Egoruch/HC12/wiring diagram/images/pcb_radiosens_v1.png

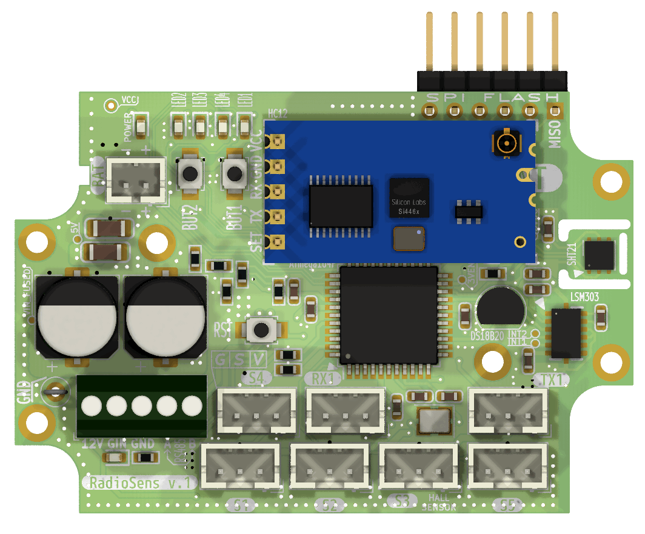
wiring diagram/images/pcb_radiosens_v1.png
