Egoruch/HC12/reports/20221003/1.jpg

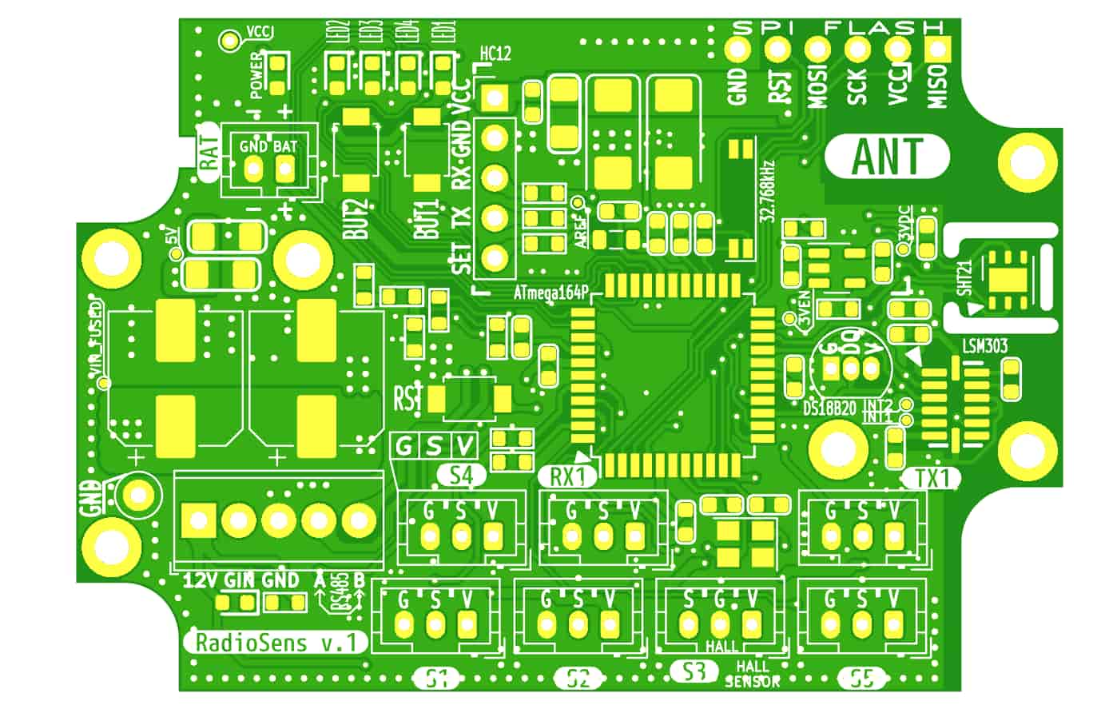
reports/20221003/1.jpg
