Egoruch/HC12/bom/BOM_NOTES.txt

На базе BQ3 заменен на выводоной кварцевый резонатор 3.6864 МГц в корпусе HC49/S
На датчике предохранитель заменен резистором 0 Ом
Датчик температуры DA4 SHT21 не установлен на плате (вместо него установлен DD3 DS18B20)
Компоненты с DNP в поле Assembly не устанавливаются по умолчанию
Подтяжки для любых датчиком, подключаемых к разъему могут быть установлены (имеются посадочные места)
Для базы и датчика установку компонентов смотреть на плате
