Egoruch/HC12/files/raspinovka.txt

Распмновка меги

1 int1 - Вход датчика 2
2 T0   - Вход датчика 3 
3 gnd
4 vpp
5 gnd
6 vpp
7 кварц
8 кварц
9 t1   - Вход датчика 4
10 ain0 - rx hc-12
11 ain1 - tx hc-12
12 icp1 - set hc-12
13 oc1a - 1ware DS18B20
14 oc1b - rs485 set
15 mosi - разьем програматора, подтяжка 4к7 в vpp, кнопка
16 miso - разьем програматора, подтяжка 4к7 в vpp, кнопка
17 sck  - разьем програматора, подтяжка 4к7 в vpp, кнопка
18 avcc - емкость на землю, индуктивность на VPP
19 NC
20 ---
21 gnd
22 NC
23 ADC0 - вход измерения напряжения батареи
24 ADC1
25 ADC2 - led1
26 ADC3 - led2
27 SDA  - i2c
28 SLC  - i2c
29 reset - разьем програматора
30 rxd - rs485 tx
31 txd - rs485 rx
32 int0 - Вход датчика 1

 ATMEGA  164p 324p

1  MOSI - Разьем програматора
2  MISO - Разьем програматора
3  SCK  - Разьем програматора
4  Reset - Разьем програматора
5  VCC - Разьем програматора
6  GND - Разьем програматора
7  Xtal2 - кварц
8  Xtal1 - кварц
9  TXD0 - на rs485
10 RXD0 - на rs485
11 RXD1 -  HC-12
12 TXD1 -  HC-12
13      - на rs485 set 
14      - 1ware DS18B20
15
16
17 VCC
18 GND
19 SLC  - i2c
20 SDA  - i2c
21
22
23
24
25 TOSK1 - кварц 32718 Кгц
26 TOSK2 - кварц 32718 Кгц 
27 AVCC - питание аналоговой части
28 GND 
29 AREF -
30 ADC7 - кнопка
31 ADC6 - кнопка
32 ADC5 - Led
33 ADC4 - Led
34 ADC3 - Led
35 ADC2 - Led
36
37 ADC0 - вход измерения напряжения батареи
38 VCC
39 GND
40 T0   - датчик
41 T1   - датчик
42 Int2 - датчик
43      - датчик
44      - датчик

 Разьем програматора рекомендуюиспользовать 6 в ряд с шагом 2,54
как изовражено на платах образцах с диаметром отверстий 1.0мм X 1.8
в последующем (серийном ) исполнении вместо разьема будут использоваться только площадки
