Egoruch/HC12/reports/20221006/radiosens_report_20221006.txt

Электрическая схема радиодатчика:
https://drive.google.com/file/d/1U-78wbJ-Mu7dbrbfMm--YsTQ_heRFNcY/view?usp=sharing
Спецификации на комплектующие:
https://docs.google.com/spreadsheets/d/1wJYobUlirJagnpwVgyCYauzqecT7cTif/edit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
Монтажная схема радиодатчика:
https://drive.google.com/file/d/1Tp2sTwzi-Ly-wEZ6M84Gb-yMDyOYbHYp/view?usp=sharing
ПП радиодатчика:
https://drive.google.com/drive/folders/1lfkVosFPX9y5FLTUVtVRRMeN4wk9LlCC?usp=sharing
Модель платы (с корпусом):
https://drive.google.com/drive/folders/1NUICps0BwOciWtpKbLGdB7HsDqwth-54?usp=sharing
Gerber файлы для производства (добавлена версия с пастой):
https://drive.google.com/drive/folders/1iUnzhOaEHeU_WpuIBQ32vcUq3tqi_gd5?usp=sharing
