Egoruch/HC12/3dm/1.png

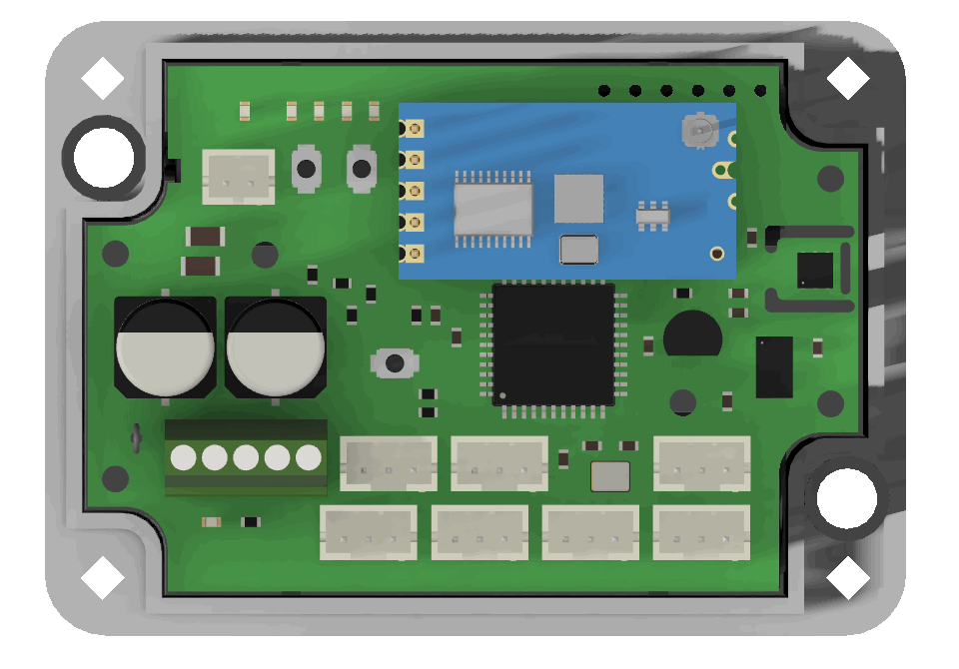
3dm/1.png
