Egoruch/HC12/3dm/2.png

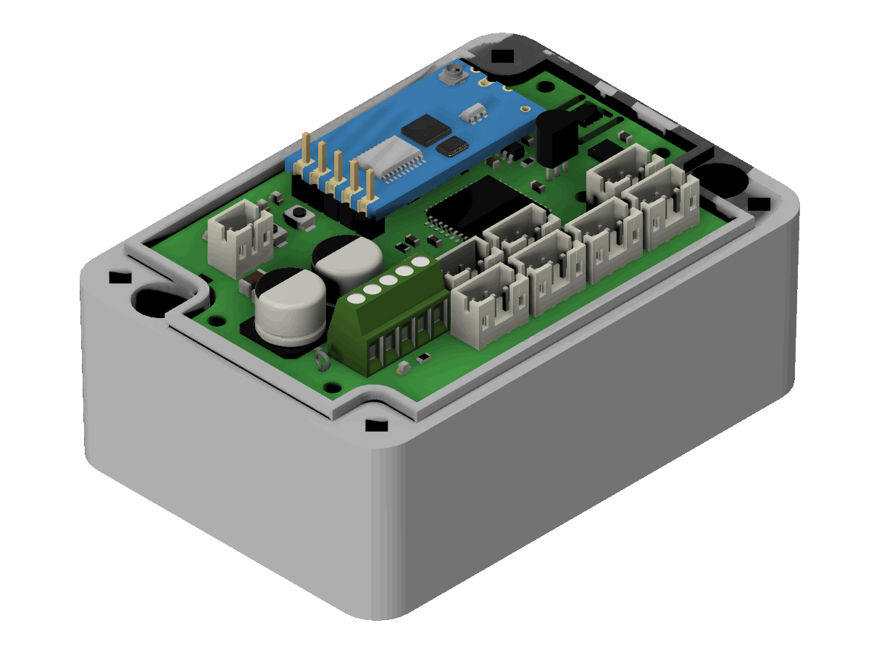
3dm/2.png
