Egoruch/HC12/3dm/3.png

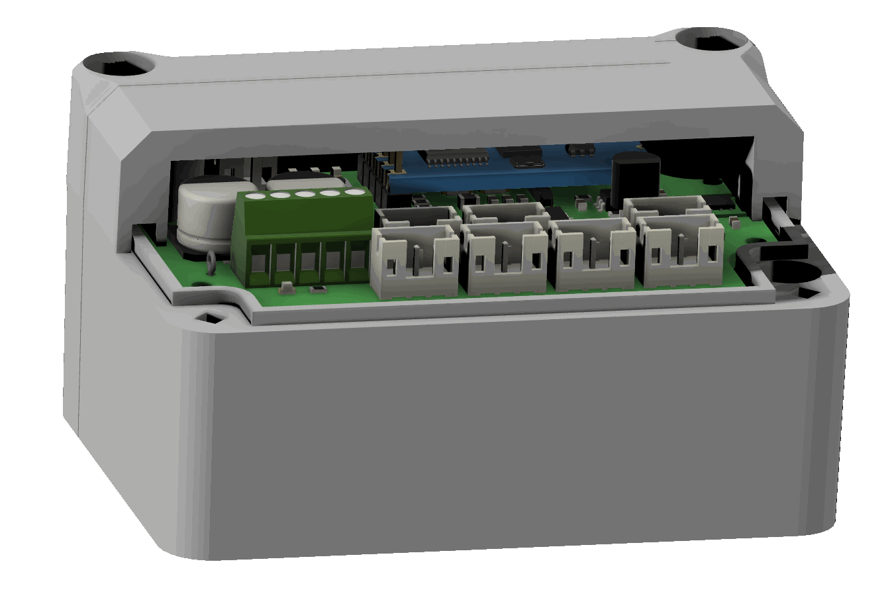
3dm/3.png
