Egoruch/HC12/3dm/5.png

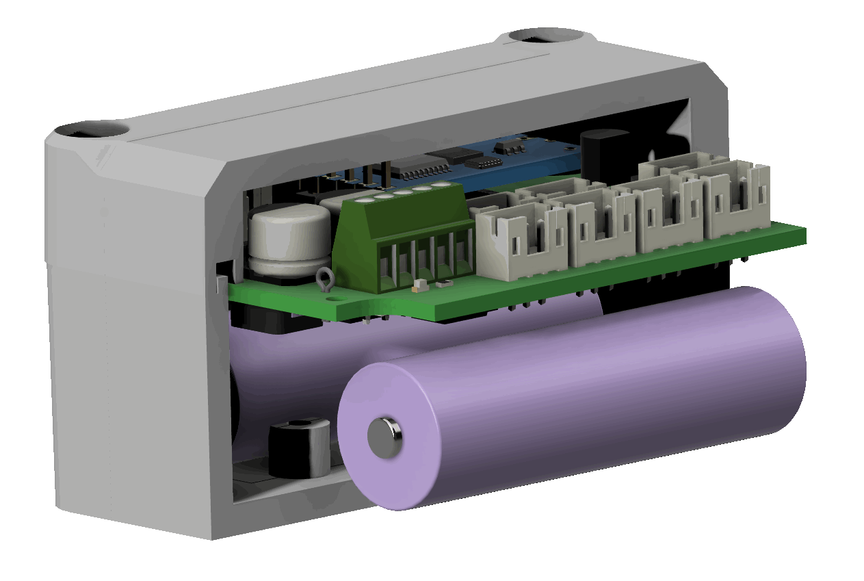
3dm/5.png
