Egoruch/HC12/3dm/6.png

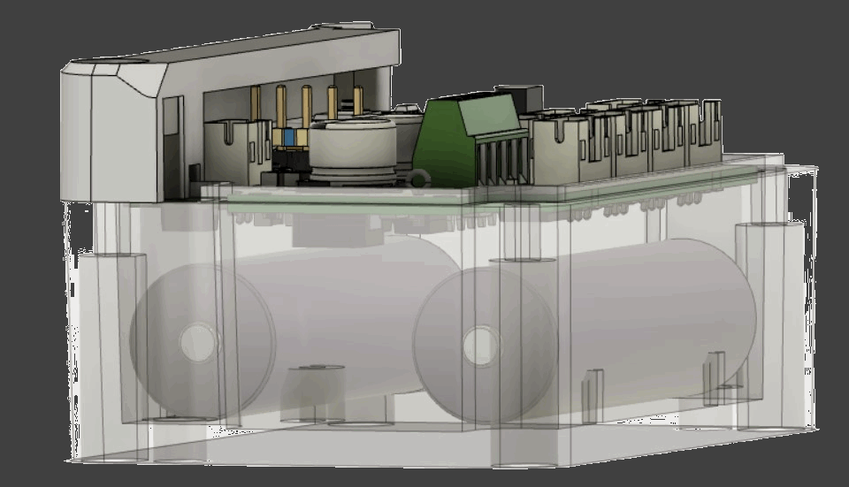
3dm/6.png
