Egoruch/HC12/acceptance/photos/IMG_20221020_171816.jpg

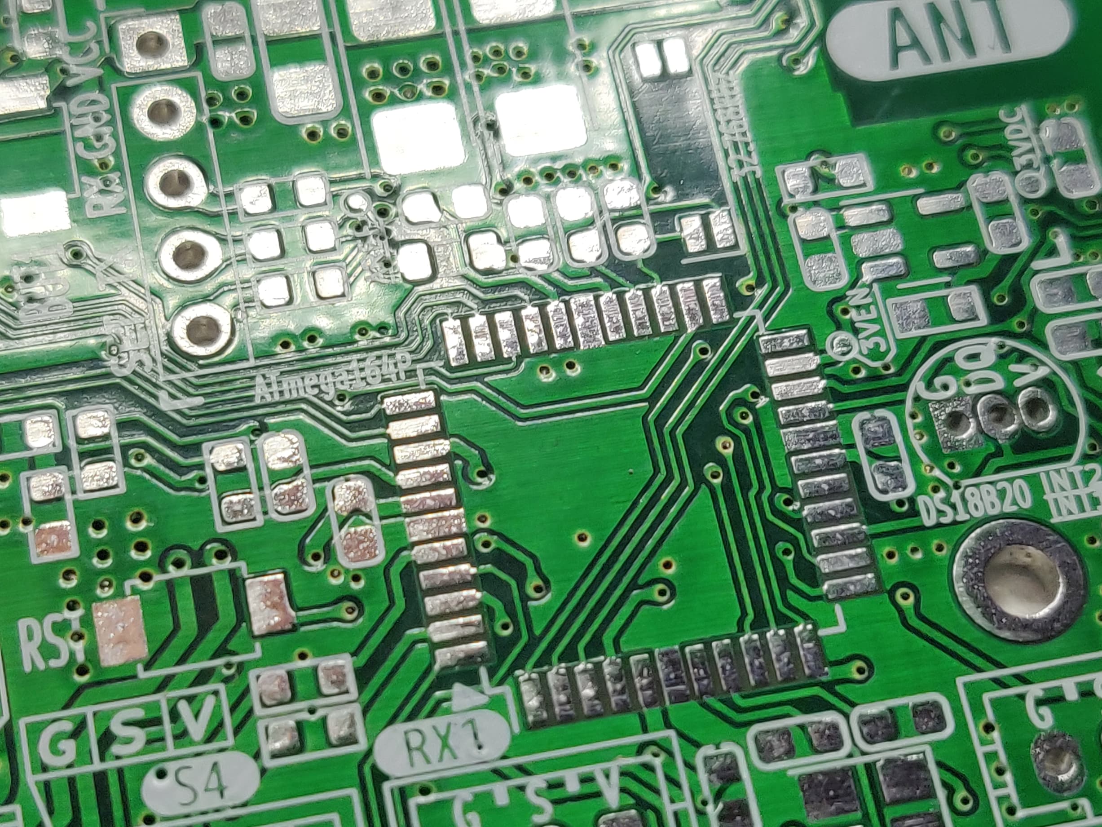
acceptance/photos/IMG_20221020_171816.jpg
