Egoruch/HC12/acceptance/photos/IMG_20221020_171834.jpg

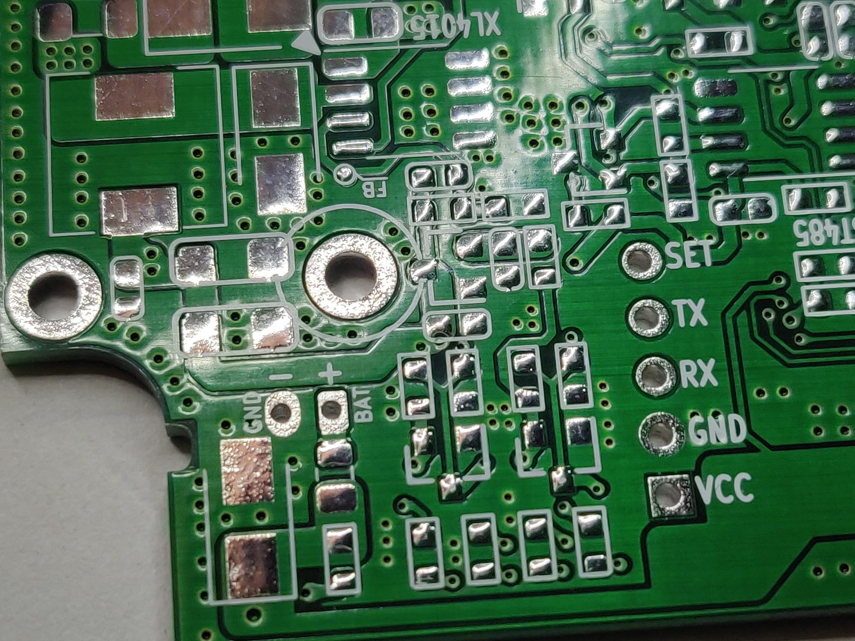
acceptance/photos/IMG_20221020_171834.jpg
