Egoruch/HC12/acceptance/photos/IMG_20221020_171857.jpg

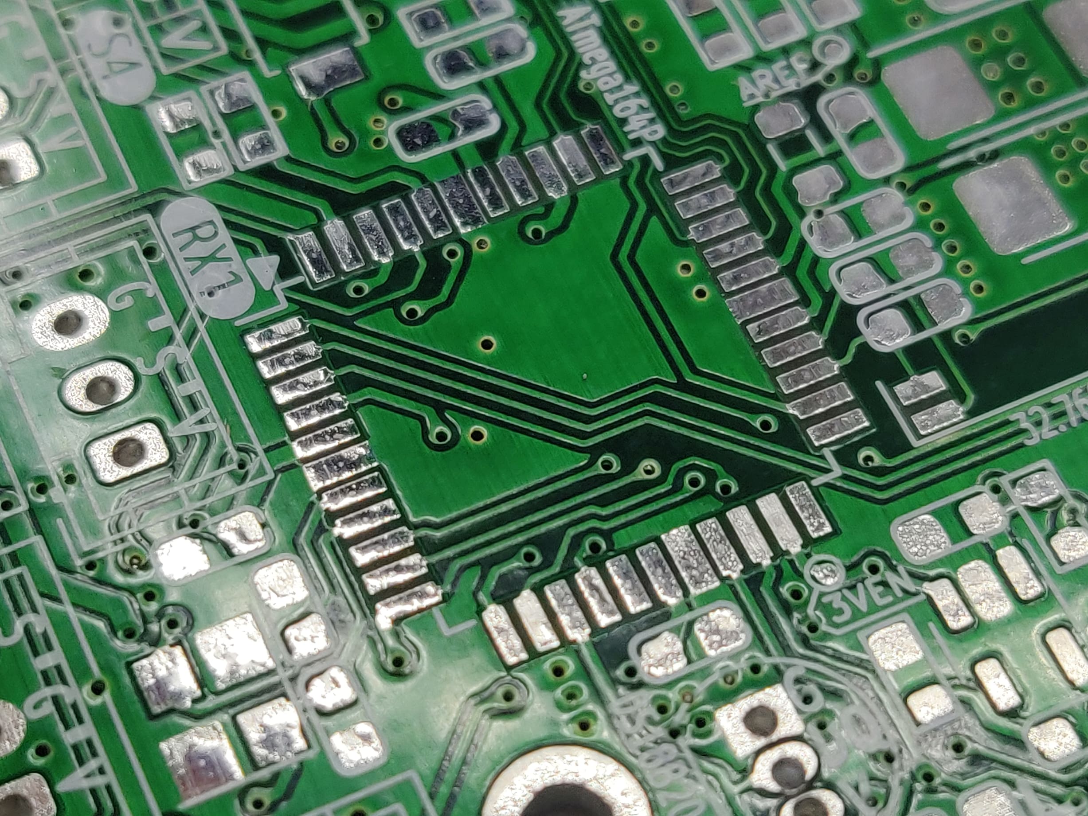
acceptance/photos/IMG_20221020_171857.jpg
