Egoruch/HC12/acceptance/photos/IMG_20221020_171904.jpg

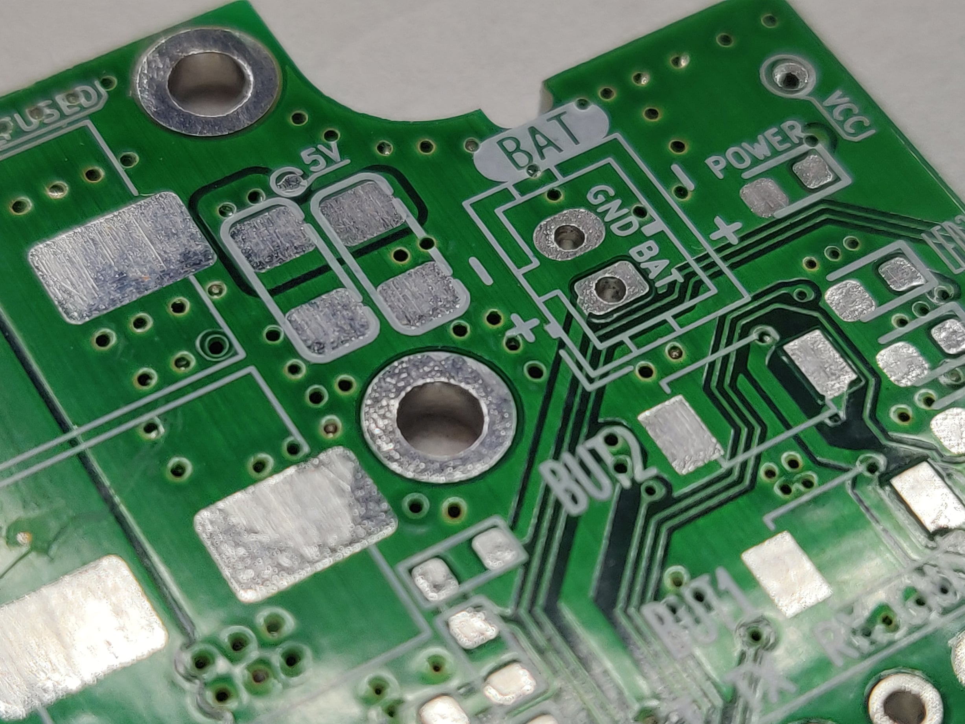
acceptance/photos/IMG_20221020_171904.jpg
