Egoruch/HC12/diagrams/HC12_Functional_Diagram.jpg

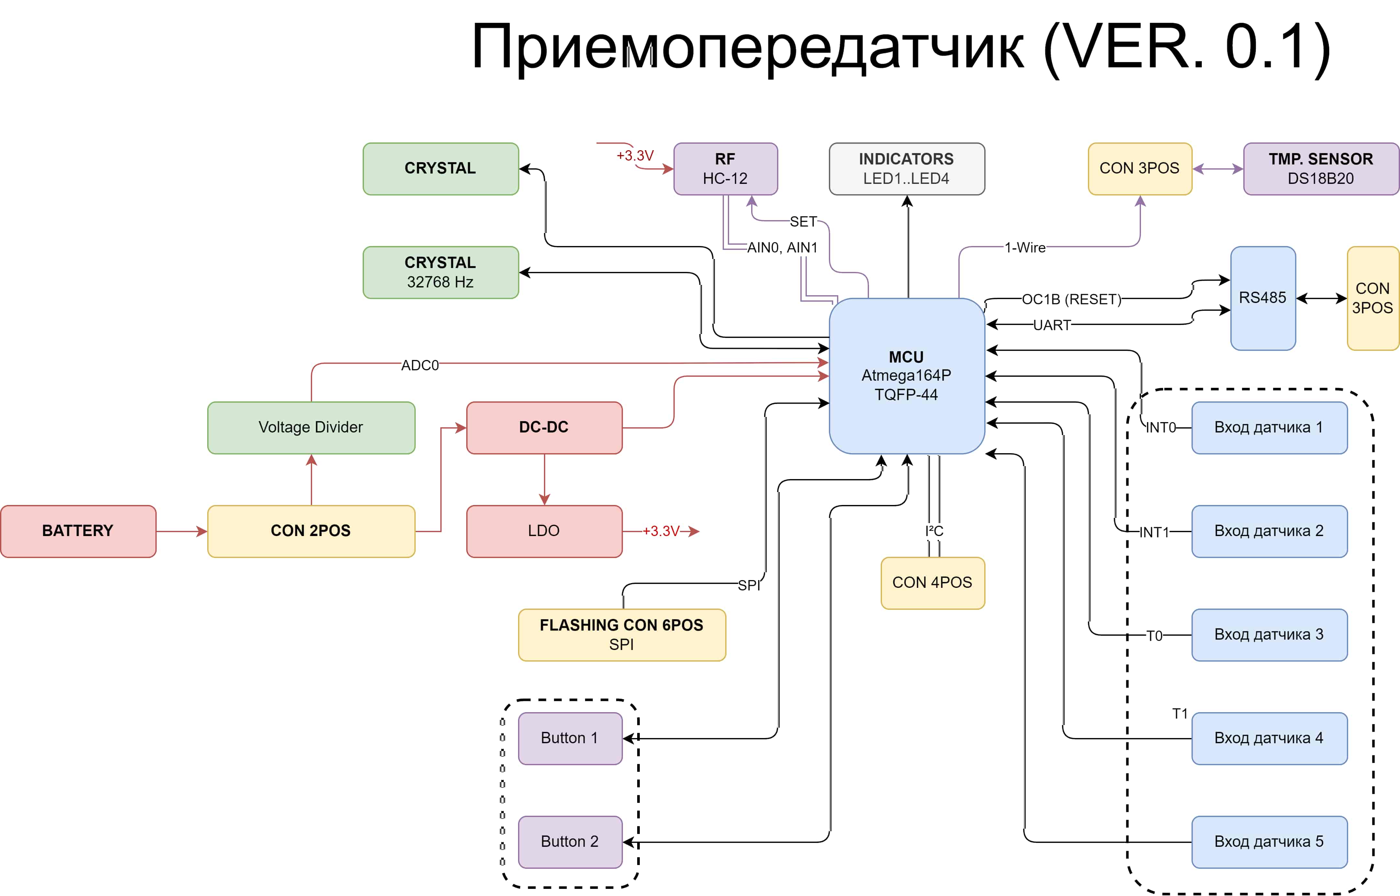
diagrams/HC12_Functional_Diagram.jpg
