Egoruch/HC12/kicad/Gerber/RadioSens_Gerber_Paste_20221006_2.jpg

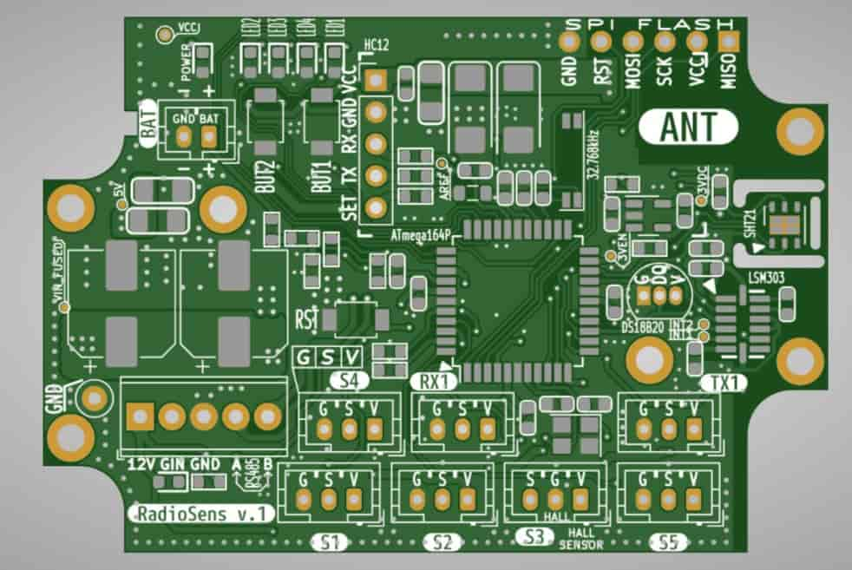
kicad/Gerber/RadioSens_Gerber_Paste_20221006_2.jpg
