Egoruch/HC12/reports/20220110/1.jpg

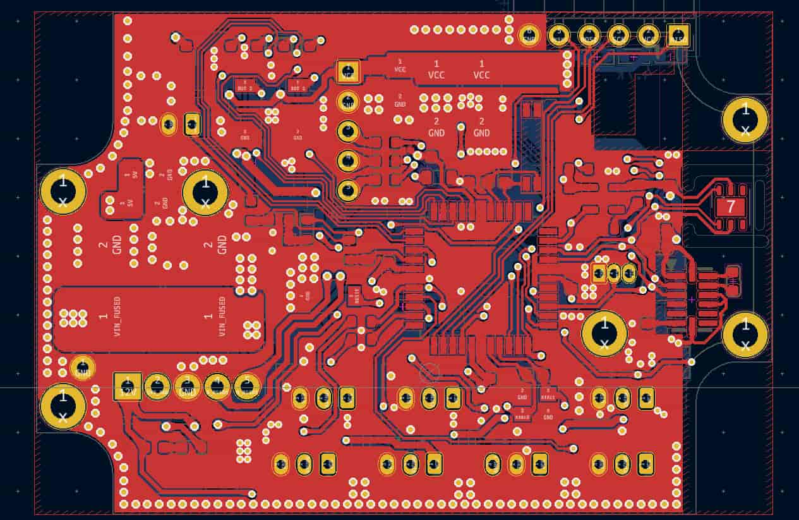
reports/20220110/1.jpg
