Egoruch/HC12/reports/20220110/2.jpg

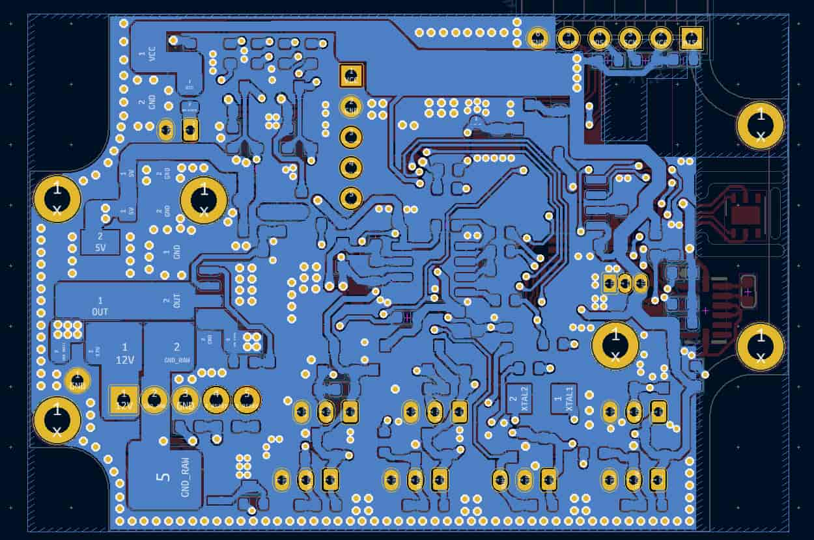
reports/20220110/2.jpg
