Egoruch/HC12/reports/20220110/3.jpg

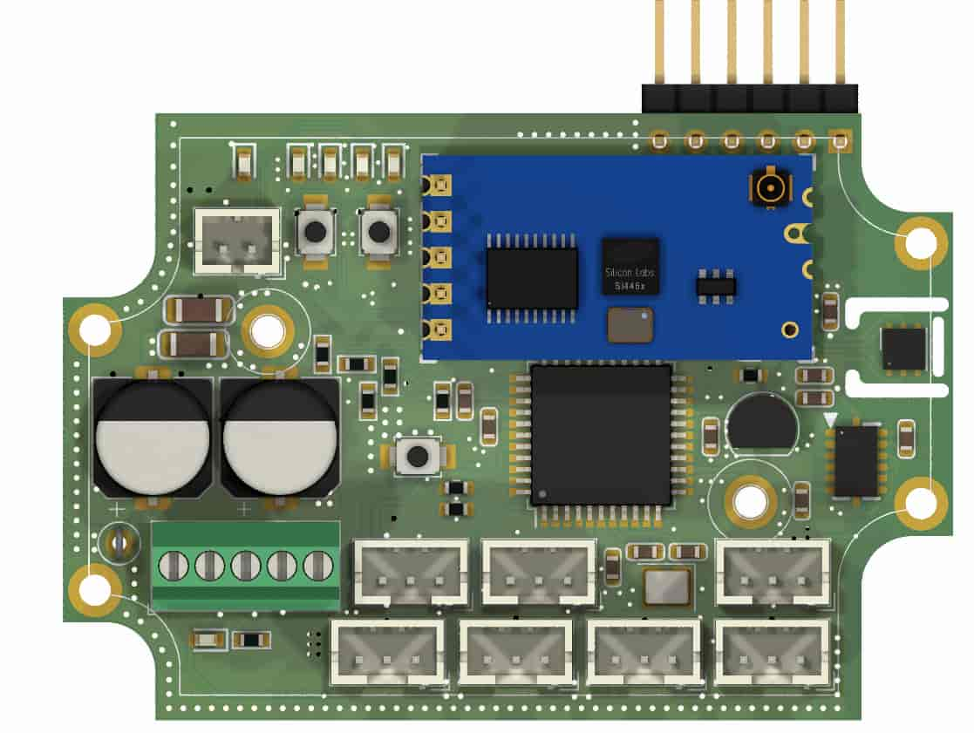
reports/20220110/3.jpg
