Egoruch/HC12/reports/20220110/4.jpg

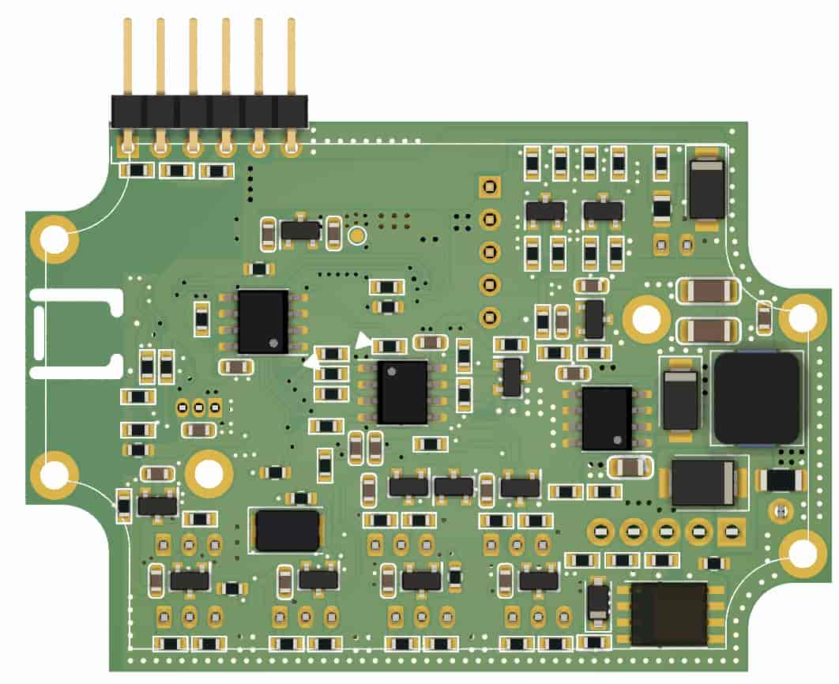
reports/20220110/4.jpg
