Egoruch/HC12/reports/20220907/pcb_3d_raw_1.png

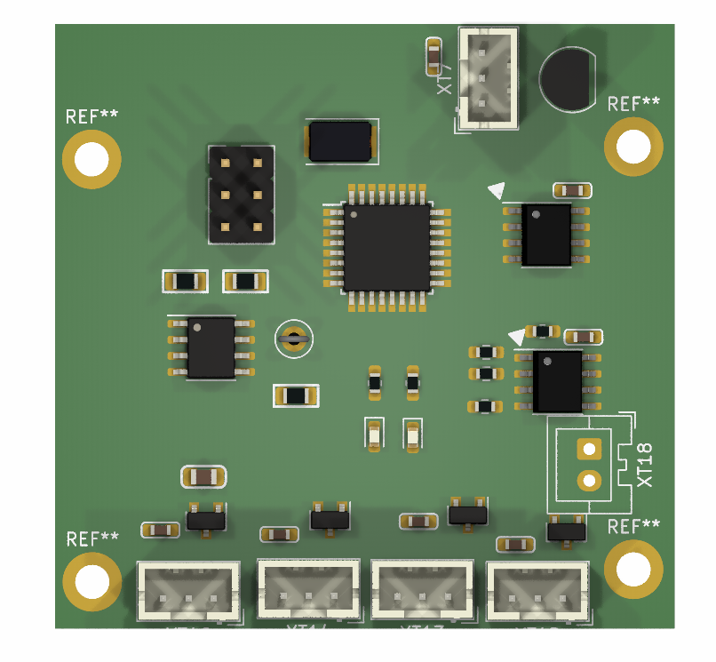
reports/20220907/pcb_3d_raw_1.png
