Egoruch/HC12/reports/20220907/pcb_3d_raw_2.png

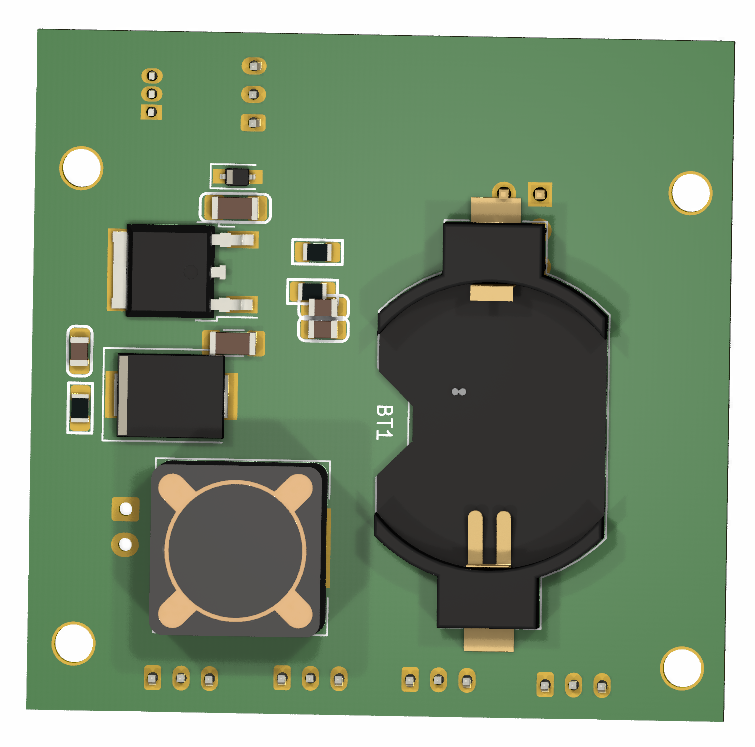
reports/20220907/pcb_3d_raw_2.png
