Egoruch/HC12/reports/20220911/1.jpg

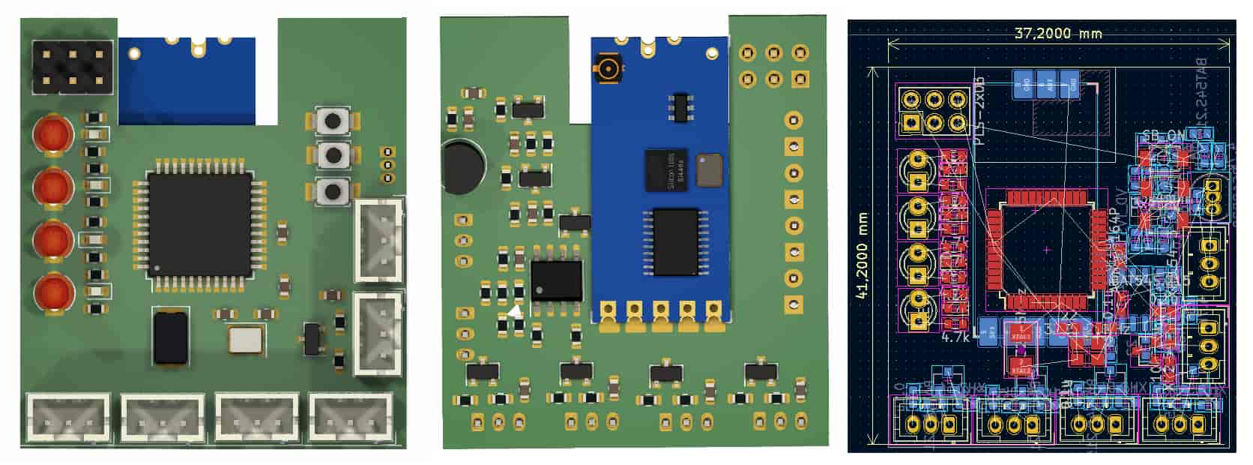
reports/20220911/1.jpg
