Egoruch/HC12/reports/20220911/2.jpg

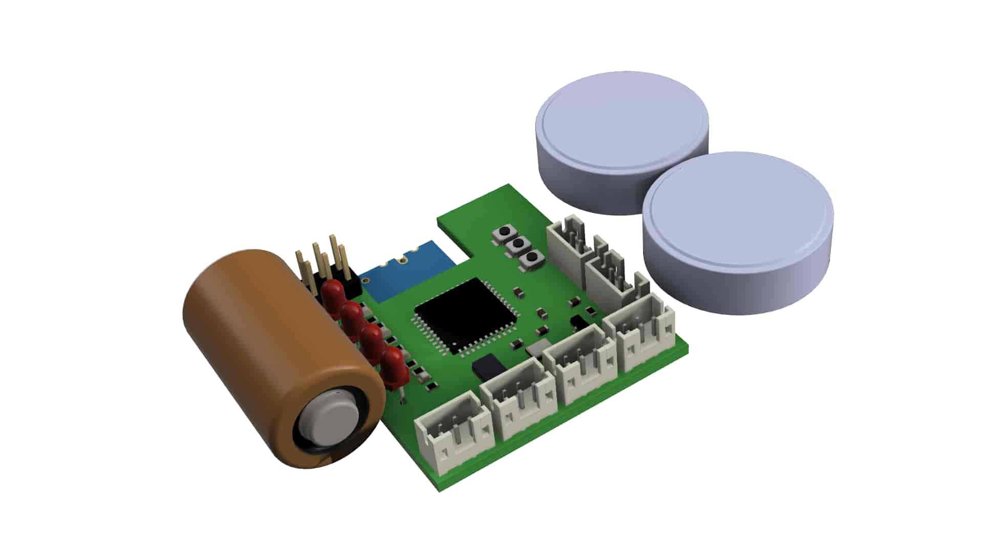
reports/20220911/2.jpg
