Egoruch/HC12/reports/20220911/3.jpg

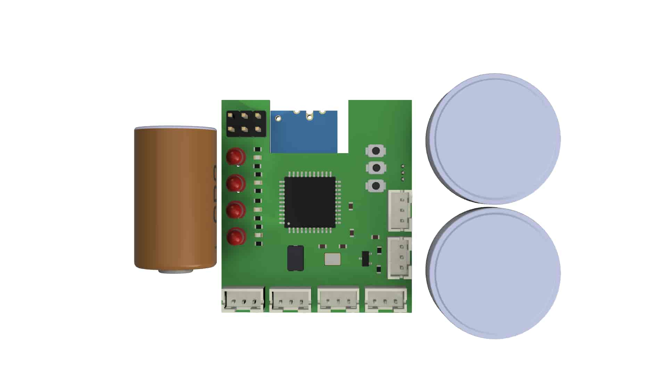
reports/20220911/3.jpg
