Egoruch/HC12/reports/20220911/4.jpg

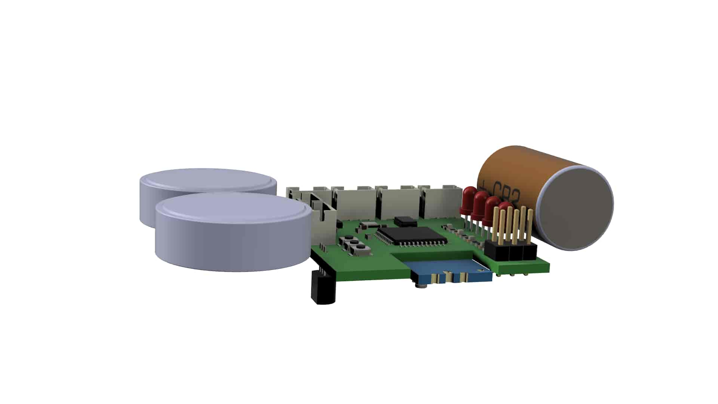
reports/20220911/4.jpg
