Egoruch/HC12/reports/20220913/1.jpg

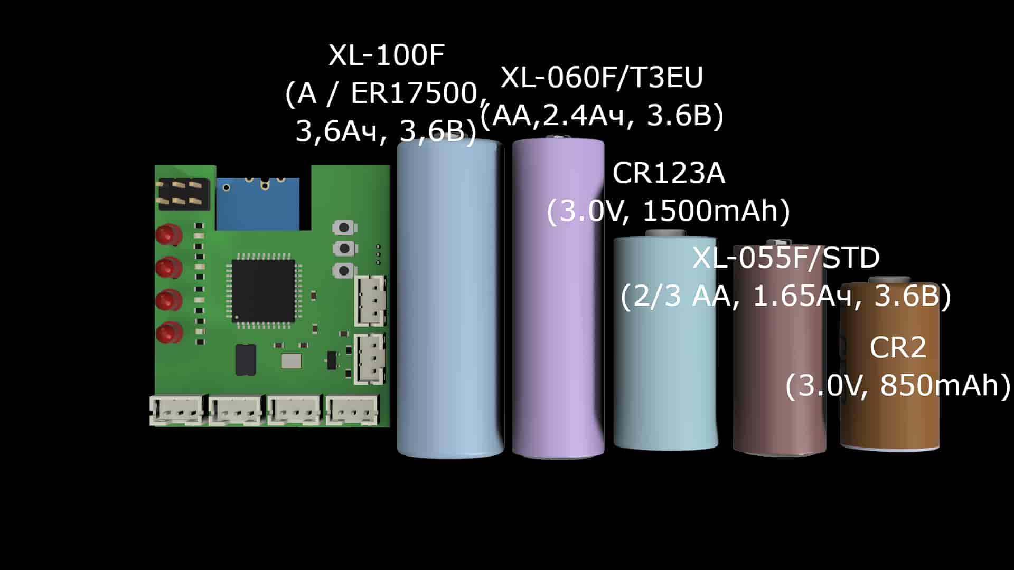
reports/20220913/1.jpg
