Egoruch/HC12/reports/20220913/2.jpg

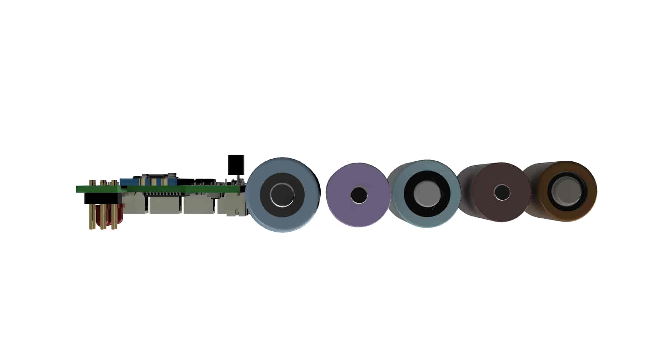
reports/20220913/2.jpg
