Egoruch/HC12/reports/20220913/3.jpg

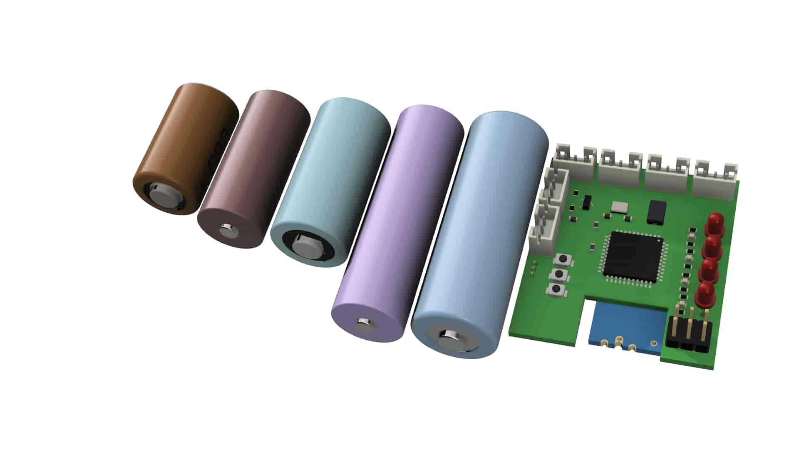
reports/20220913/3.jpg
