Egoruch/HC12/reports/20220913/4.jpg

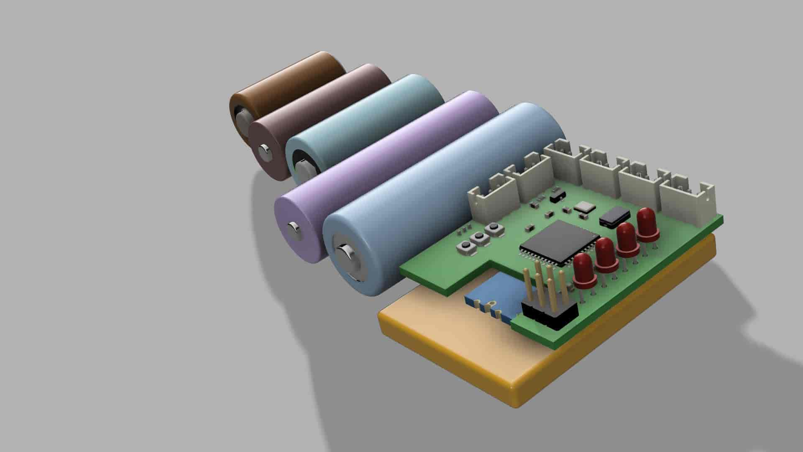
reports/20220913/4.jpg
