Egoruch/HC12/reports/20220913/5.jpg

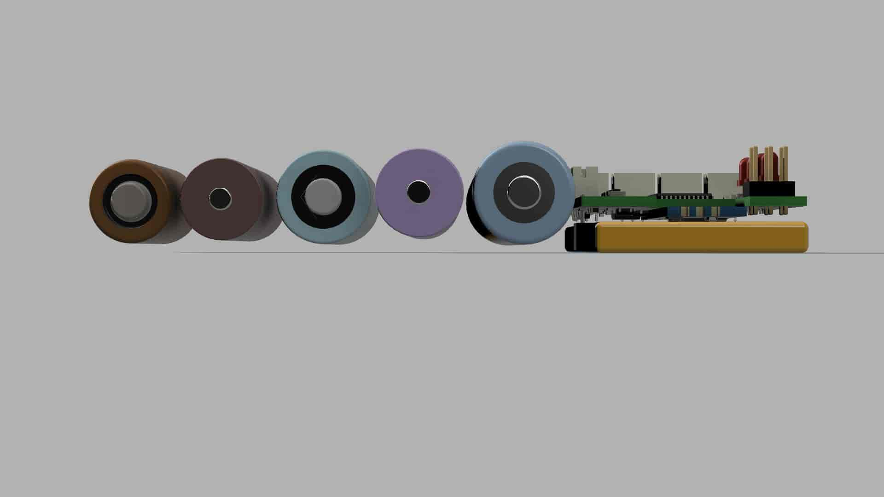
reports/20220913/5.jpg
