Egoruch/HC12/reports/20220913/6.jpg

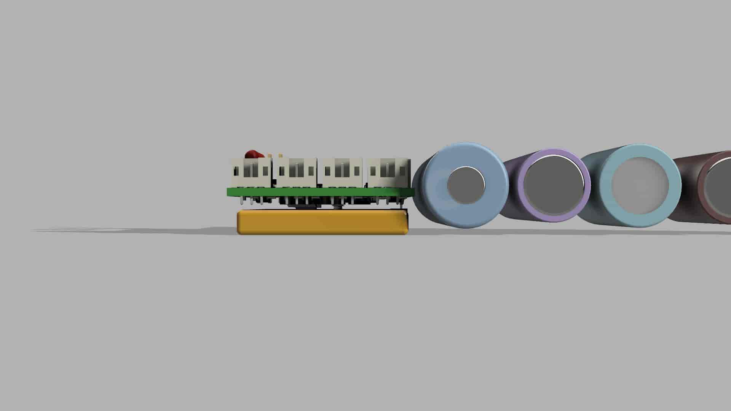
reports/20220913/6.jpg
