Egoruch/HC12/reports/20220914/1.jpg

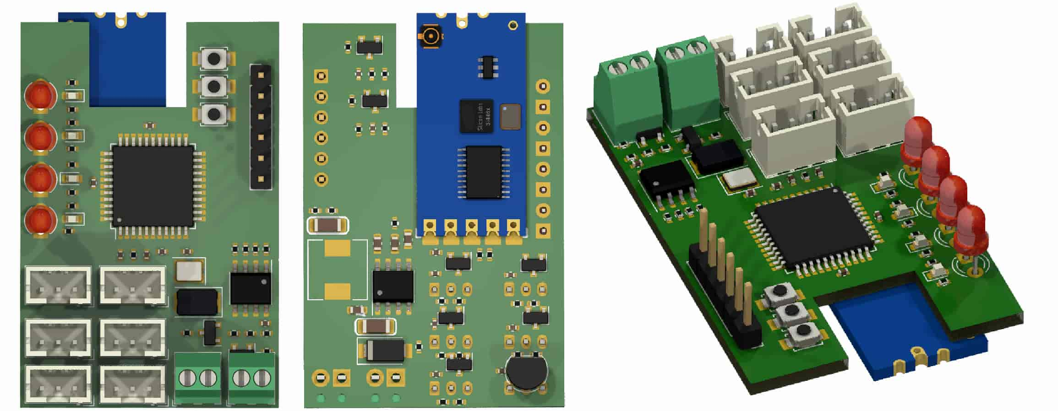
reports/20220914/1.jpg
