Egoruch/HC12/reports/20220915/1.jpg

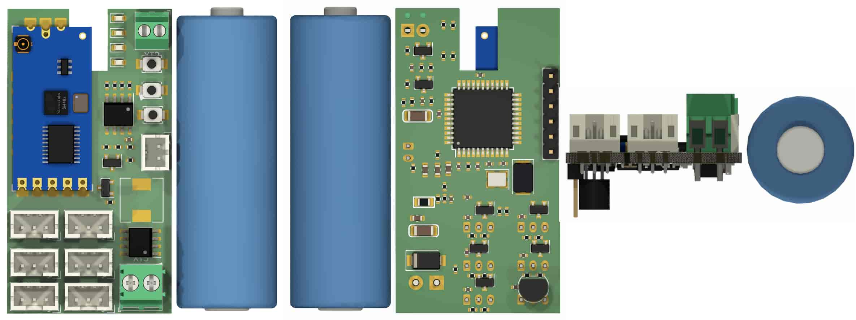
reports/20220915/1.jpg
