Egoruch/HC12/reports/20220917/l.jpg

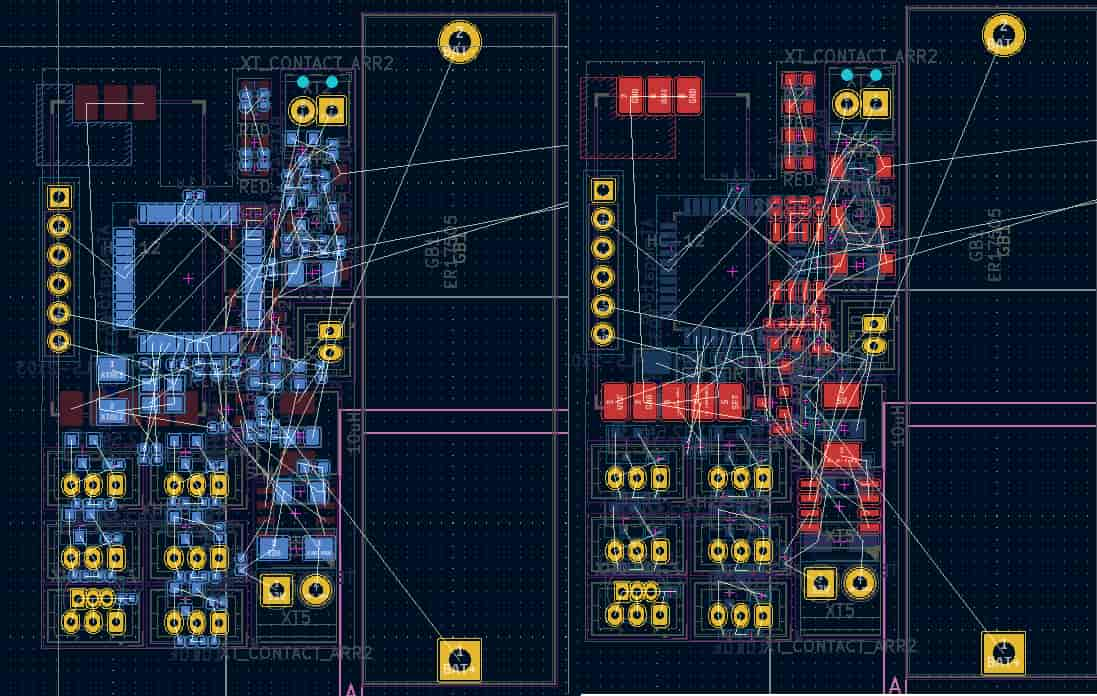
reports/20220917/l.jpg
