Egoruch/HC12/reports/20220918/1.jpg

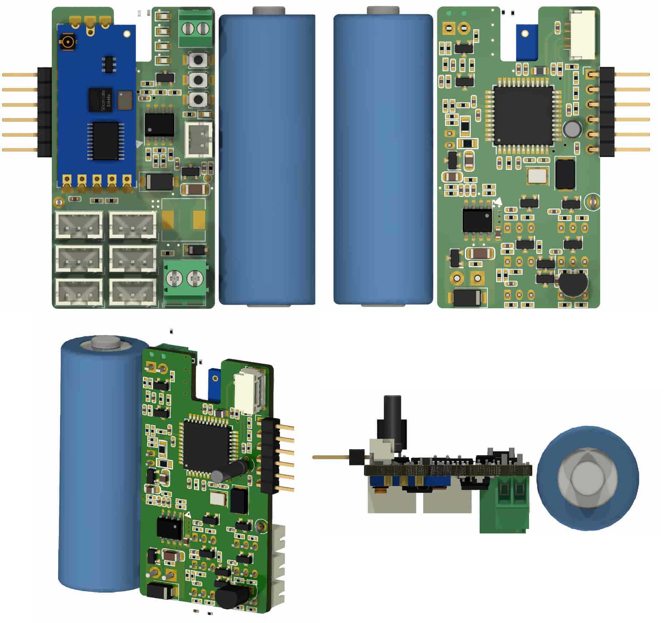
reports/20220918/1.jpg
