Egoruch/HC12/reports/20220918/2.jpg

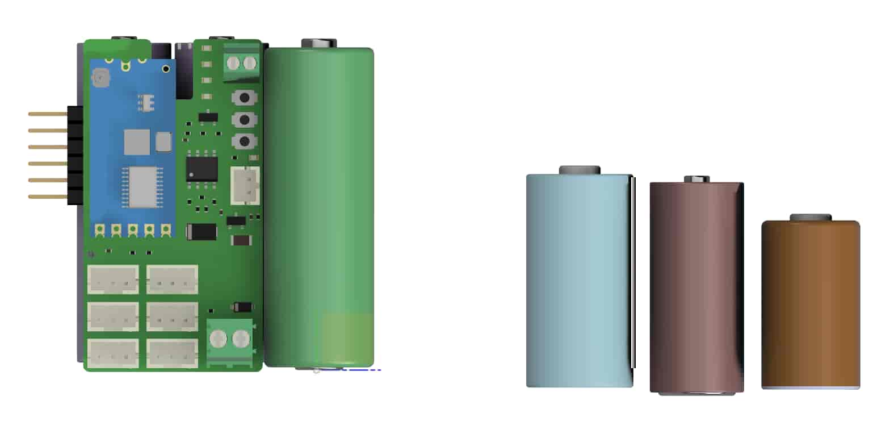
reports/20220918/2.jpg
