Egoruch/HC12/reports/20220918/3.jpg

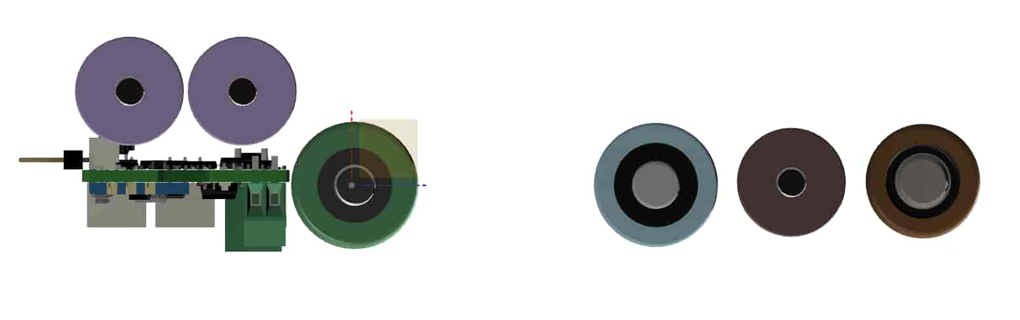
reports/20220918/3.jpg
