Egoruch/HC12/reports/20220918/4.jpg

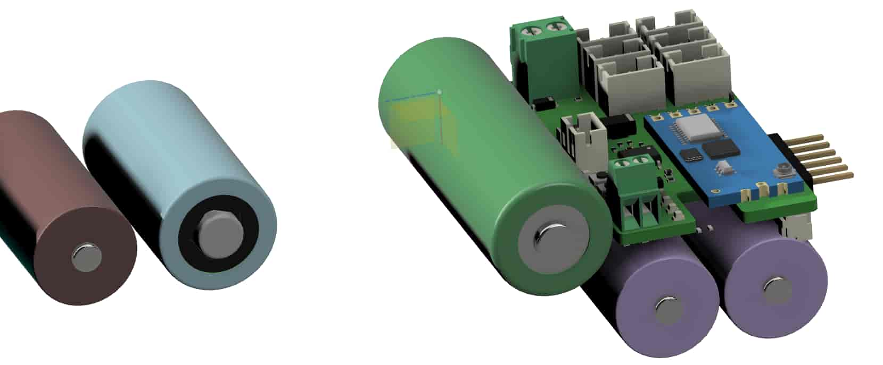
reports/20220918/4.jpg
