Egoruch/HC12/reports/20220918/5.jpg

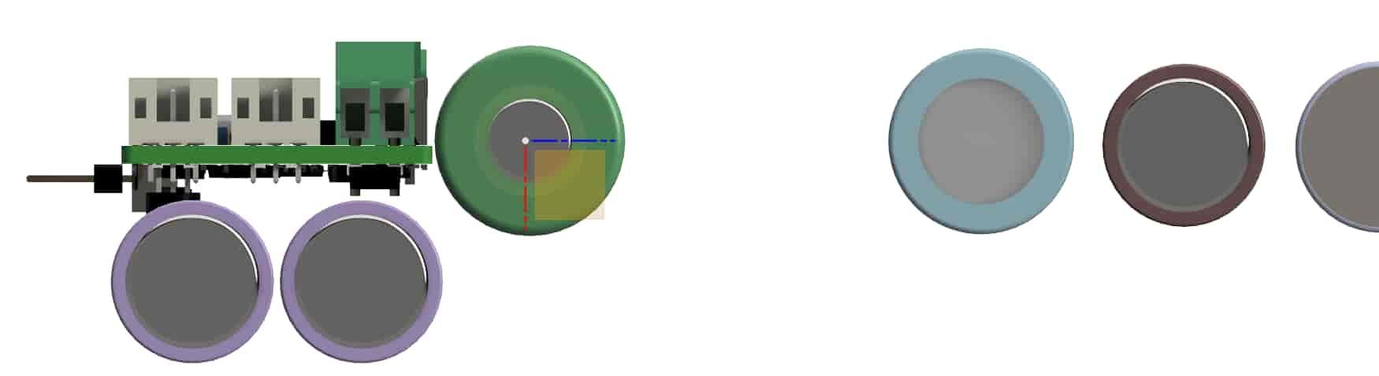
reports/20220918/5.jpg
