Egoruch/HC12/reports/20220921/cases_selection.jpg

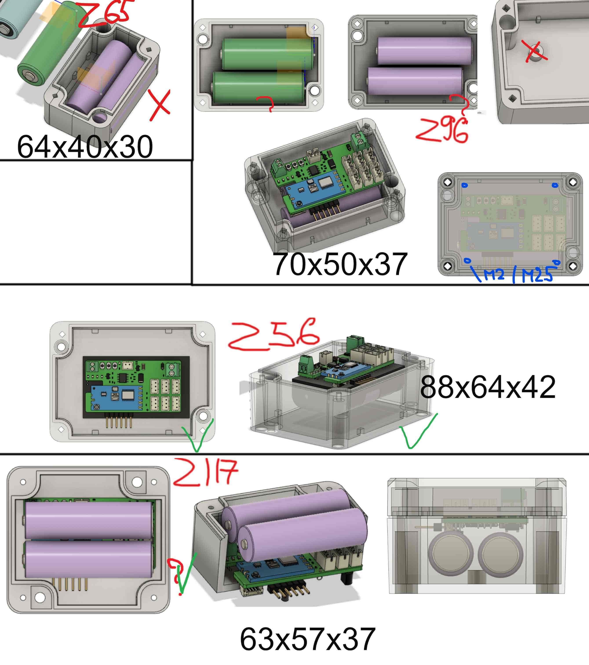
reports/20220921/cases_selection.jpg
