Egoruch/HC12/reports/20220929/1.jpg

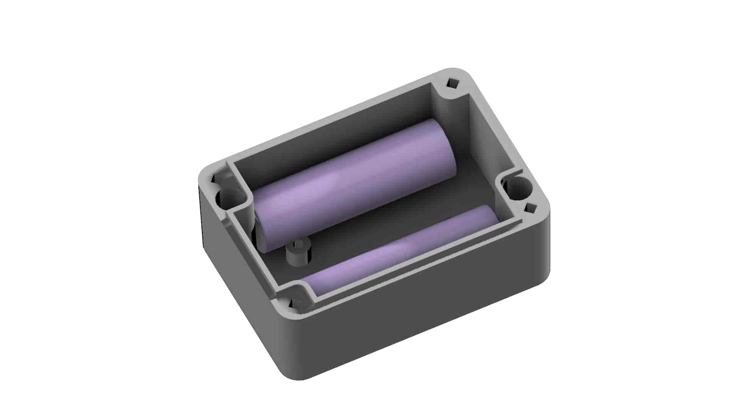
reports/20220929/1.jpg
