Egoruch/HC12/reports/20220929/2.jpg

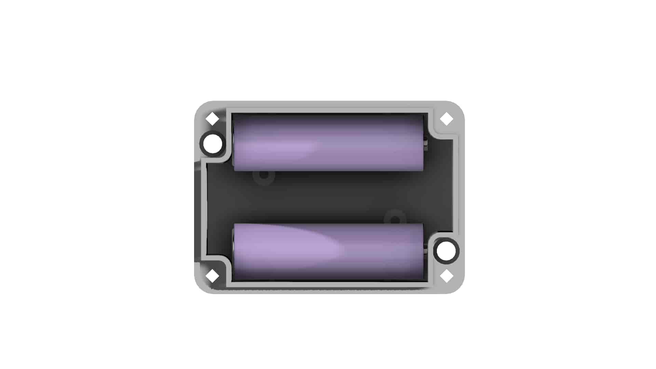
reports/20220929/2.jpg
