Egoruch/HC12/reports/20220929/3.jpg

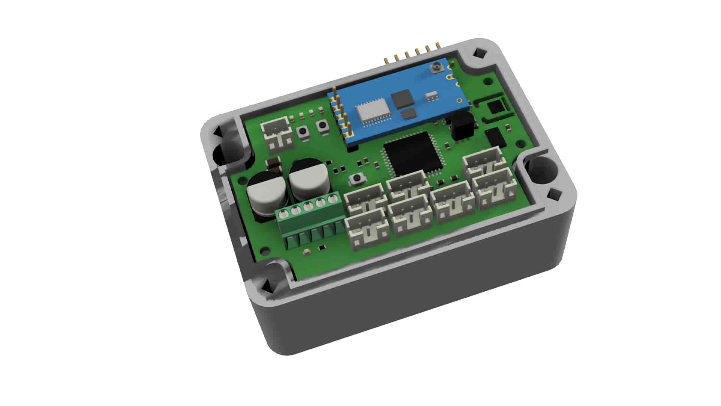
reports/20220929/3.jpg
