Egoruch/HC12/reports/20220929/4.jpg

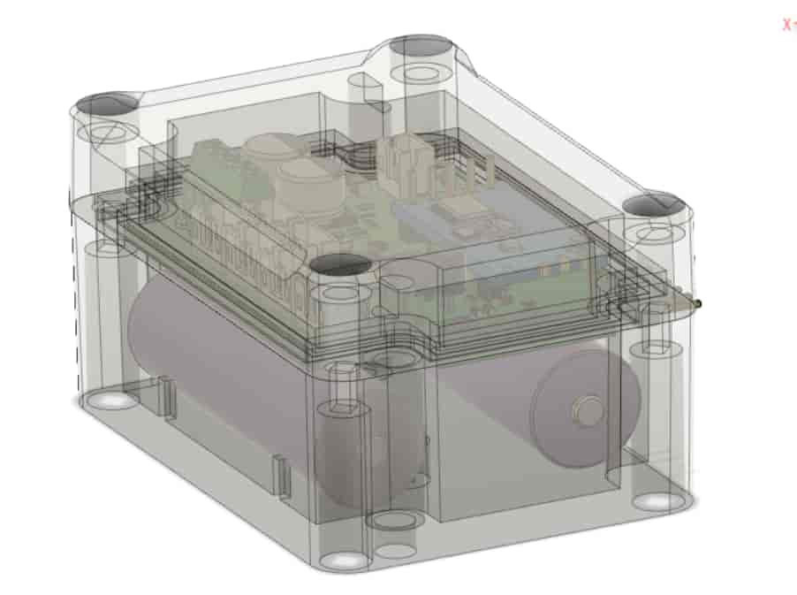
reports/20220929/4.jpg
