Egoruch/HC12/reports/20220929/5.jpg

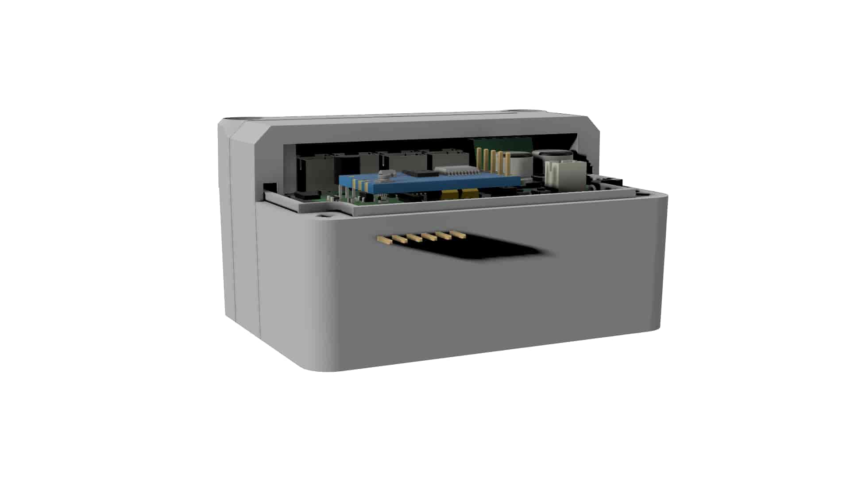
reports/20220929/5.jpg
