Egoruch/HC12/reports/20220929/6.jpg

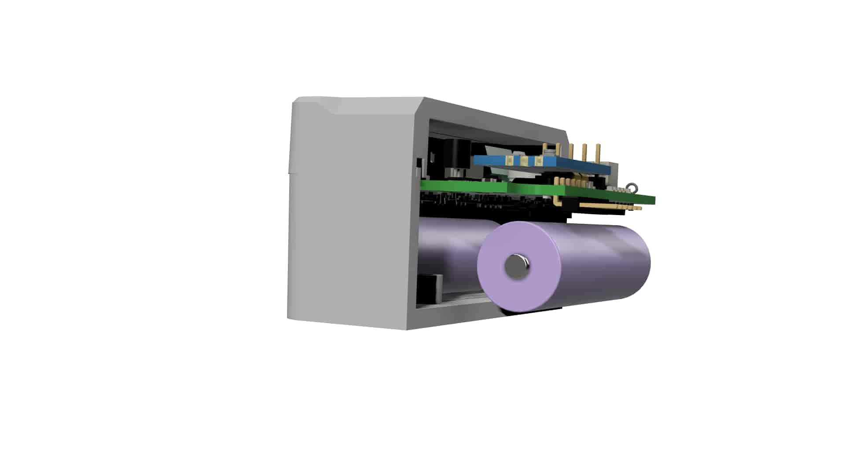
reports/20220929/6.jpg
