Egoruch/HC12/reports/20221003/2.jpg

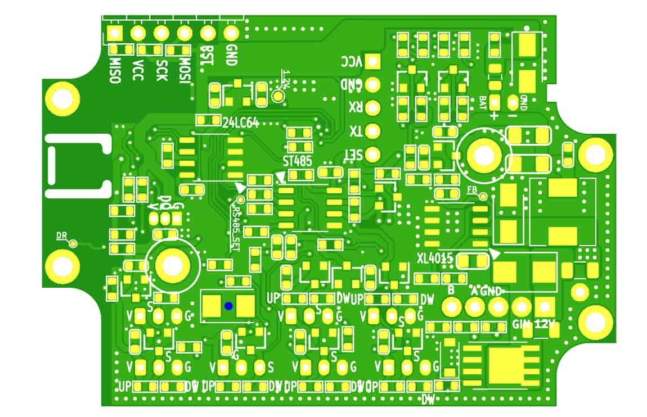
reports/20221003/2.jpg
