Egoruch/HC12/reports/20221003/3.jpg

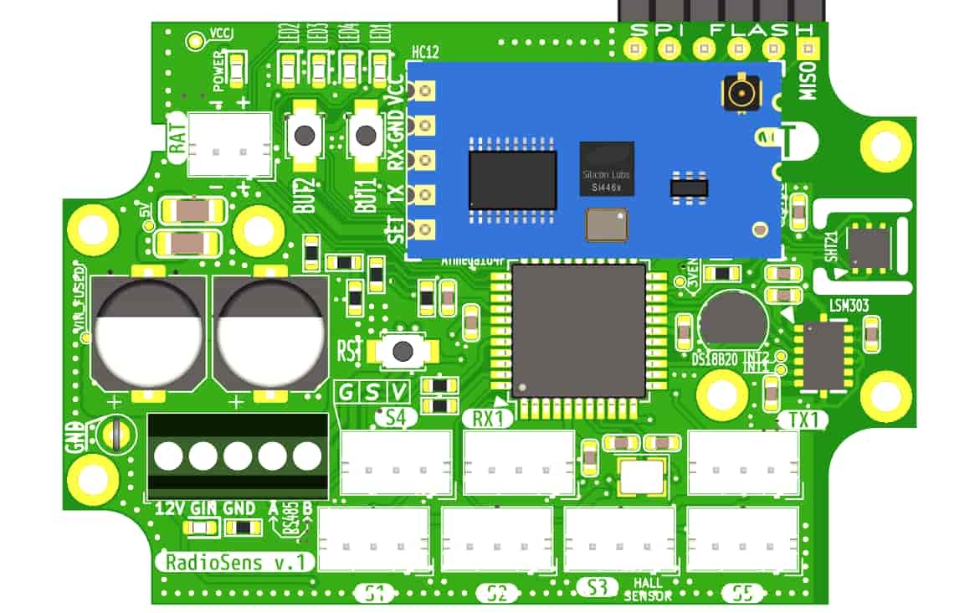
reports/20221003/3.jpg
