Egoruch/HC12/reports/20221003/4.jpg

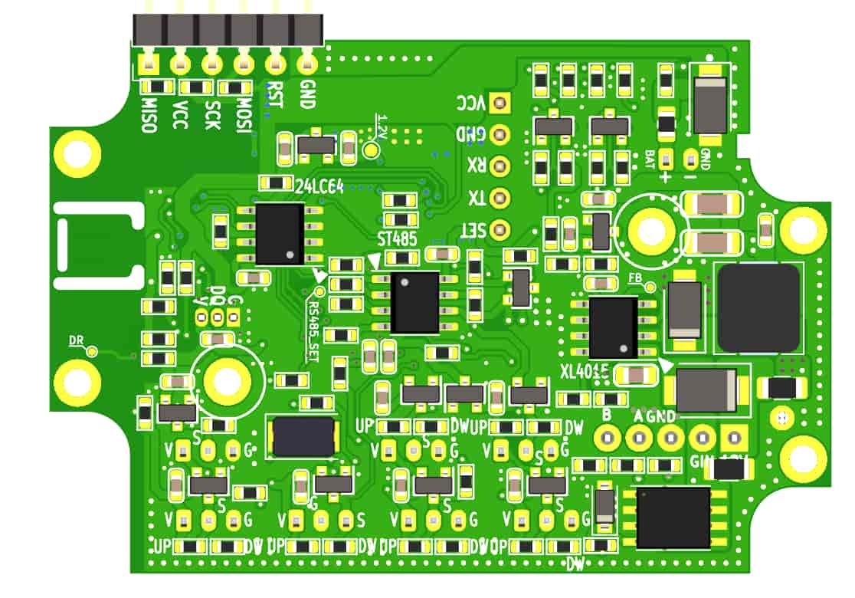
reports/20221003/4.jpg
