Egoruch/HC12/reports/20221003/5.jpg

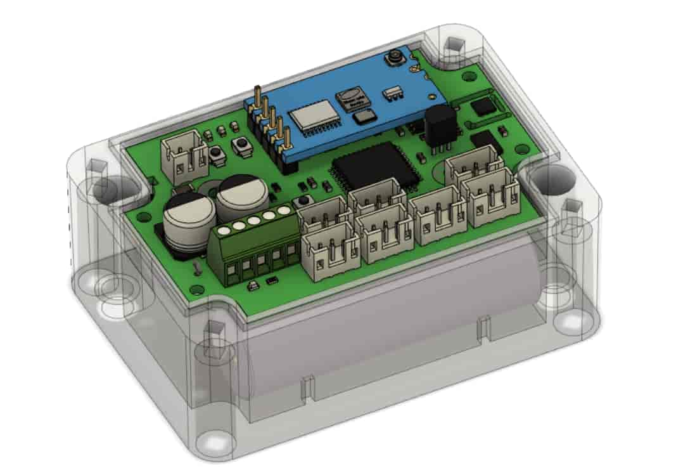
reports/20221003/5.jpg
