Egoruch/HC12/reports/20221003/6.jpg

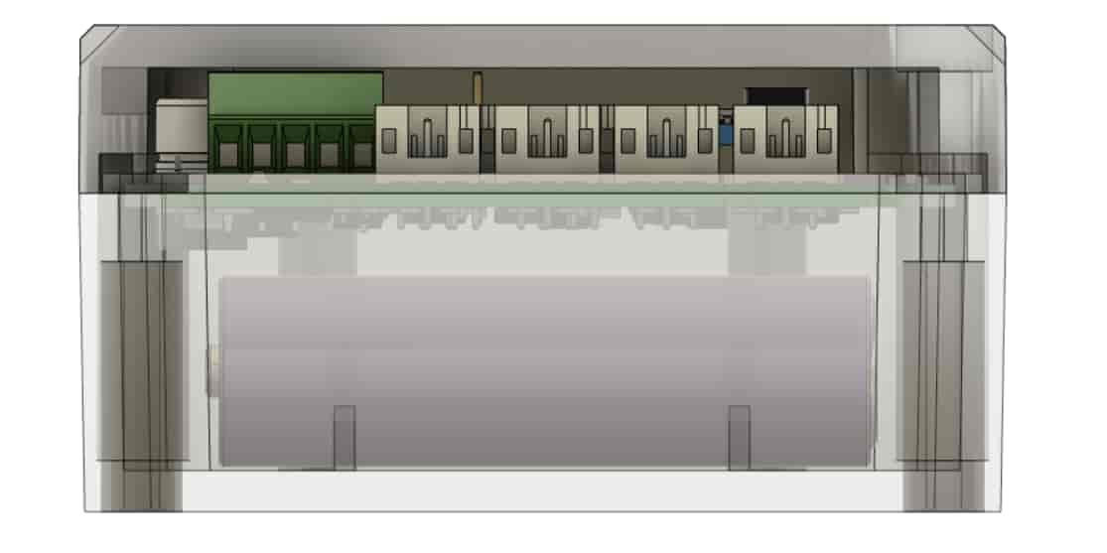
reports/20221003/6.jpg
