Egoruch/HC12/reports/20221003/7.jpg

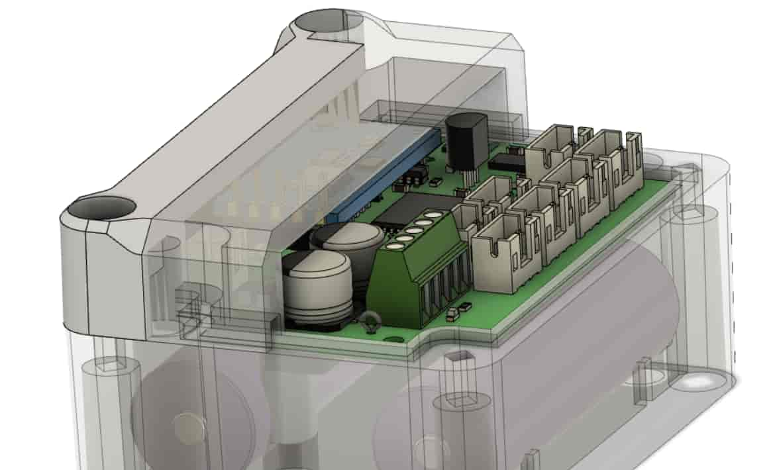
reports/20221003/7.jpg
