Egoruch/HC12/reports/20221006/1.jpg

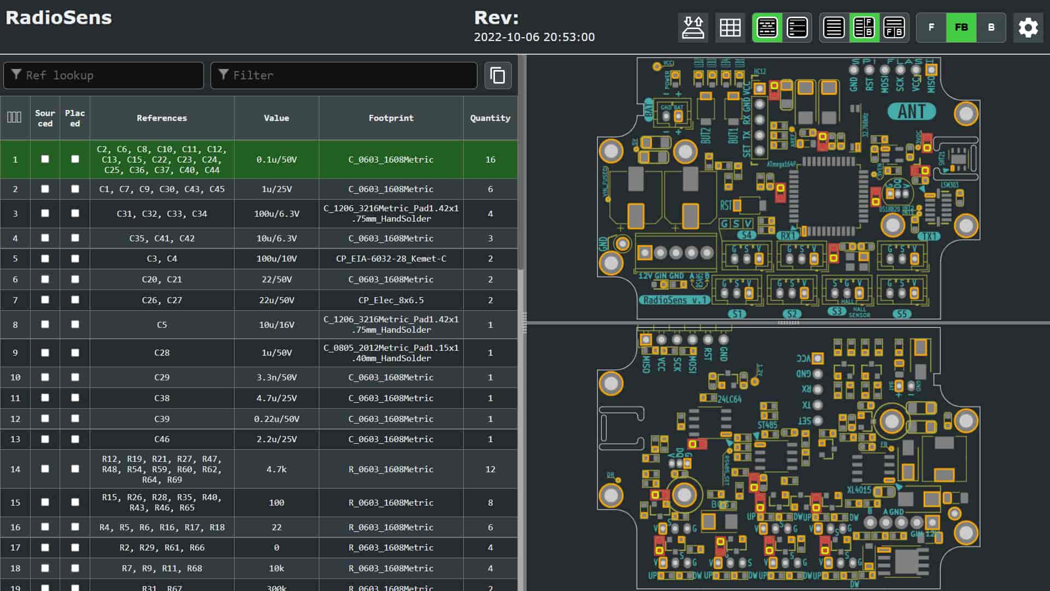
reports/20221006/1.jpg
