Egoruch/HC12/reports/20221006/2.jpg

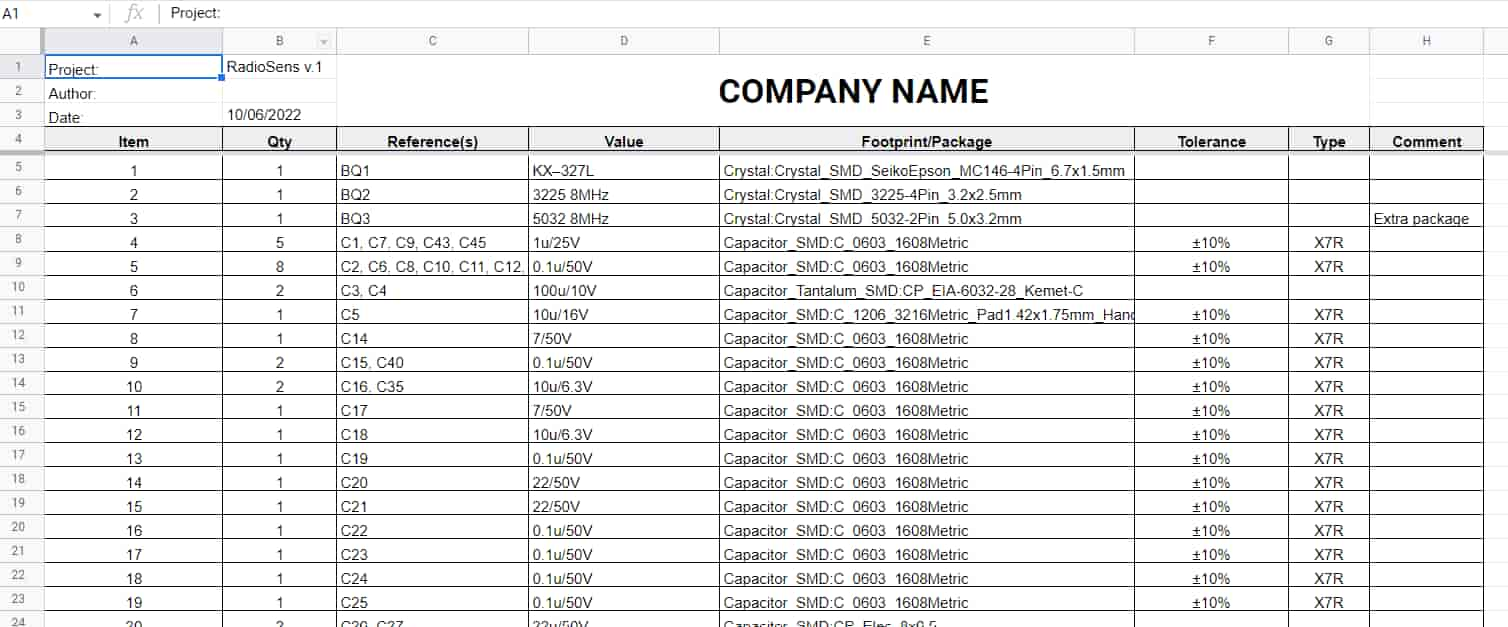
reports/20221006/2.jpg
