Egoruch/HC12/reports/20221006/3.jpg

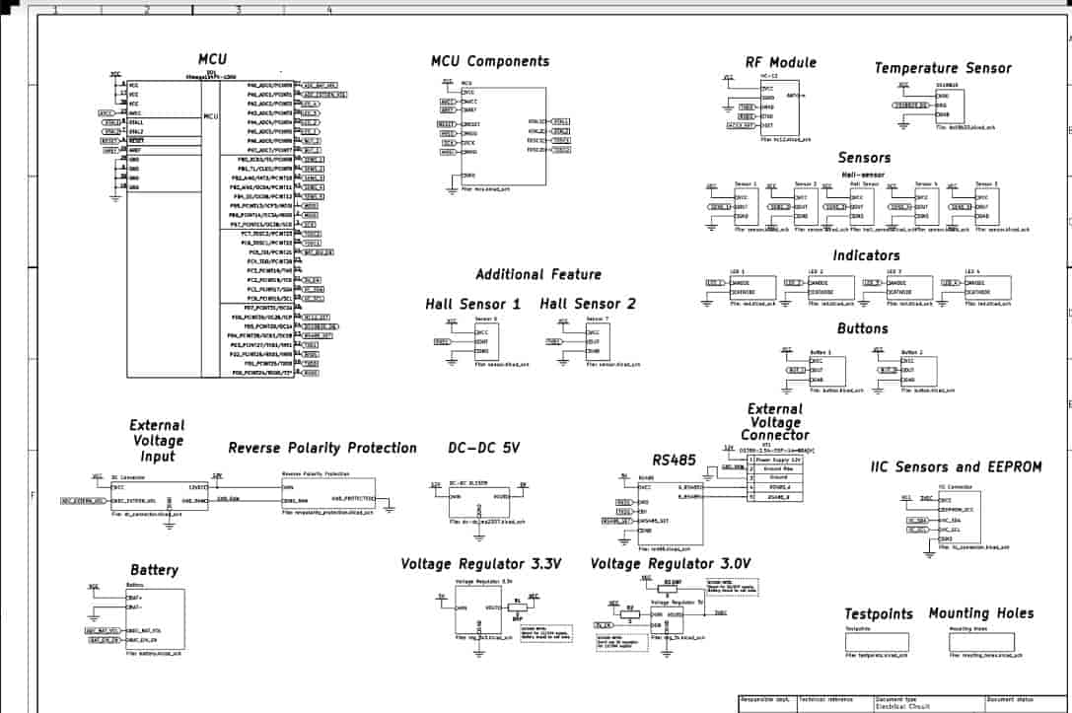
reports/20221006/3.jpg
