Egoruch/HC12/reports/20221006/4.jpg

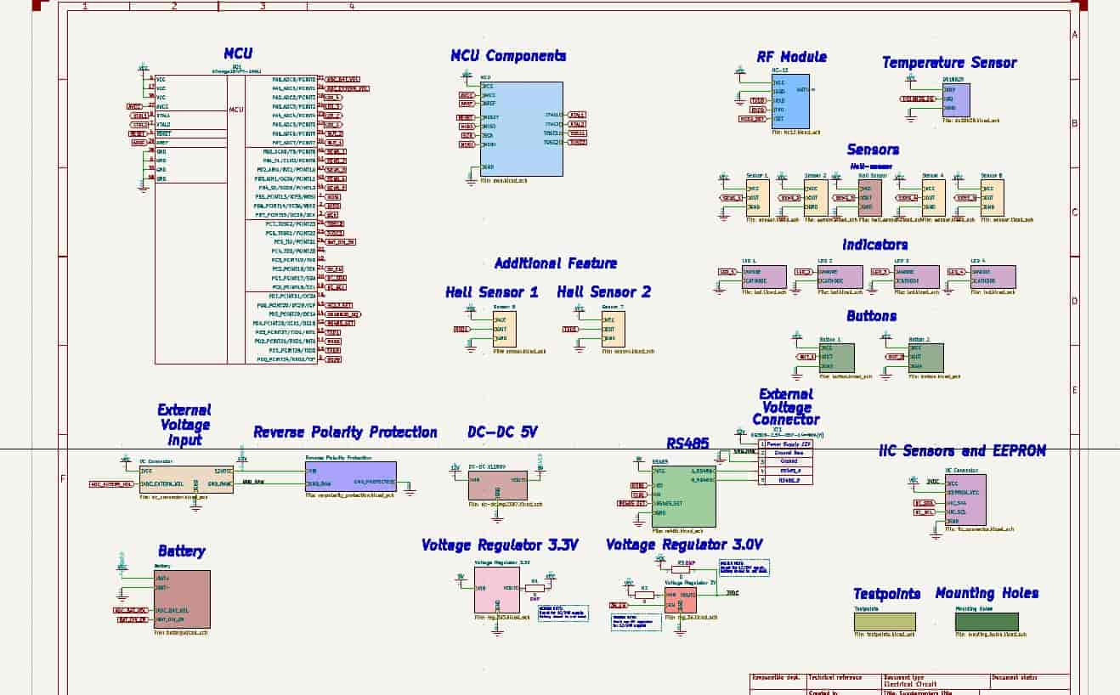
reports/20221006/4.jpg
