Egoruch/HC12/reports/20221909/1.jpg

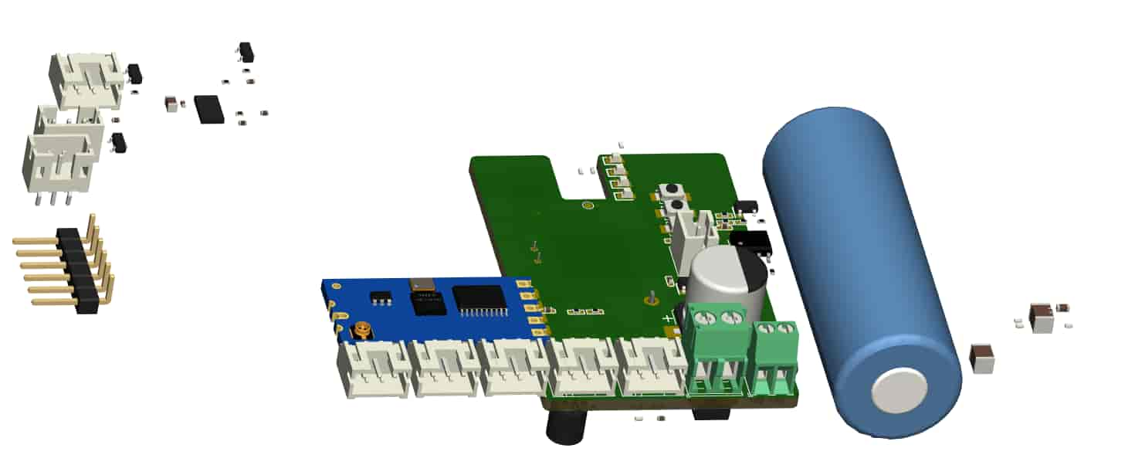
reports/20221909/1.jpg
