Egoruch/HC12/bom/RadioSens-MEC-ORDER-R01.xlsx

Project: | RadioSens v.1 | COMPANY NAME
Author:
Date: | 2022-06-10
Item | Qty | Reference(s) | Value | Footprint/Package | Tolerance | Type | Comment | Cost, UAH | Total cost, UAH | Buy | Link
 | 6 |  | Гвинт нержавіючий М2х6мм напівкруглий. PH нерж. 304 |  |  |  |  | 0.353 | 2.118 | TRUE | https://voron.ua/uk/catalog/014394
 | 1 |  | XL1509-5.0E1 |  |  |  |  | 18 | 18 | TRUE | http://www.kosmodrom.com.ua/el.php?name=XL1509-5.0E1
 | 1 |  | Корпус Z-96JH-ABS |  |  |  |  | 98 | 98 | TRUE | https://www.rcscomponents.kiev.ua/product/z-96jh-abs-korpus-plastikovij-germetichnij-36-5h70h50_111536.html
 | 1 |  | DRV5032FBDBZT |  |  |  |  | 36.5 |  | TRUE | http://www.kosmodrom.com.ua/el.php?name=DRV5032FBDBZT
 | 1 |  | LC60-1.00/F 16 грамм Проволочный припой Sn-60% Pb-40% 1,00мм Cynel |  |  |  | Soldering | 55 | 55 | TRUE | https://www.rcscomponents.kiev.ua/product/lc60-1-00-f-16-gram-drotyanij-pripij-sn-60-pb-40-1-00mm-cynel_99859.html
 | 1 |  | Паяльная паста AIM (12гр) |  |  |  | Soldering | 77 | 77 | TRUE | https://www.rcscomponents.kiev.ua/product/payalna-pasta-aim-12gr_111191.html
 | 1 |  | Змив флюсу для друкованих плат [250 мл] |  |  |  | Soldering | 76.07 | 76.07 | TRUE | https://voron.ua/uk/catalog/030910--smyvka_flyusa_dlya_pechatnyh_plat_250_ml
 | 1 |  | Дріт монтажний супергнучкий 22awg (60/0,08) силіконовий червоний |  |  |  | Battery Connection | 10.75 | 10.75 | TRUE | https://voron.ua/uk/catalog/031467--provod_montazhnyy_super_gibkiy_22awg_60008_silikonovyy_krasnyy
 | 1 |  | Дріт монтажний супергнучкий 22awg (60/0,08) силіконовий чорний |  |  |  | Battery Connection | 10.75 | 10.75 | TRUE | https://voron.ua/uk/catalog/031465--provod_montazhnyy_super_gibkiy_22awg_60008_silikonovyy_chernyy
 |  |  |  |  |  |  |  |  | 0 | FALSE
 |  |  |  |  |  |  |  |  | 0 | FALSE
 |  |  |  |  |  |  |  |  | 0 | FALSE
 |  |  |  |  |  |  |  | SUM: | 347.688
