Egoruch/HC12/orders/Order Documents/Etal/IMG_20221128_214735.jpg

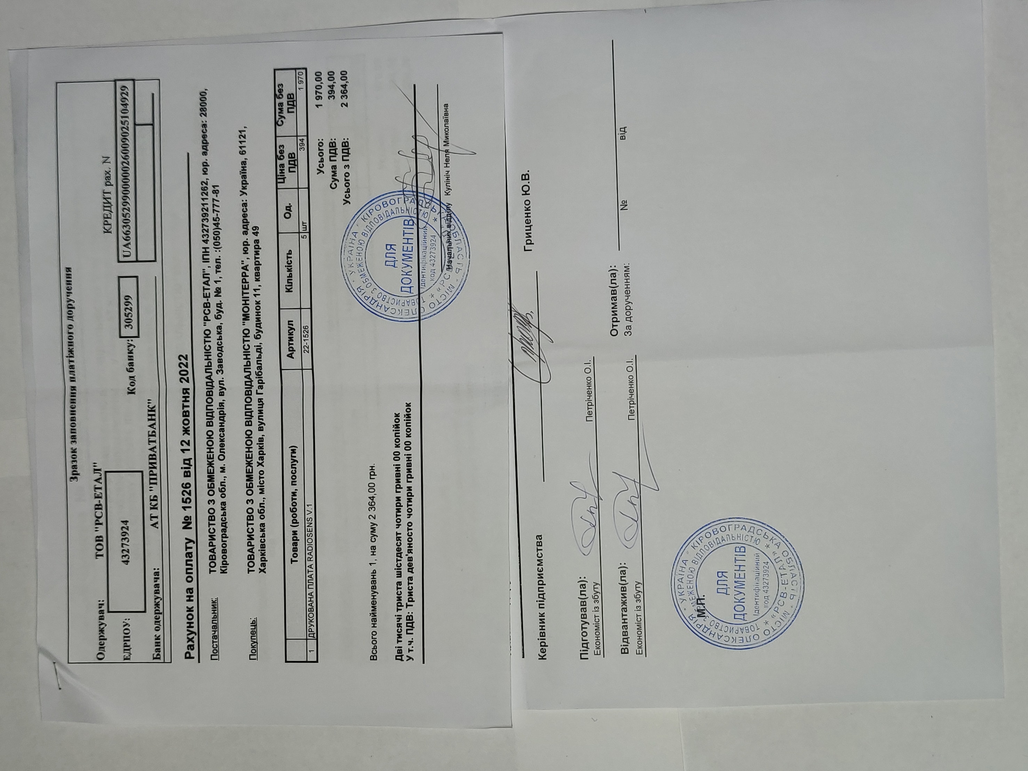
orders/Order Documents/Etal/IMG_20221128_214735.jpg
