Egoruch/HC12/orders/Order Documents/Etal/IMG_20221128_214744.jpg

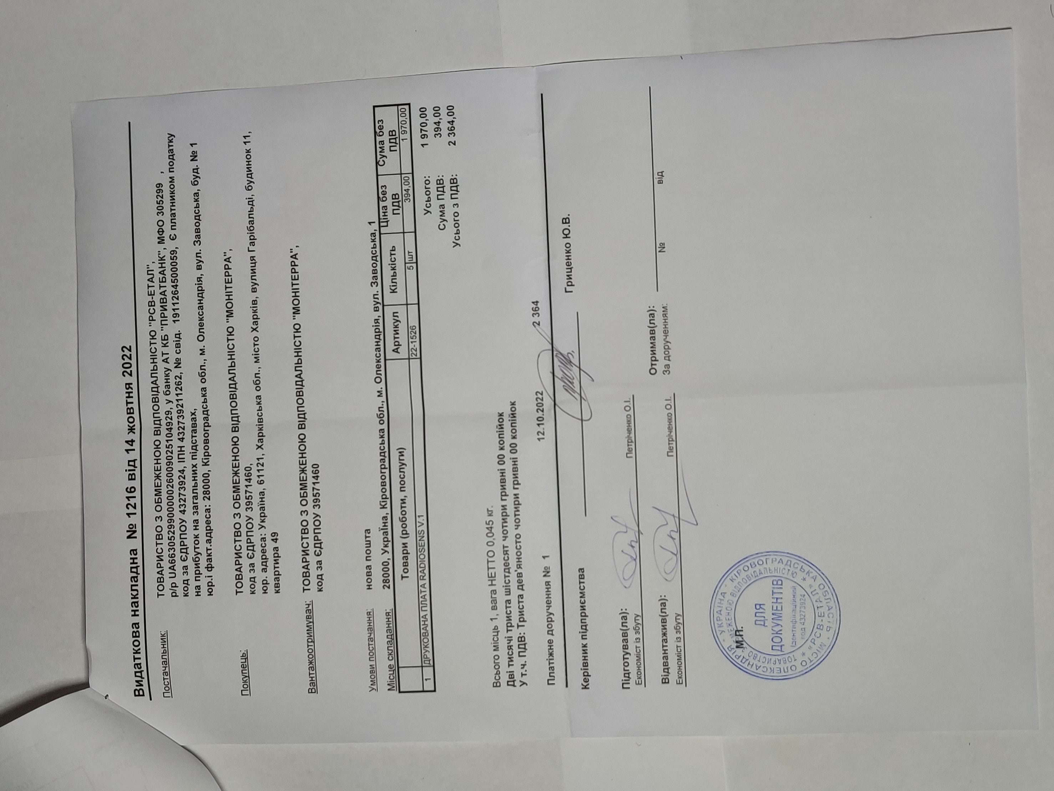
orders/Order Documents/Etal/IMG_20221128_214744.jpg
