Egoruch/HC12/orders/Order Documents/Imrad/IMG_20221128_214718.jpg

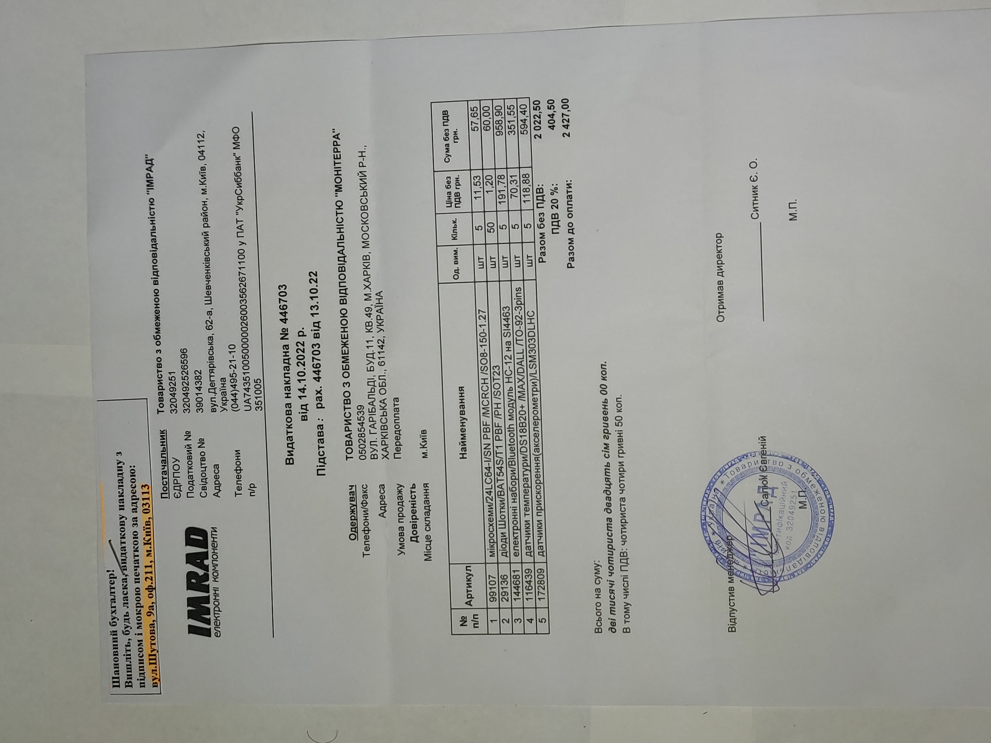
orders/Order Documents/Imrad/IMG_20221128_214718.jpg
