Egoruch/HC12/orders/Order Documents/Kosmodrom/IMG_20221128_214635.jpg

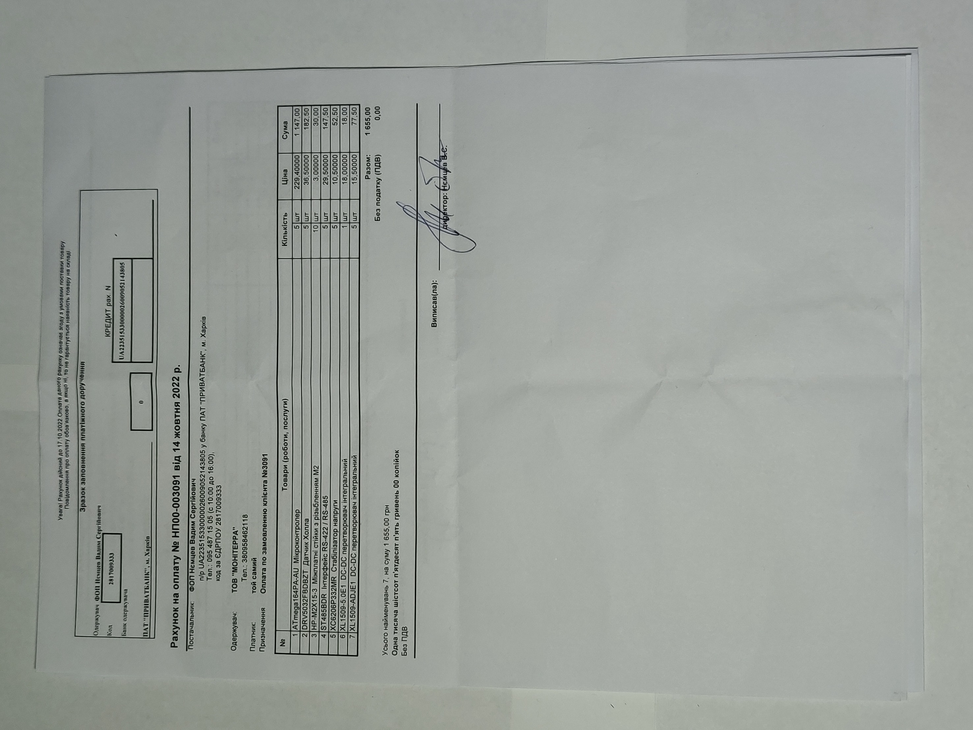
orders/Order Documents/Kosmodrom/IMG_20221128_214635.jpg
