Egoruch/HC12/orders/Order Documents/Kosmodrom/IMG_20221128_214655.jpg

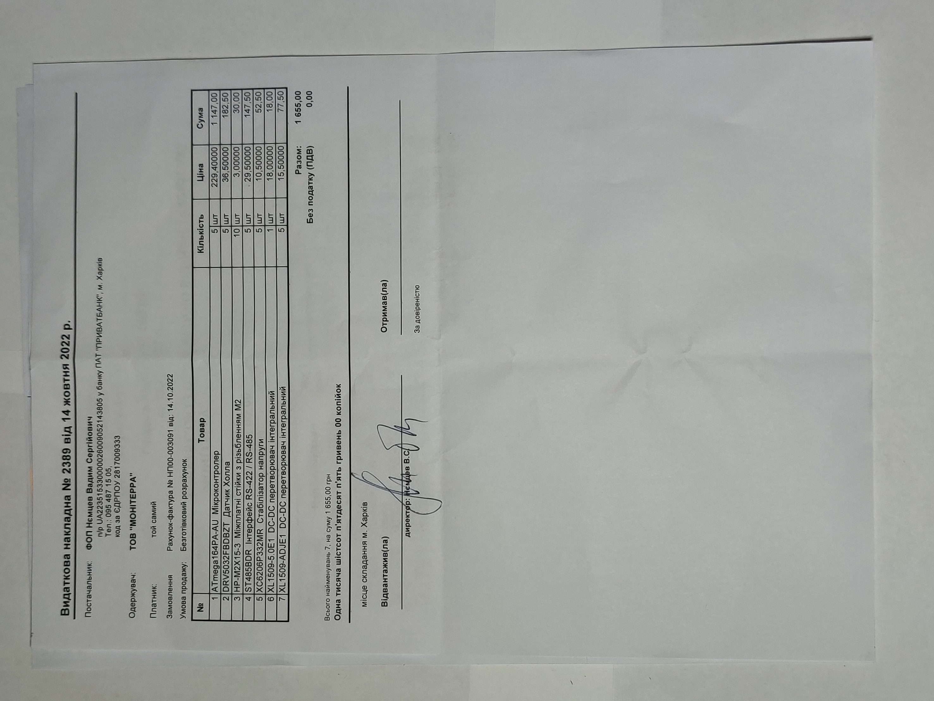
orders/Order Documents/Kosmodrom/IMG_20221128_214655.jpg
