Egoruch/HC12/orders/Order Documents/RCSComponents/IMG_20221128_214514.jpg

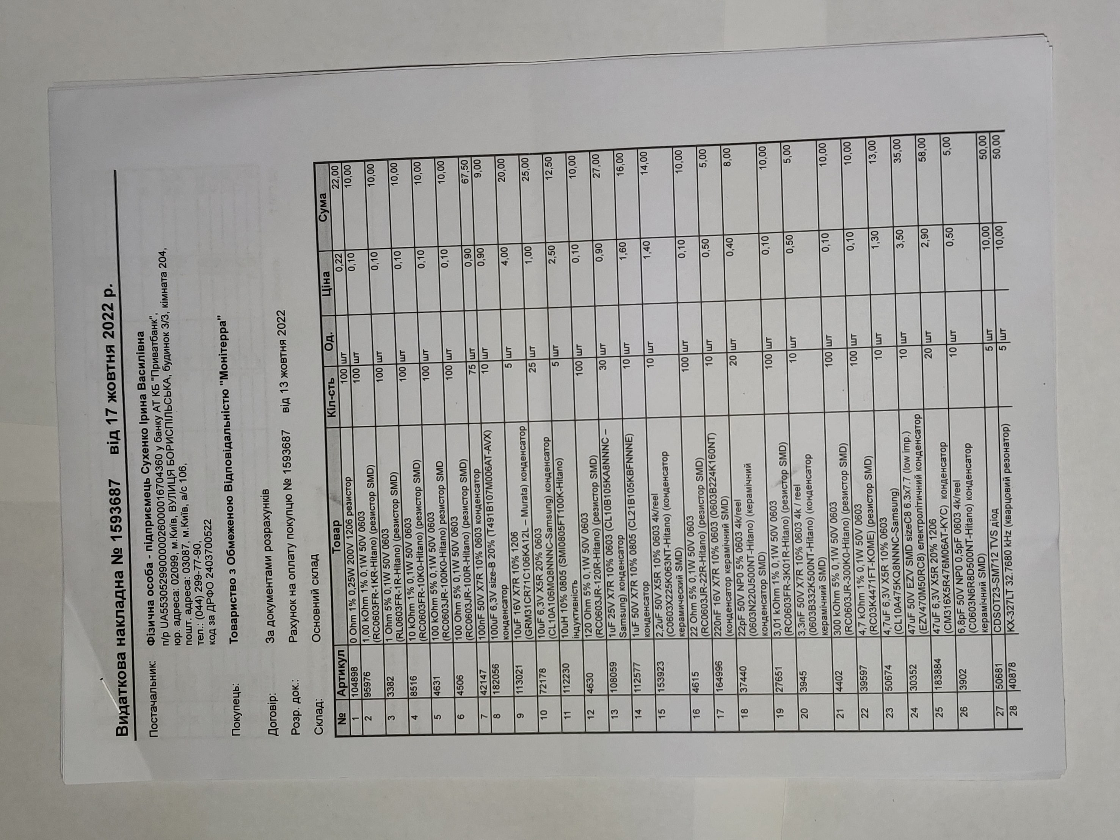
orders/Order Documents/RCSComponents/IMG_20221128_214514.jpg
