Egoruch/HC12/orders/Order Documents/RCSComponents/IMG_20221128_214537.jpg

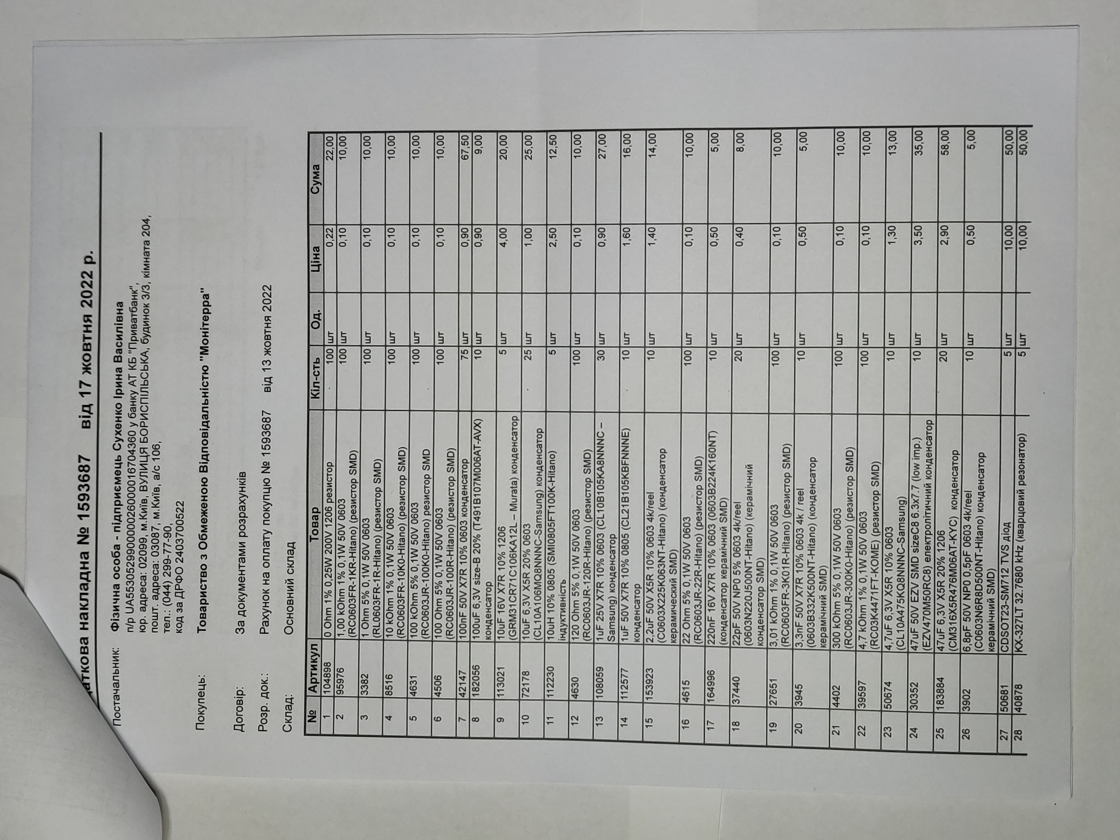
orders/Order Documents/RCSComponents/IMG_20221128_214537.jpg
