Egoruch/HC12/orders/Order Documents/RCSComponents/IMG_20221128_214558.jpg

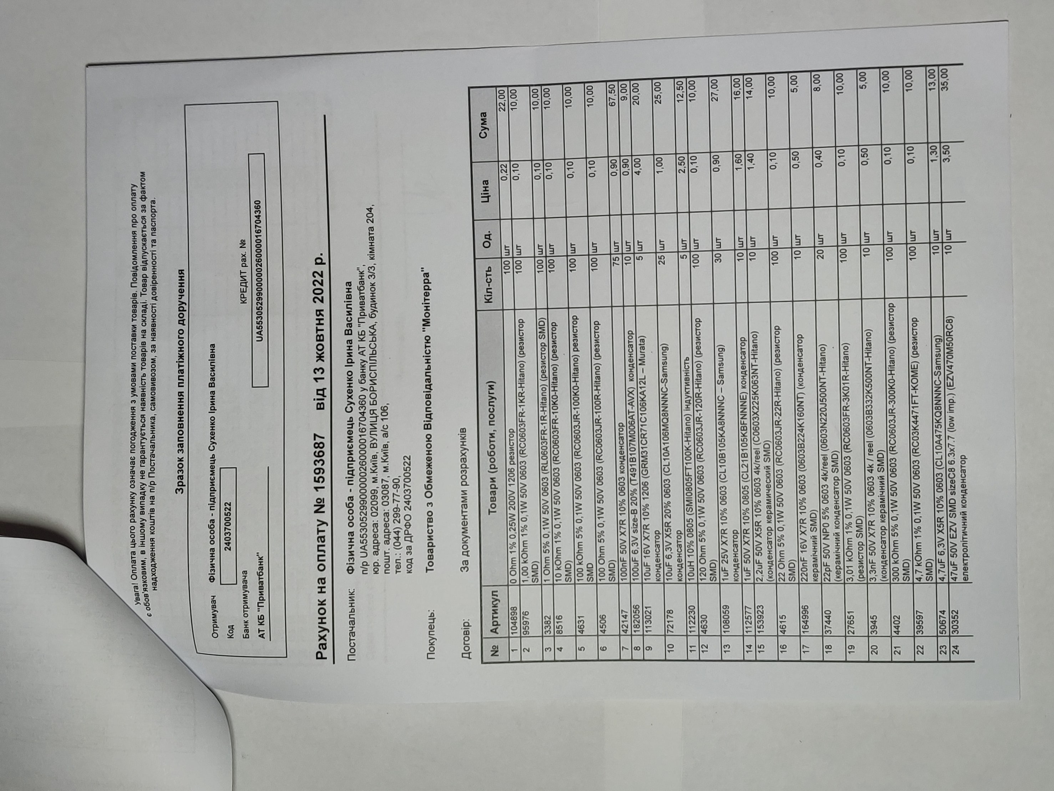
orders/Order Documents/RCSComponents/IMG_20221128_214558.jpg
