Egoruch/HC12/orders/Order Documents/Voron 2/IMG_20221128_214900.jpg

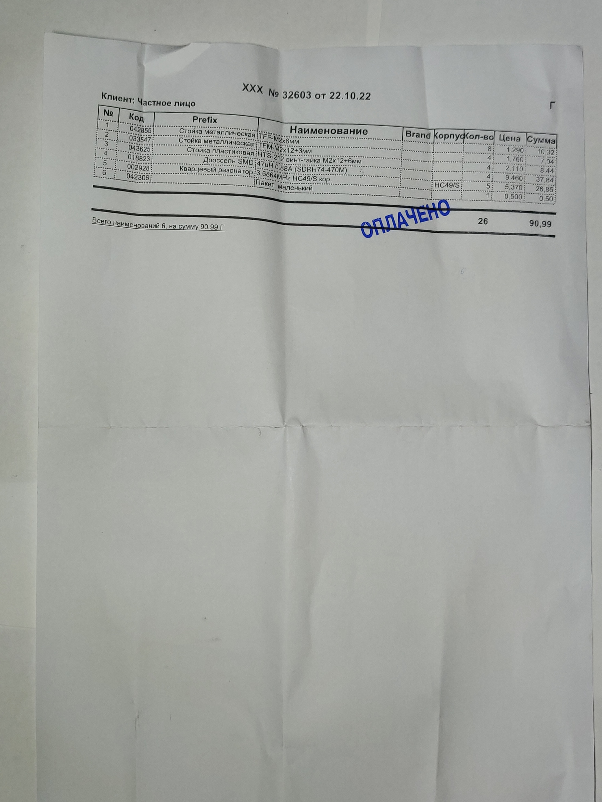
orders/Order Documents/Voron 2/IMG_20221128_214900.jpg
