Egoruch/HC12/orders/Order Documents/Voron/IMG_20221128_214434.jpg

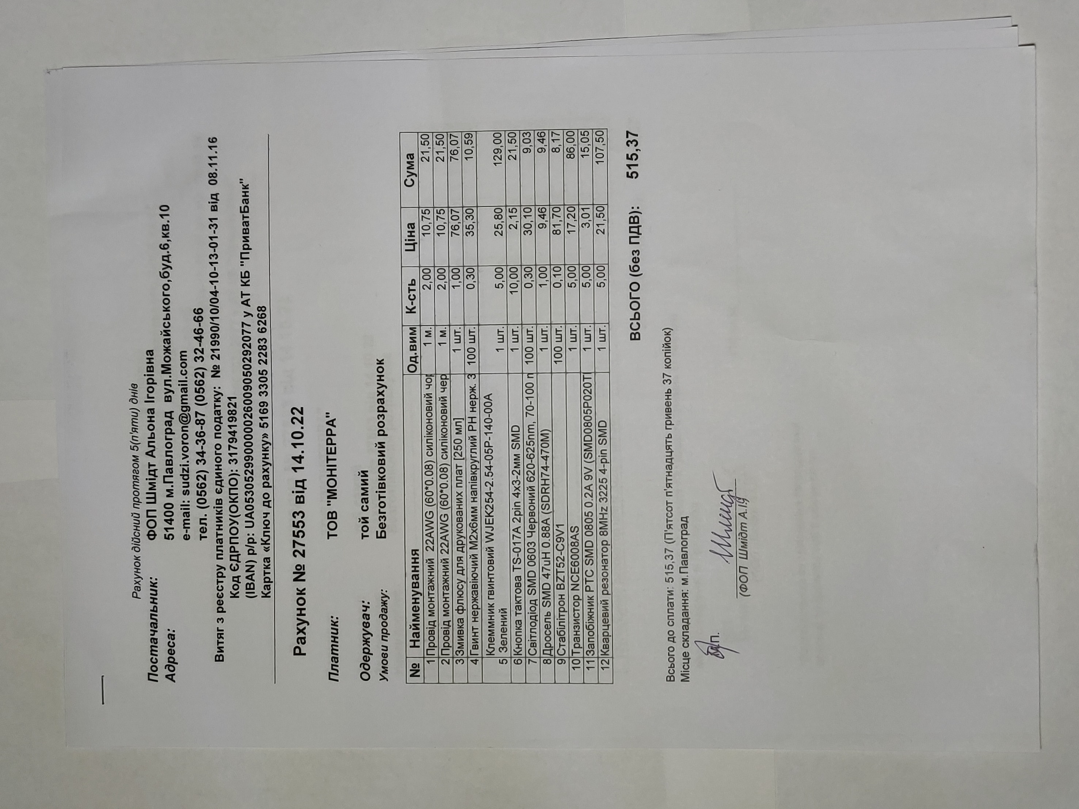
orders/Order Documents/Voron/IMG_20221128_214434.jpg
