Egoruch/HC12/mechanical/Enclosure Draft/Z96_2000_CUTOUT.dxf

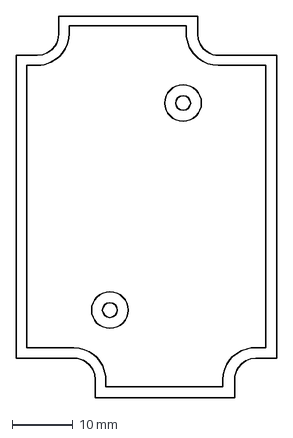
[picture p85: CAD file, 2022-10-04]
mechanical/Enclosure Draft/Z96_2000_CUTOUT.dxf
42.7 x 62.6 mm
