Egoruch/HC12/wiring diagram/ARC/RadioSens-Radiosens v1 Wiring Diagram 24V.pdf

Схема подключения для датчика RadioSens v1

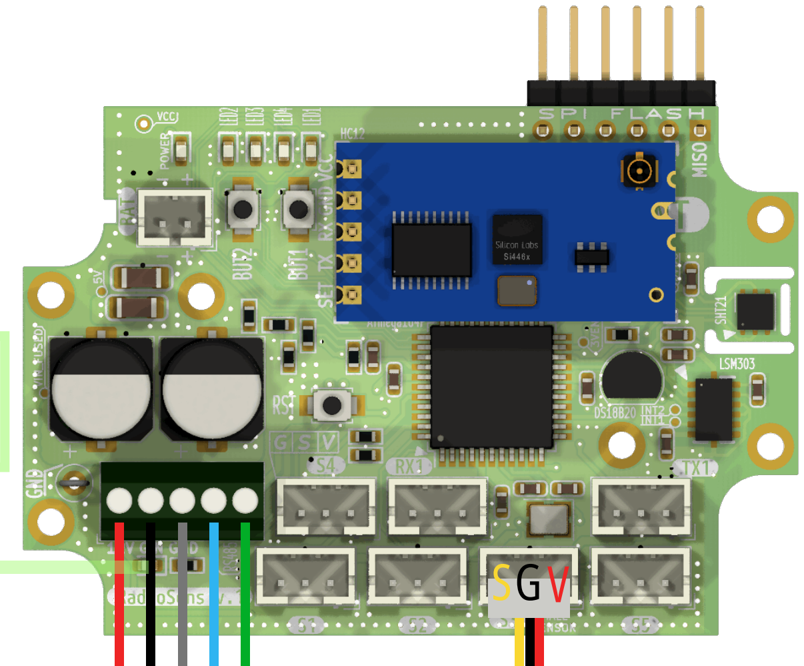
[picture p86: figure]
SGV

ДатчикХолла

B

A
G
GND

12V

Датчик
Уровня
Топлива

После подачи питания
светодиод будет светиться.
1. При закрытии корпуса антена должна быть защищена
изоляционной трубкой.
2. Используйте плоскую отвертку для вращения винтов клеммника.
3. Используйте гибкие провода 22AWG (D=0.78 мм, S = 0.48 мм² )
в силиконовой изоляции.
4. Замкнуть на плате G и GND при использовании одного
источника питания

Источник 12В/24В

+
