Egoruch/HC12/assembly/RadioSens-3D-BOT.jpg

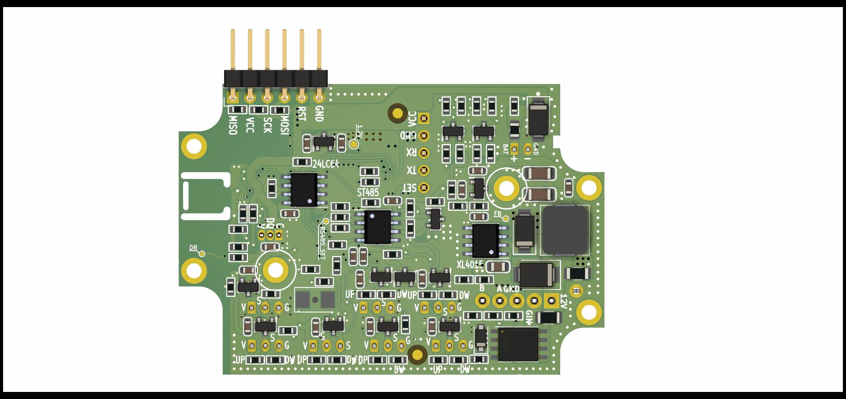
assembly/RadioSens-3D-BOT.jpg
