Egoruch/HC12/assembly/RadioSens-3D-TOP.jpg

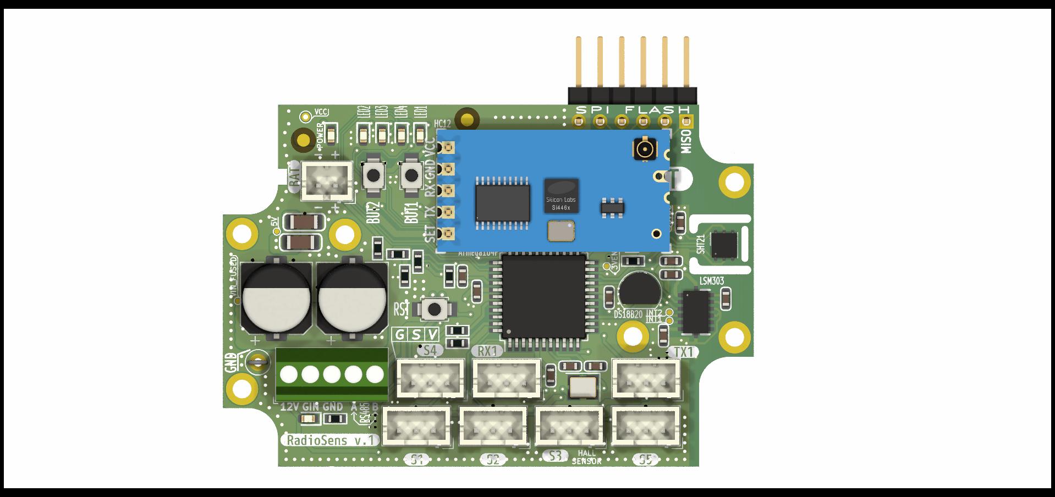
assembly/RadioSens-3D-TOP.jpg
