Egoruch/HC12/wiring diagram/ARC/RadioSens_Wiring_Diagram.png

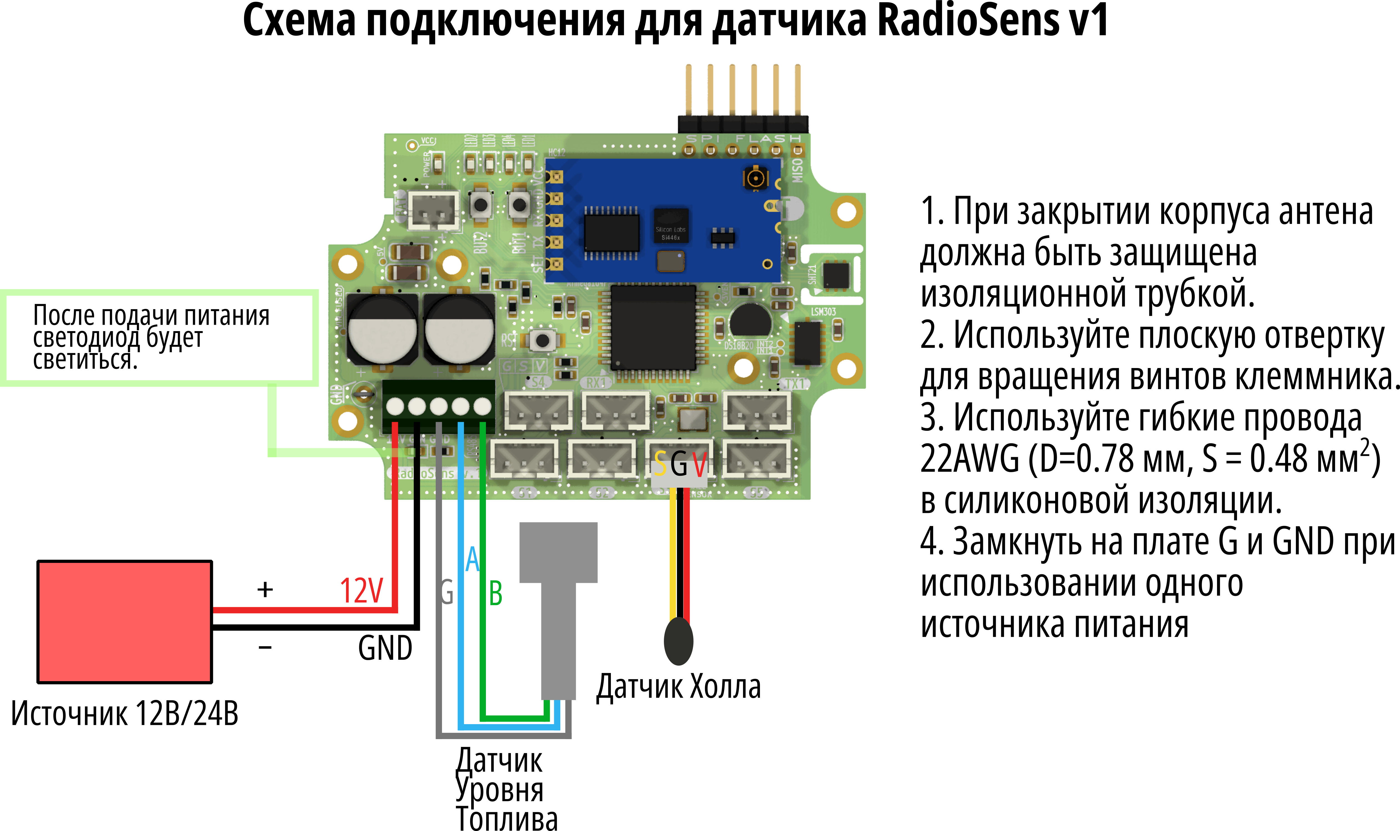
wiring diagram/ARC/RadioSens_Wiring_Diagram.png
