Egoruch/HC12/issues/RadioSens_v1_Issues.txt

Убрать надпись BQ3
Больше вырез для провода элемента питания
Изменить шелк транзистора POWERPAK-8 (обозначние первого вывода)
Уменьшить диаметр проверочного места минуса питания (для удобства вставки щупа)
Светодиод на SCK для индикации программирования?
Убрать подтяжку вниз для DS18B20
Больше точек проверки (для делителей)
