Egoruch/HC12/(threads)

Thread 1 (2022-10-04):

BOM is missing

Egoruch, 2022-10-04:
List of components (**BOM**) is missing. @Egoruch, please generate it.

Closed 2022-10-04.
