Egoruch/HC12/assembly/RadioSens-B_Fab.pdf

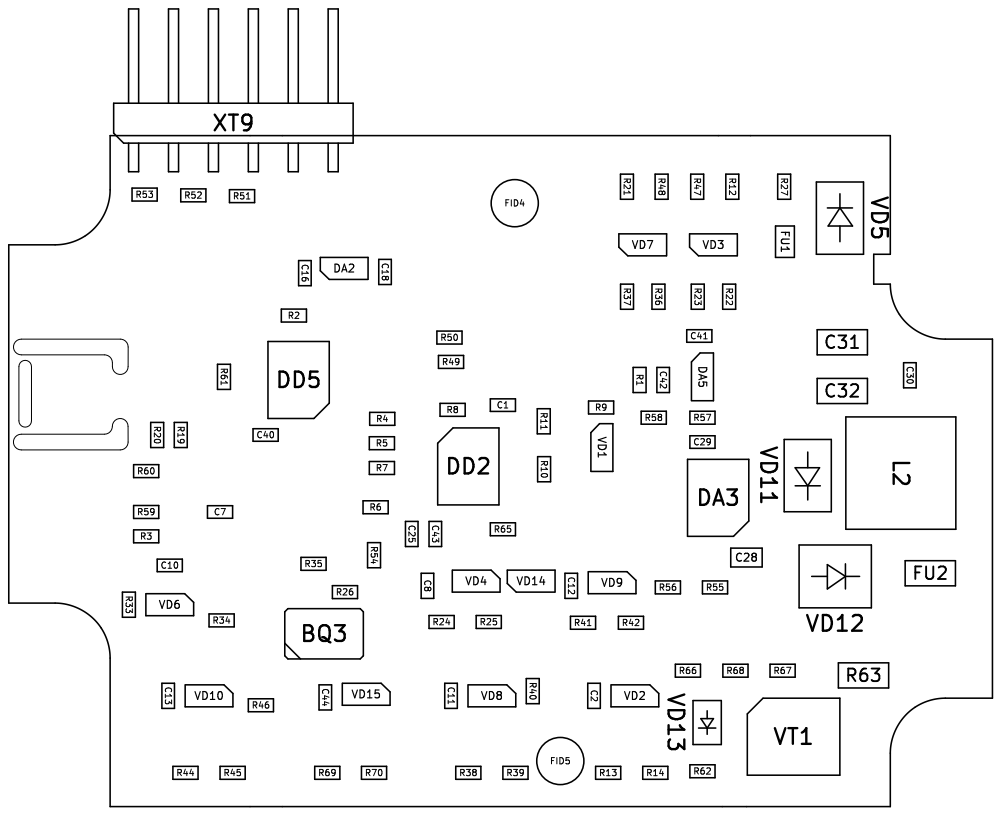
[picture p90: page 1]

Id: 1/1 Title: File: RadioSens.kicad_pcb Sheet:
