Egoruch/HC12/kicad/RadioSens.pdf

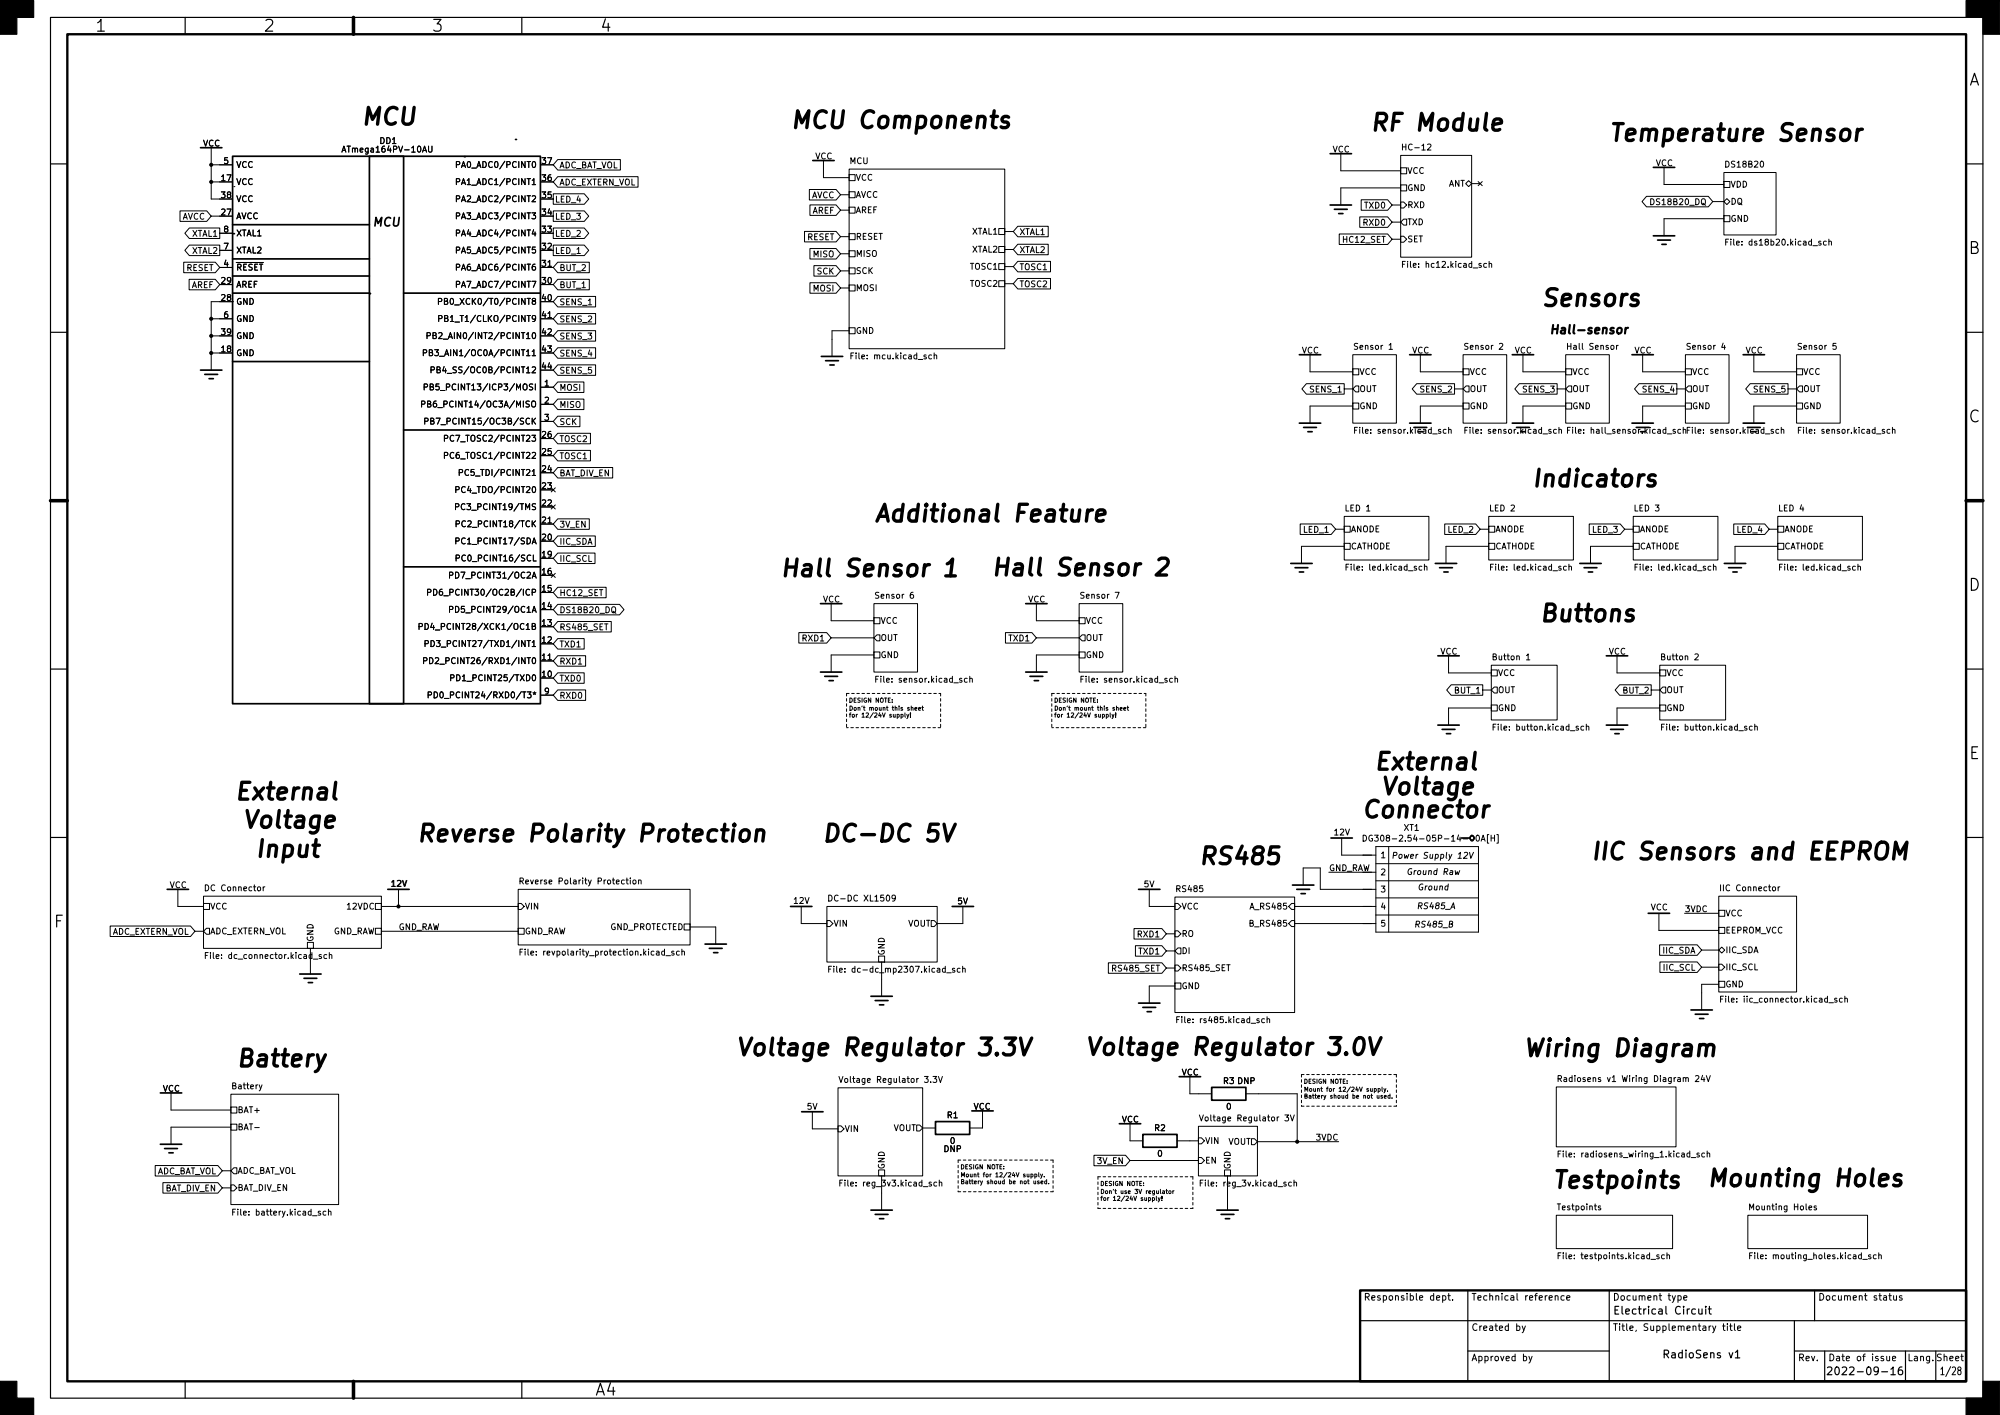
[picture p91: page 1]

for 12/24V supply! DESIGN NOTE: MCU Components

~{RESET} 4
AREF 29

Don't mount this sheet
for 12/24V supply!

IIC Sensors and EEPROM

1 | Power Supply 12V
2 | Ground Raw
3 | Ground

Mount for 12/24V supply.
Battery shoud be not used.

Title, Supplementary title RadioSens v1

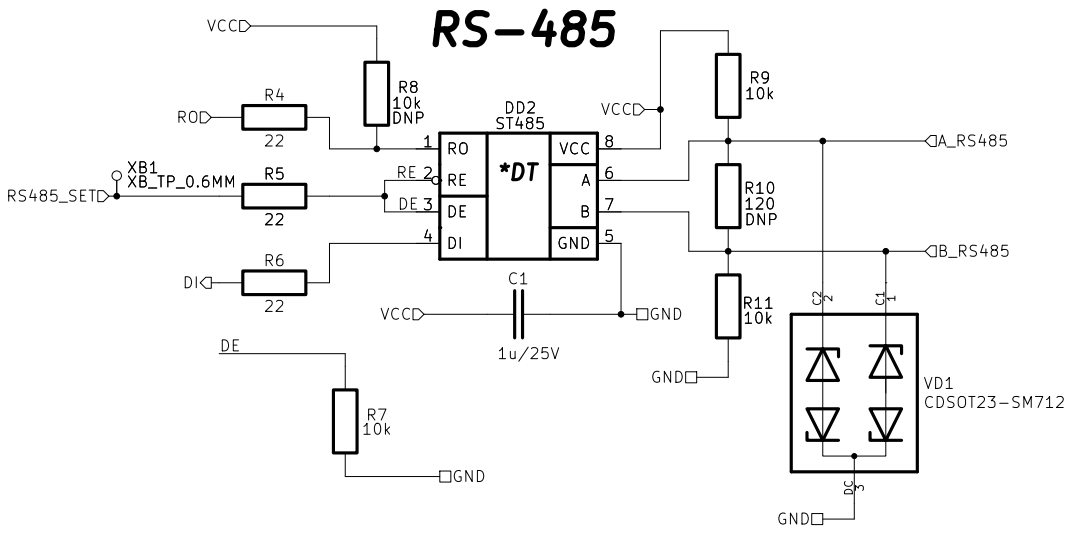
[picture p92: page 2]

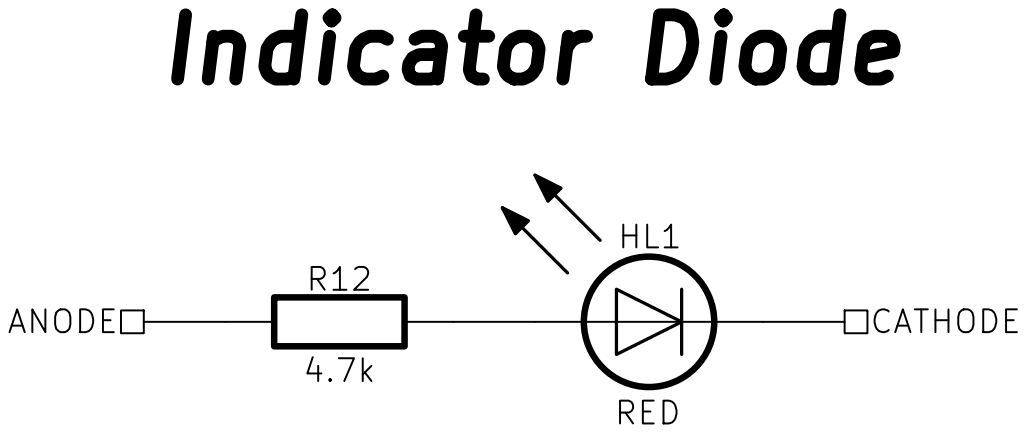
[picture p93: page 3]

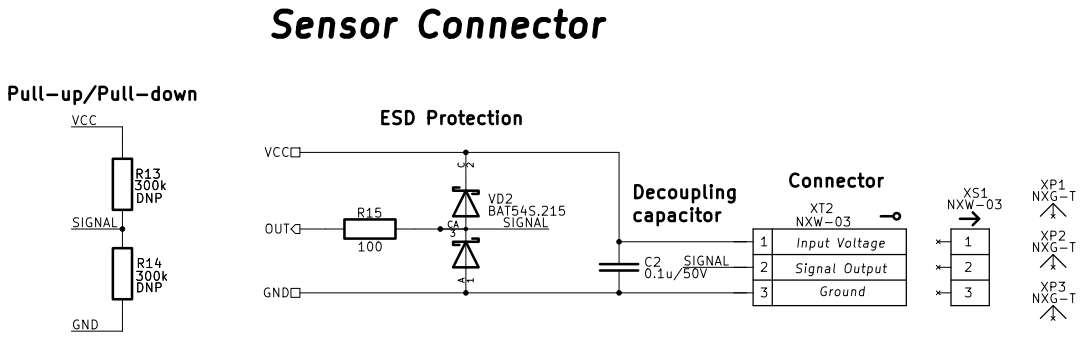
[picture p94: page 4]

Pull-up/Pull-down

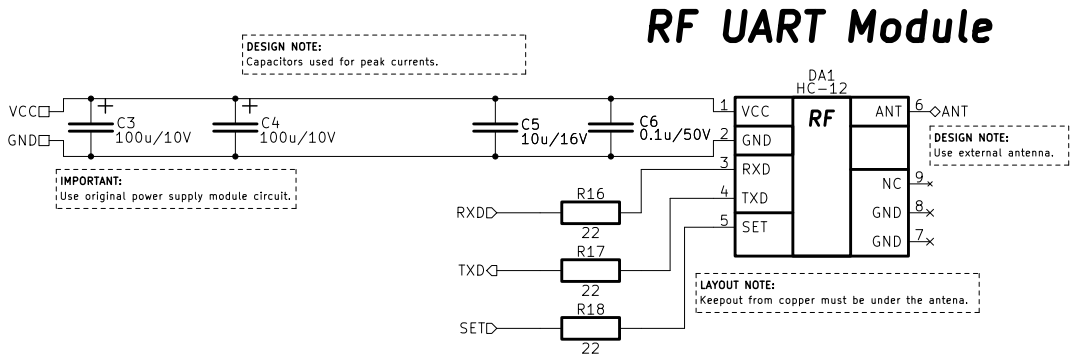
[picture p95: page 5]

Use original power supply module circuit.

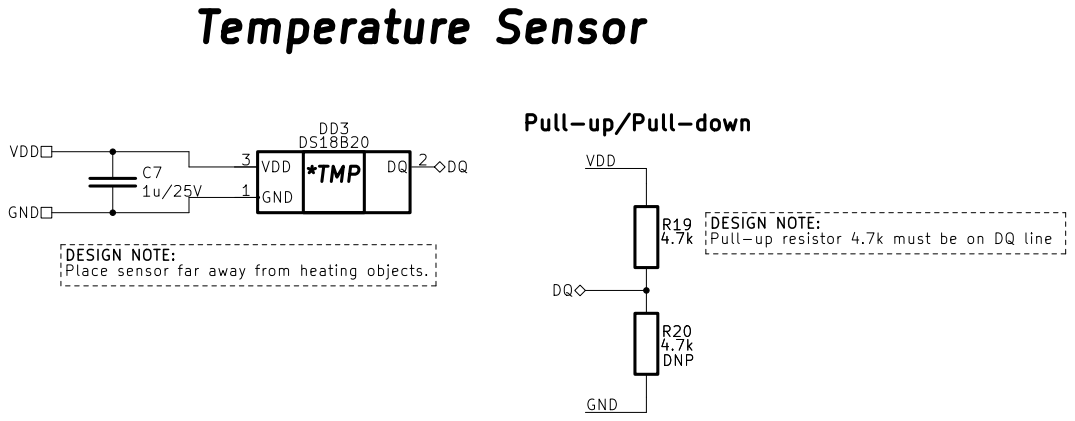
[picture p96: page 6]

Pull-up/Pull-down

*TMP | DQ | 2 VDD 3

Pull-up resistor 4.7k must be on DQ line

DESIGN NOTE:
Place sensor far away from heating objects.

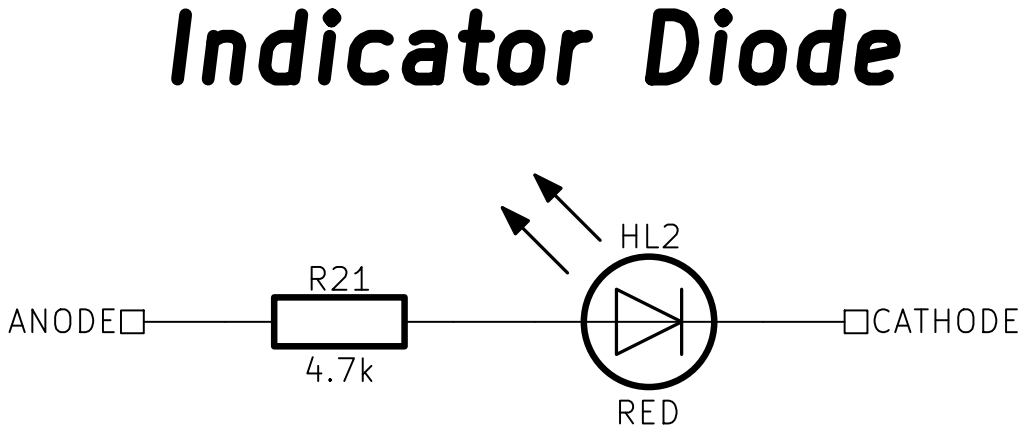
[picture p97: page 7]

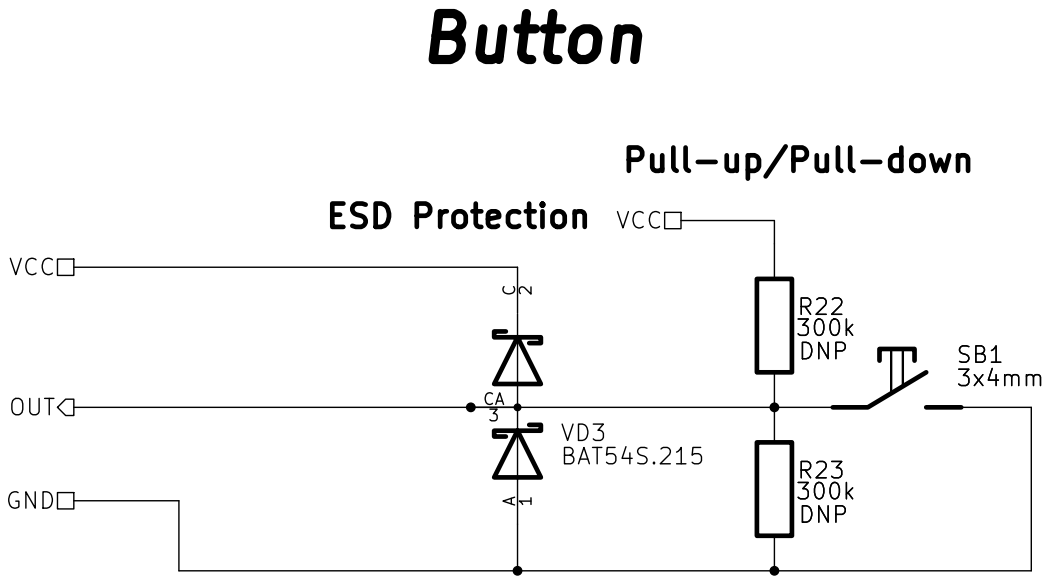
[picture p98: page 8]

Pull-up/Pull-down

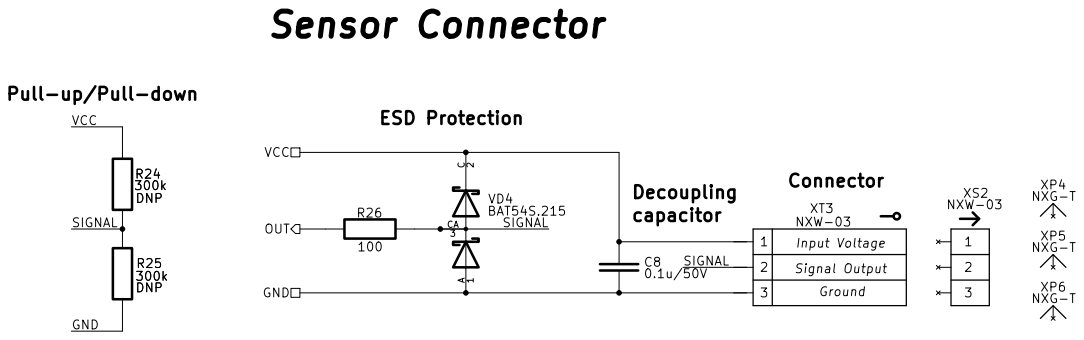
[picture p99: page 9]

Pull-up/Pull-down

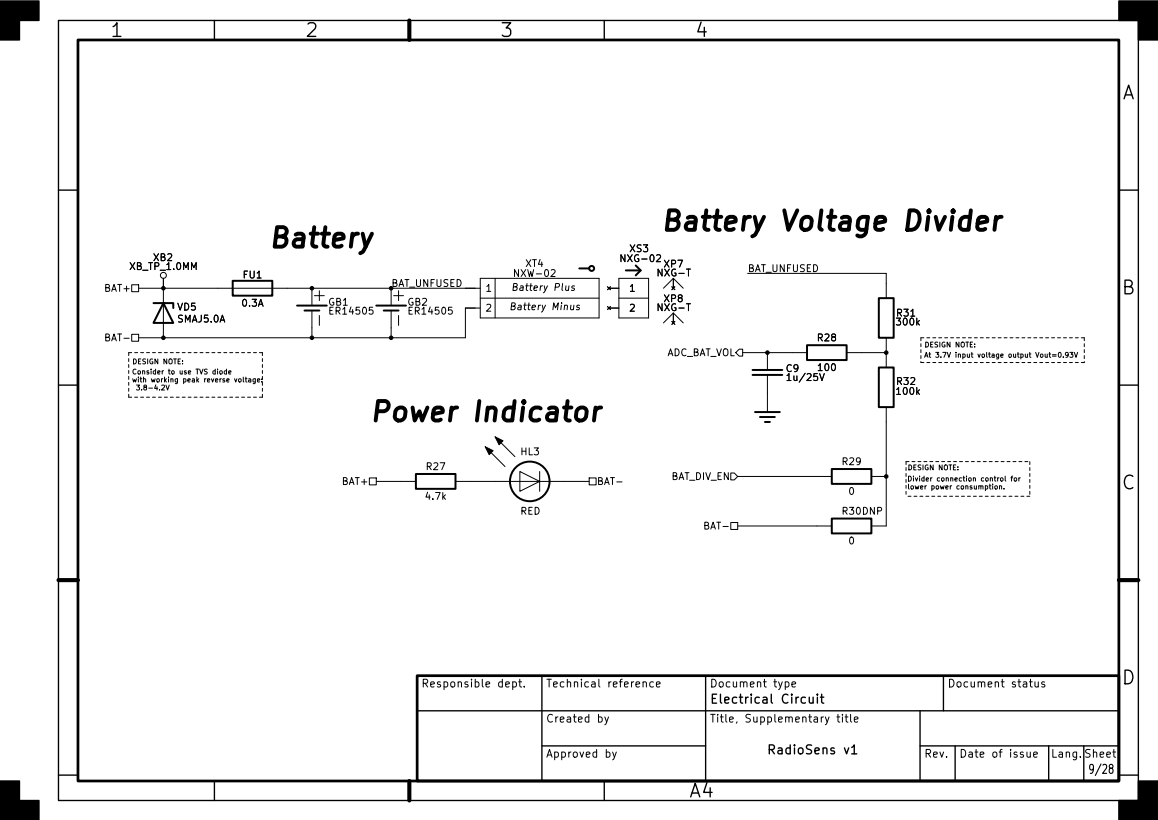
[picture p100: page 10]

lower power consumption. DESIGN NOTE: DESIGN NOTE: Battery Voltage Divider

Battery Minus Consider to use TVS diode with working peak reverse voltage:

Divider connection control for

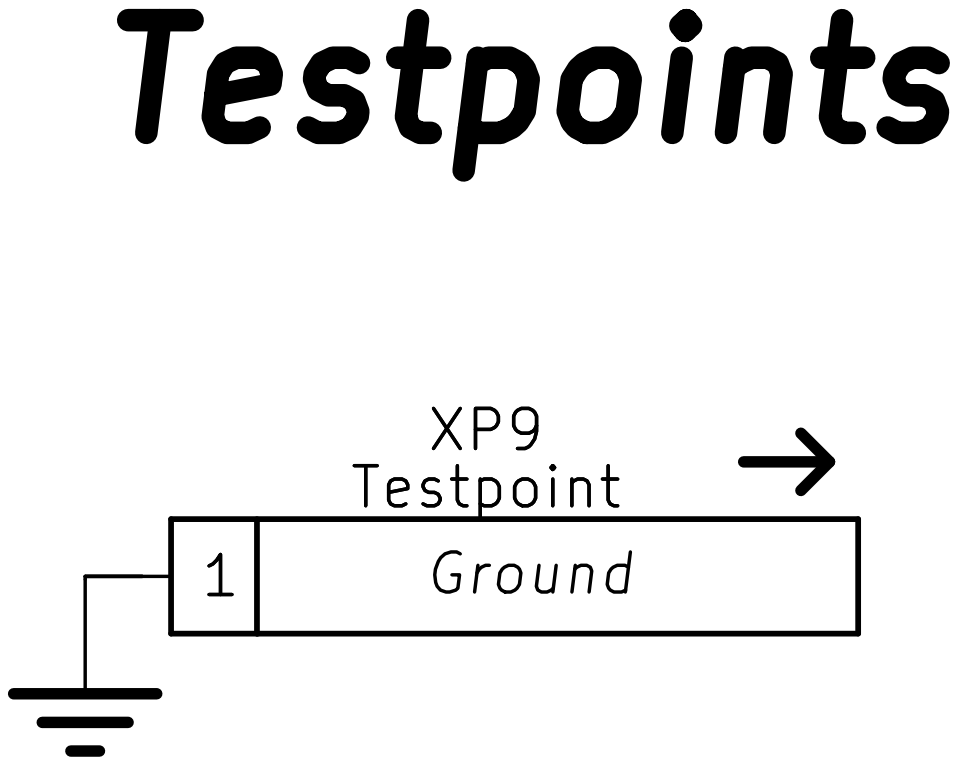
[picture p101: page 11]

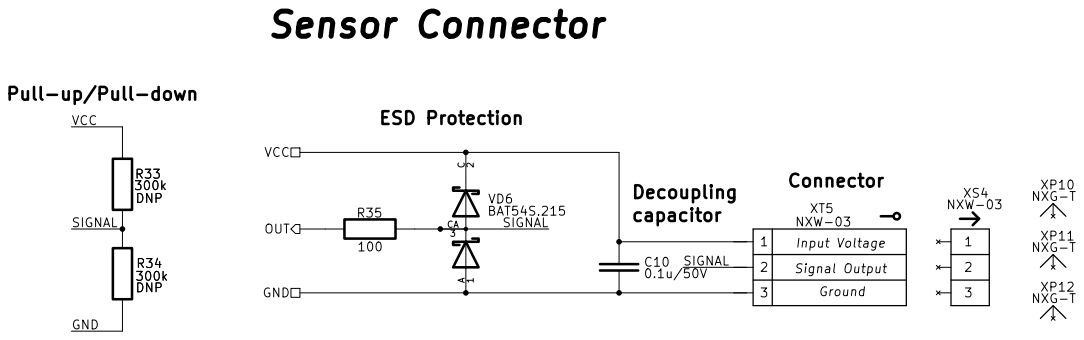
[picture p102: page 12]

Pull-up/Pull-down

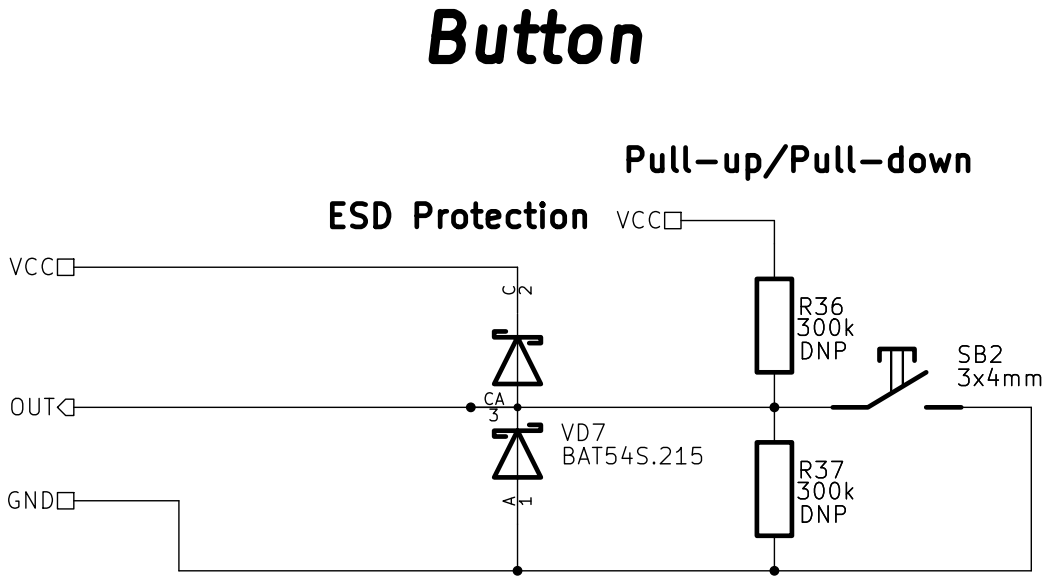
[picture p103: page 13]

Pull-up/Pull-down

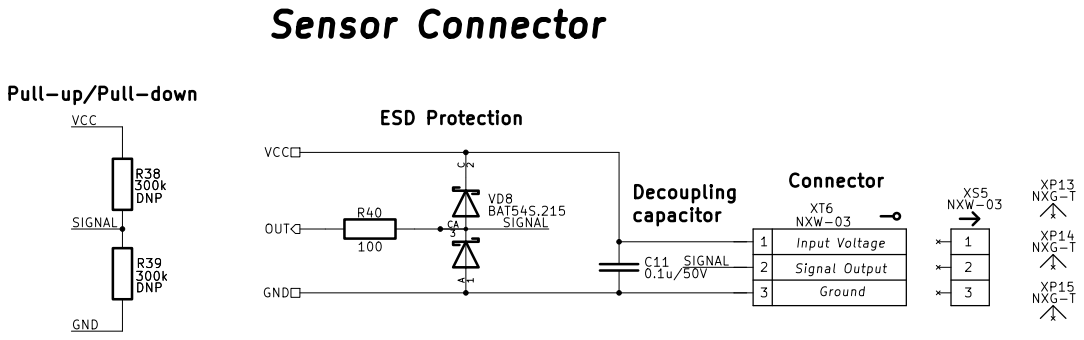
[picture p104: page 14]

Pull-up/Pull-down

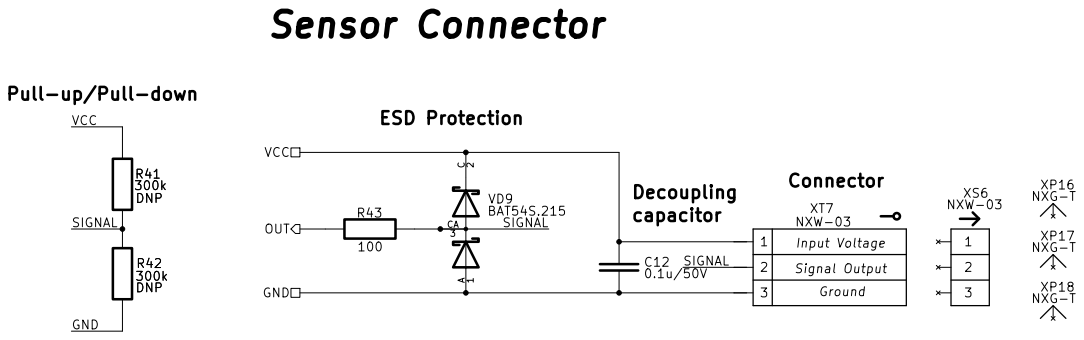
[picture p105: page 15]

Pull-up/Pull-down

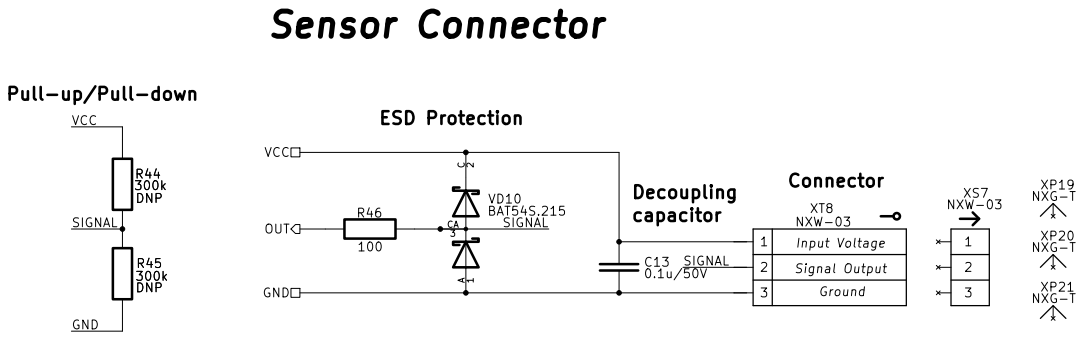
[picture p106: page 16]

Pull-up/Pull-down

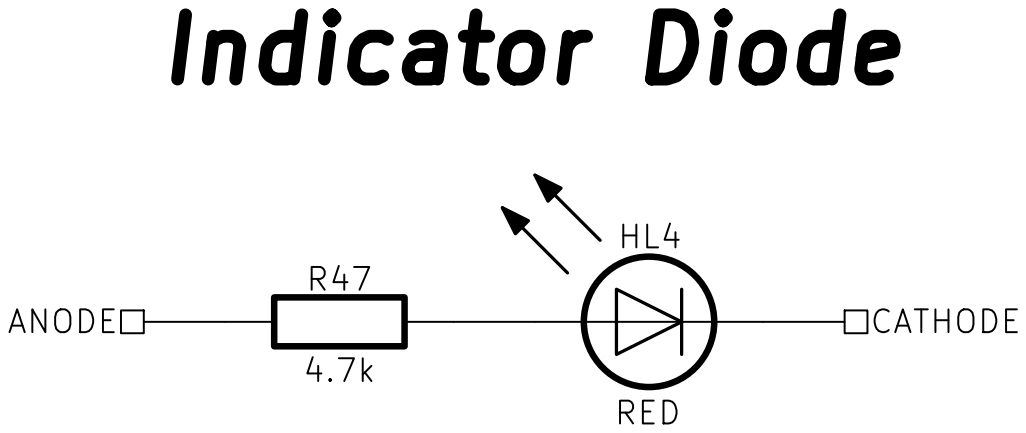
[picture p107: page 17]

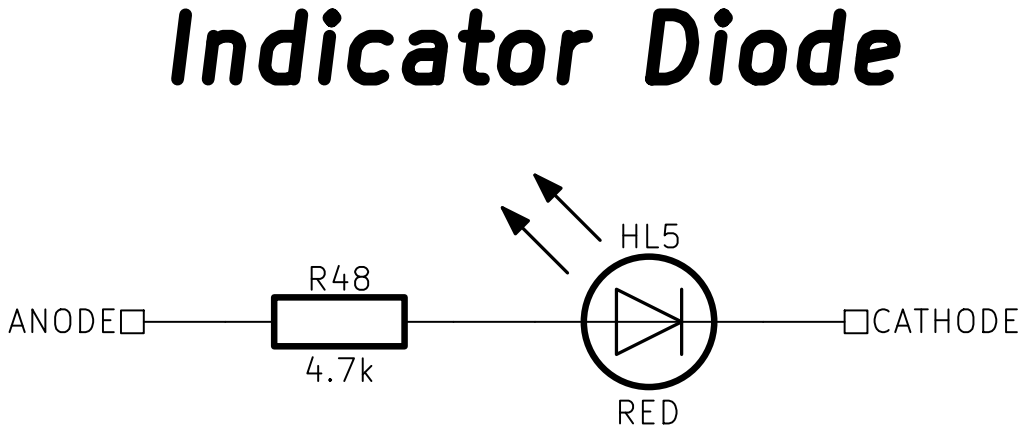
[picture p108: page 18]

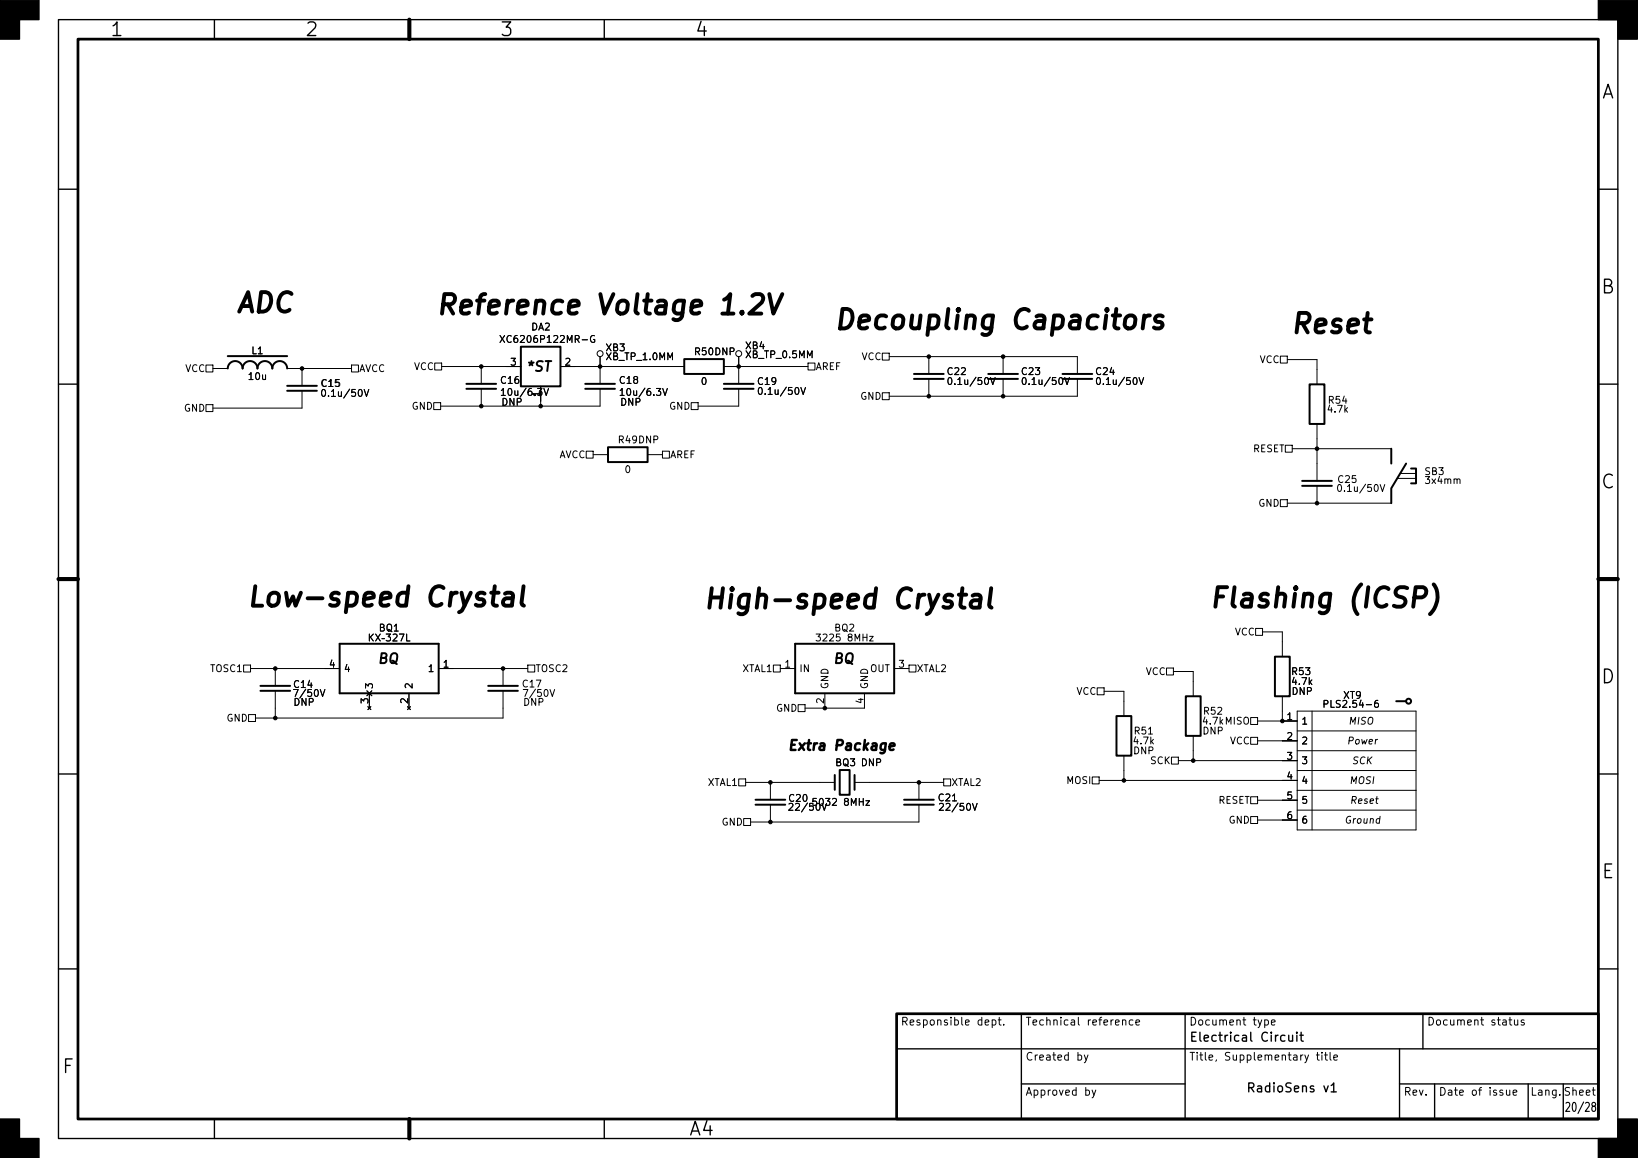
[picture p109: page 19]

1 1 | MISO
2 2 | Power
3 3 | SCK
4 4 | MOSI
5 5 | Reset
6 6 | Ground

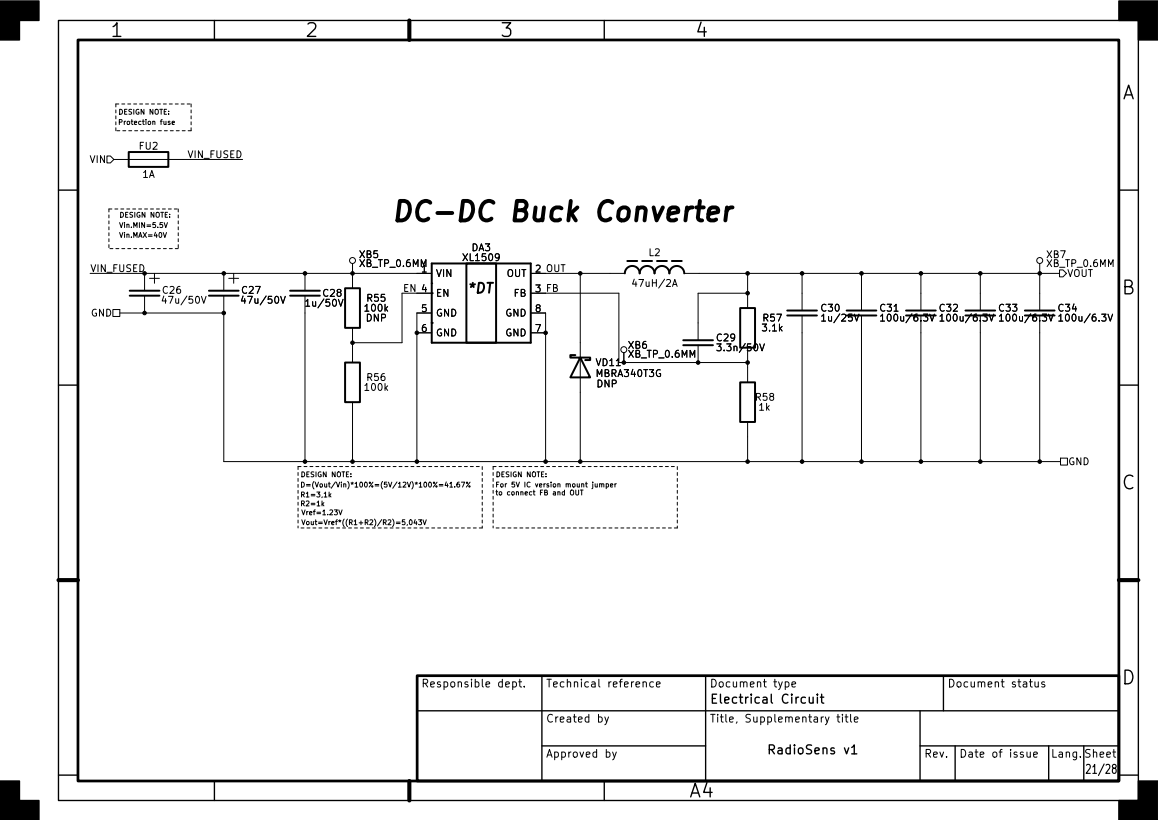
[picture p110: page 20]

DC-DC Buck Converter

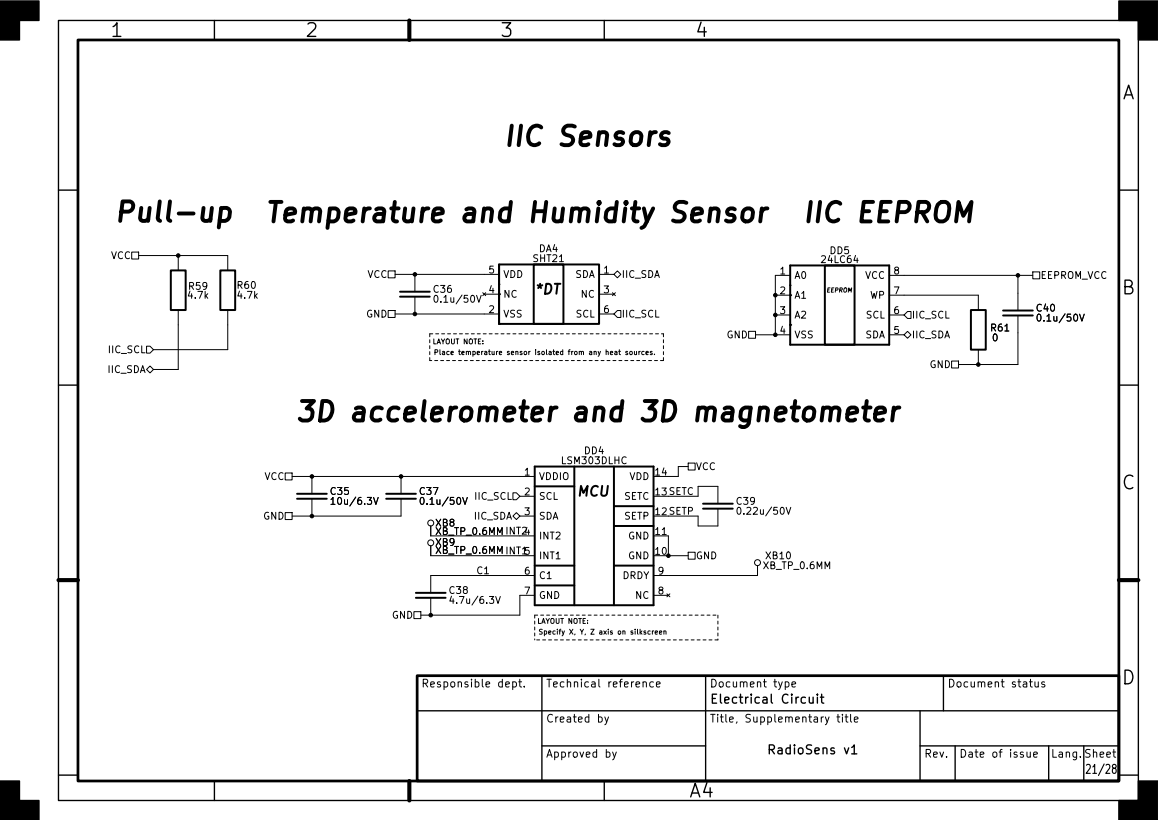
[picture p111: page 21]

Temperature and Humidity Sensor

Place temperature sensor isolated from any heat sources.

Specify X, Y, Z axis on silkscreen

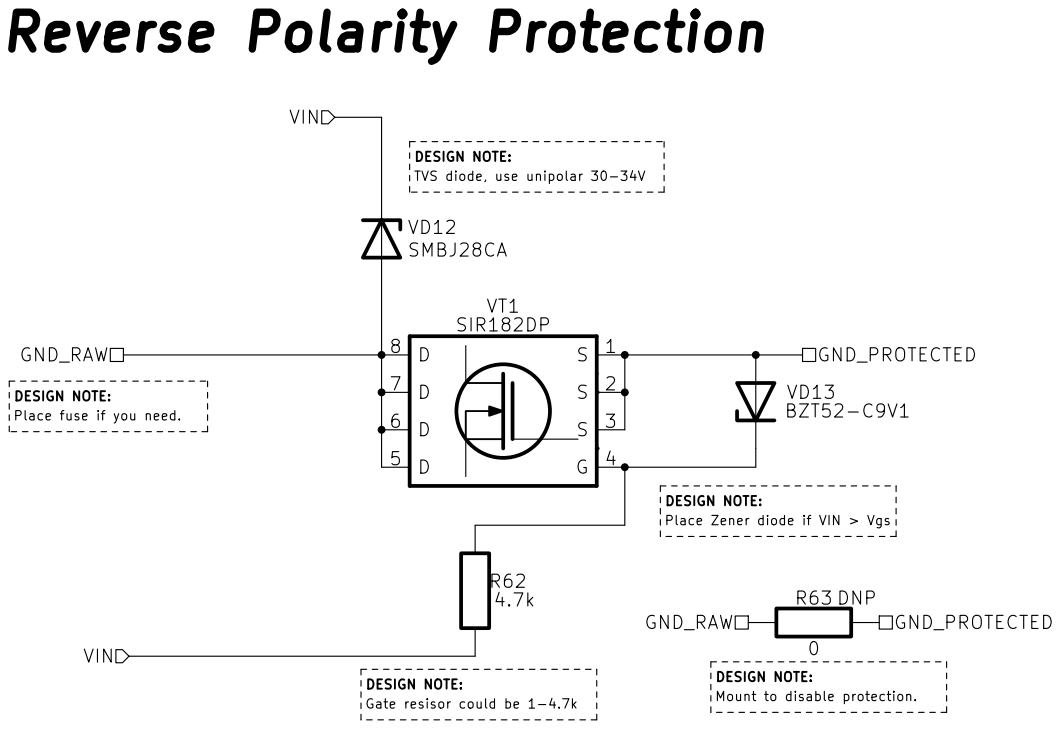
[picture p112: page 22]

DESIGN NOTE: Mount to disable protection. DESIGN NOTE: Gate resisor could be 1-4.7k DESIGN NOTE: TVS diode, use unipolar 30-34V DESIGN NOTE: Reverse Polarity Protection

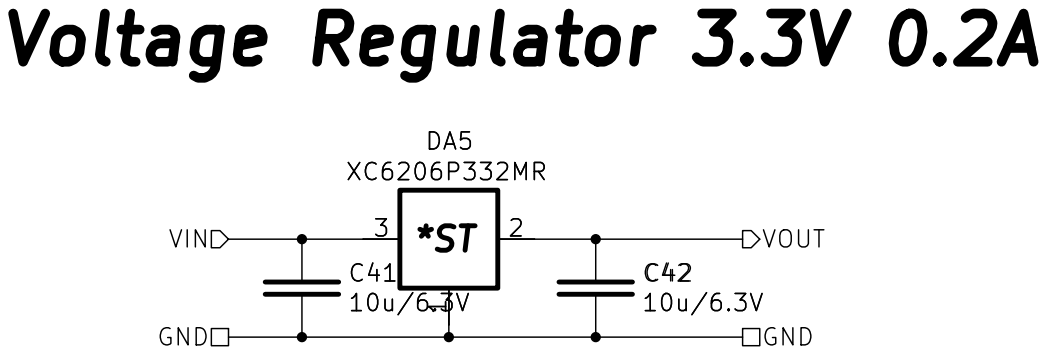
[picture p113: page 23]

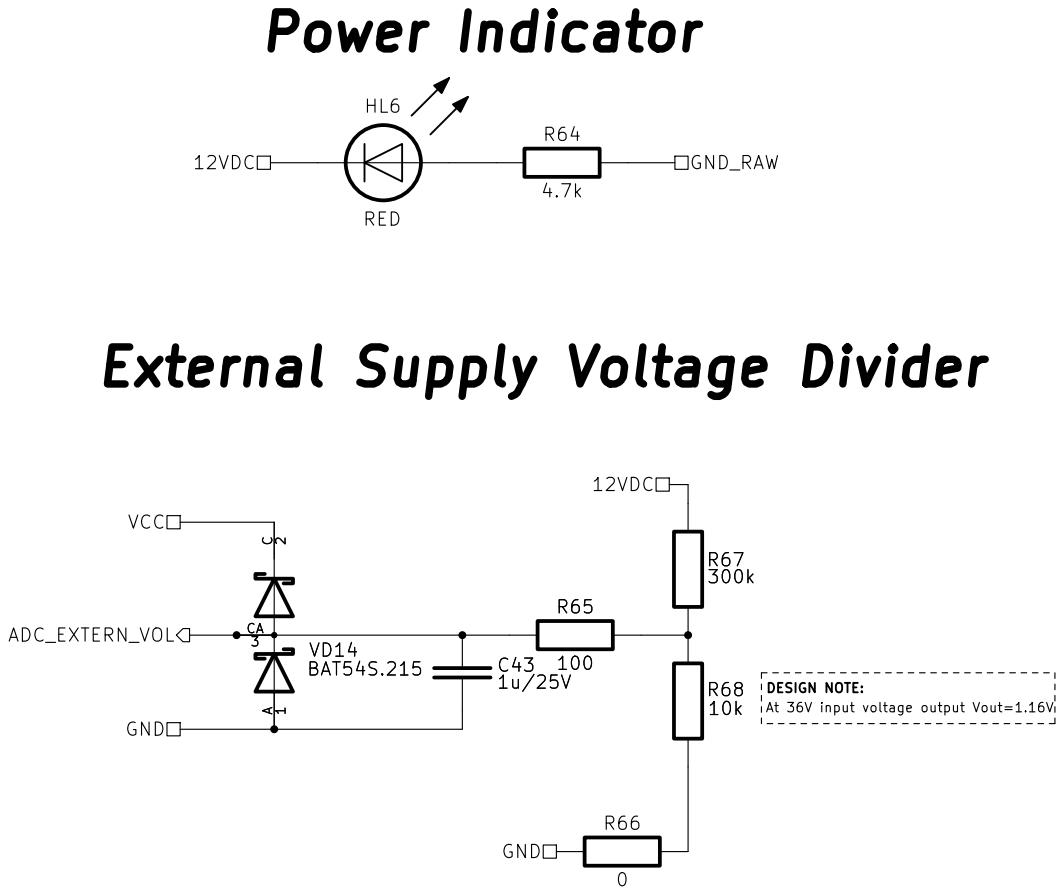
[picture p114: page 24]

External Supply Voltage Divider

DESIGN NOTE: At 36V input voltage output Vout=1.16V

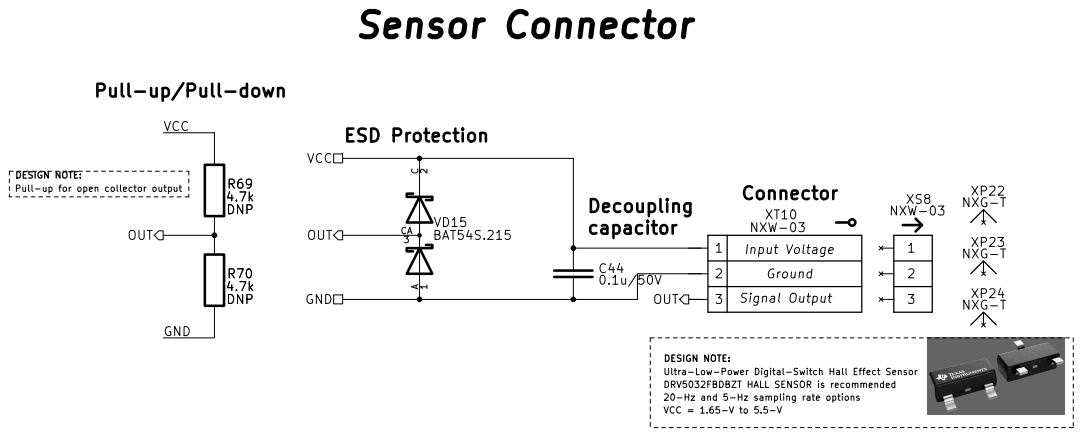
[picture p115: page 25]

VCC = 1.65-V to 5.5-V Pull-up/Pull-down

Ultra-Low-Power Digital-Switch Hall Effect Sensor DRV5032FBDBZT HALL SENSOR is recommended DESIGN NOTE: Pull-up for open collector output

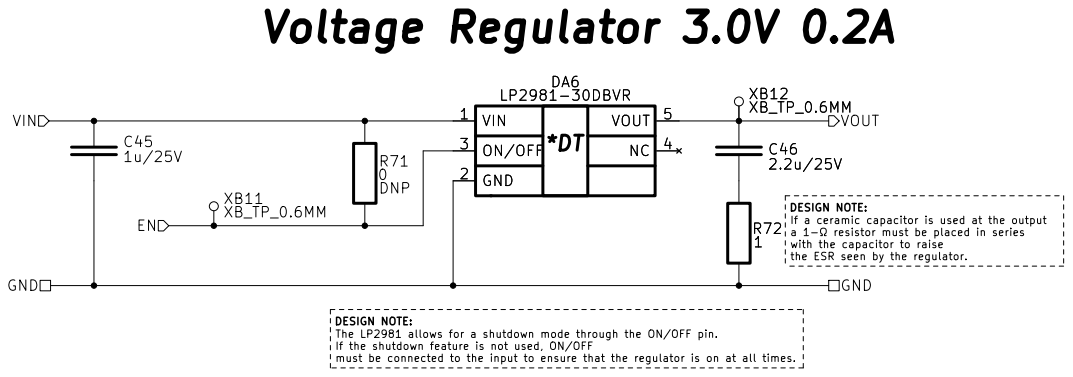
[picture p116: page 26]

DESIGN NOTE: DESIGN NOTE: The LP2981 allows for a shutdown mode through the ON/OFF pin.

If a ceramic capacitor is used at the output
with the capacitor to raise
the ESR seen by the regulator.

If the shutdown feature is not used, ON/OFF must be connected to the input to ensure that the regulator is on at all times.

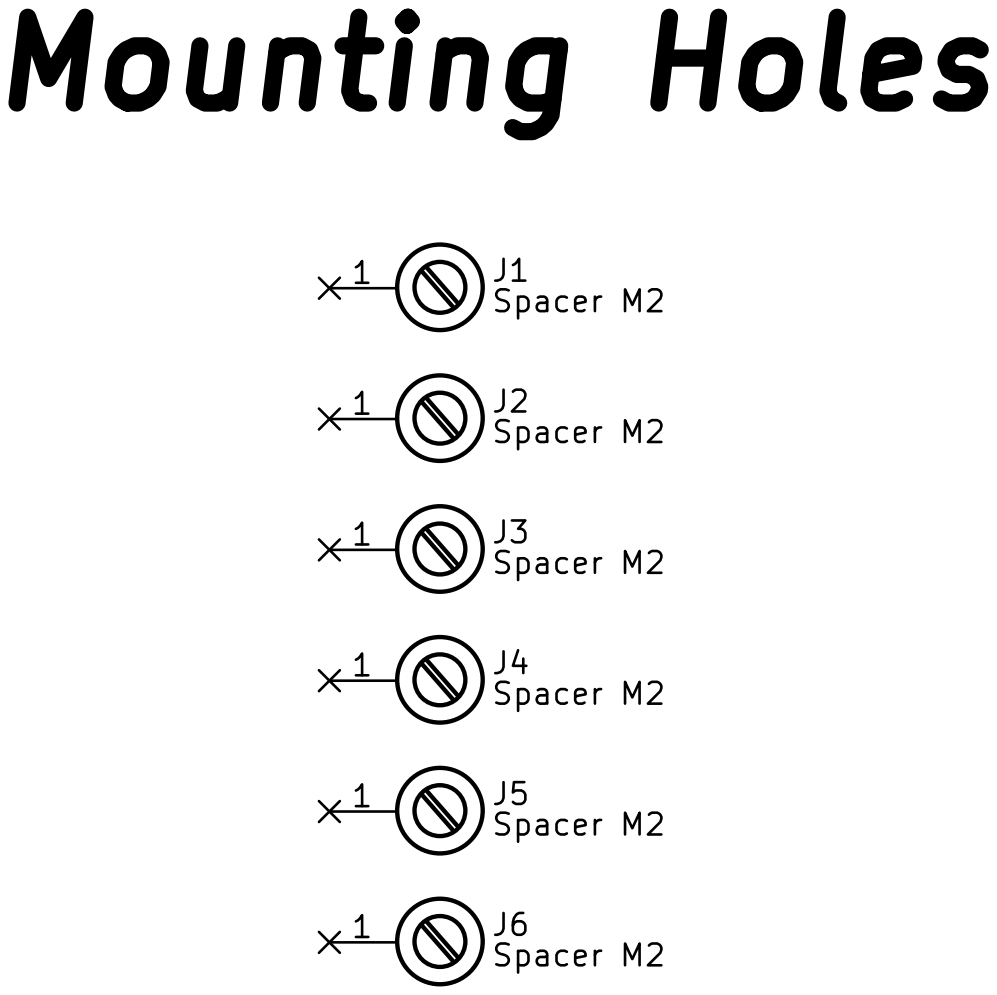
[picture p117: page 27]

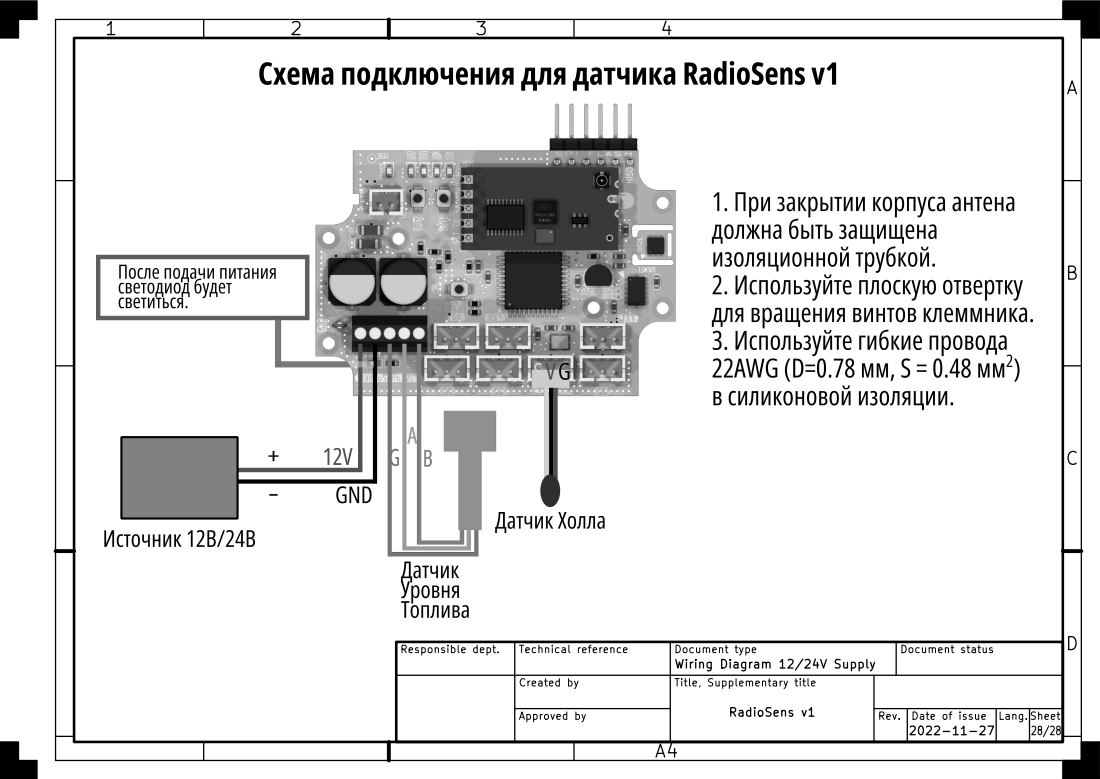
[picture p118: page 28]

Title, Supplementary title RadioSens v1
