Egoruch/HC12/assembly/RadioSens-F_Fab.pdf

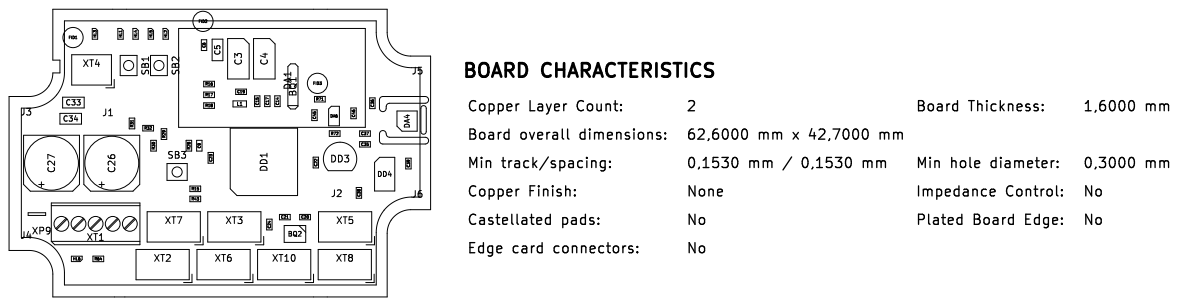
[picture p119: page 1]
