Egoruch/HC12/wiring diagram/RadioSens-Radiosens v1 Wiring Diagram 24V.pdf

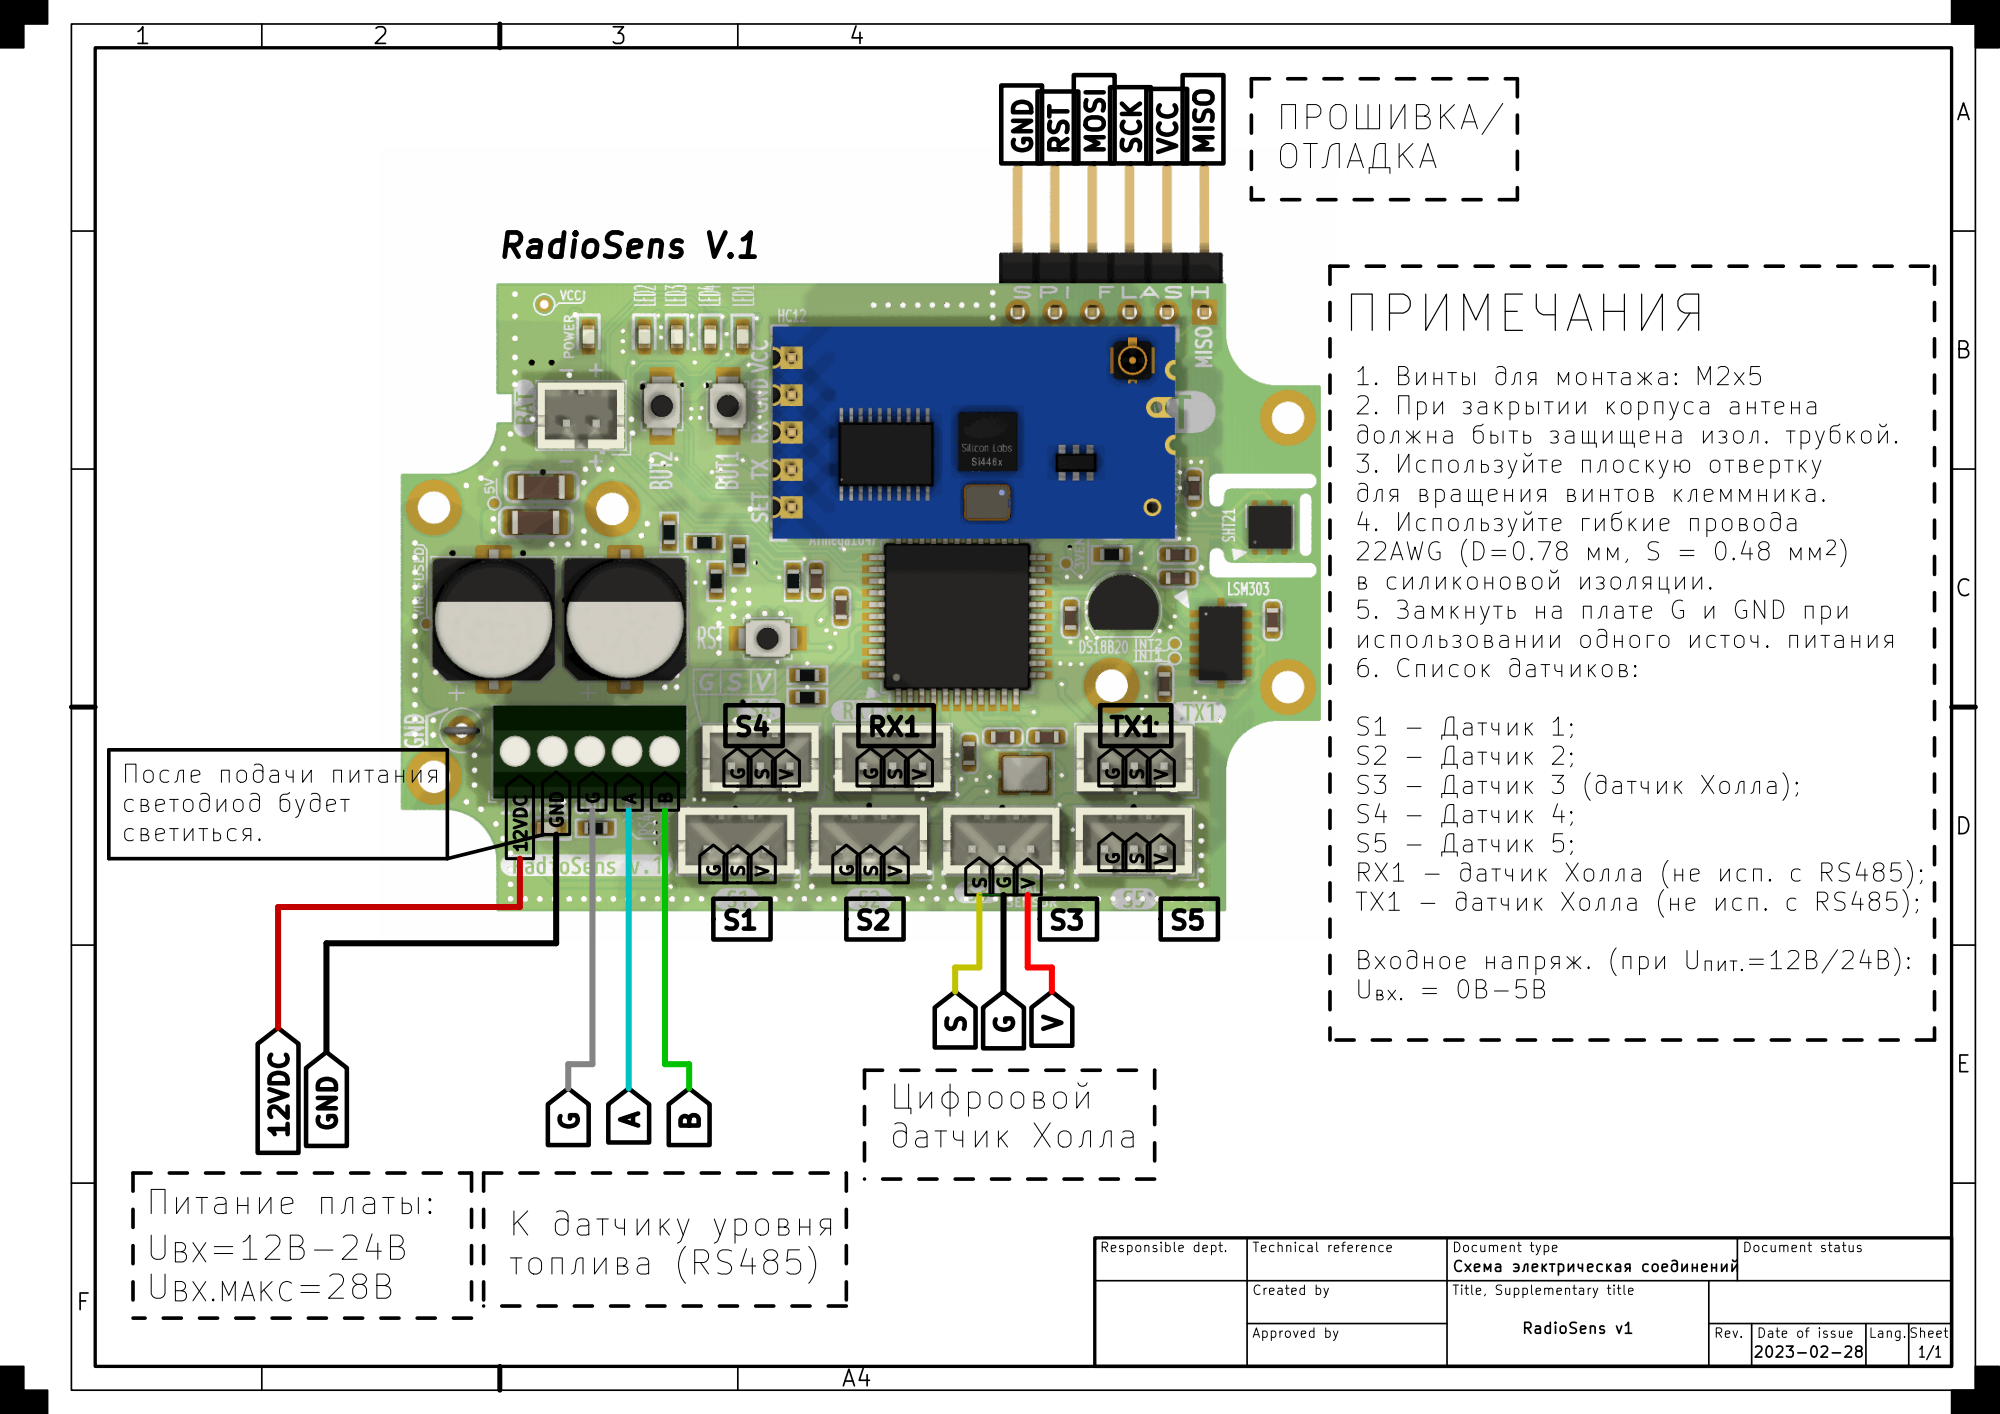
[picture p120: page 1]
