Egoruch/HC12/mechanical/hc12_board Drawing v1.pdf

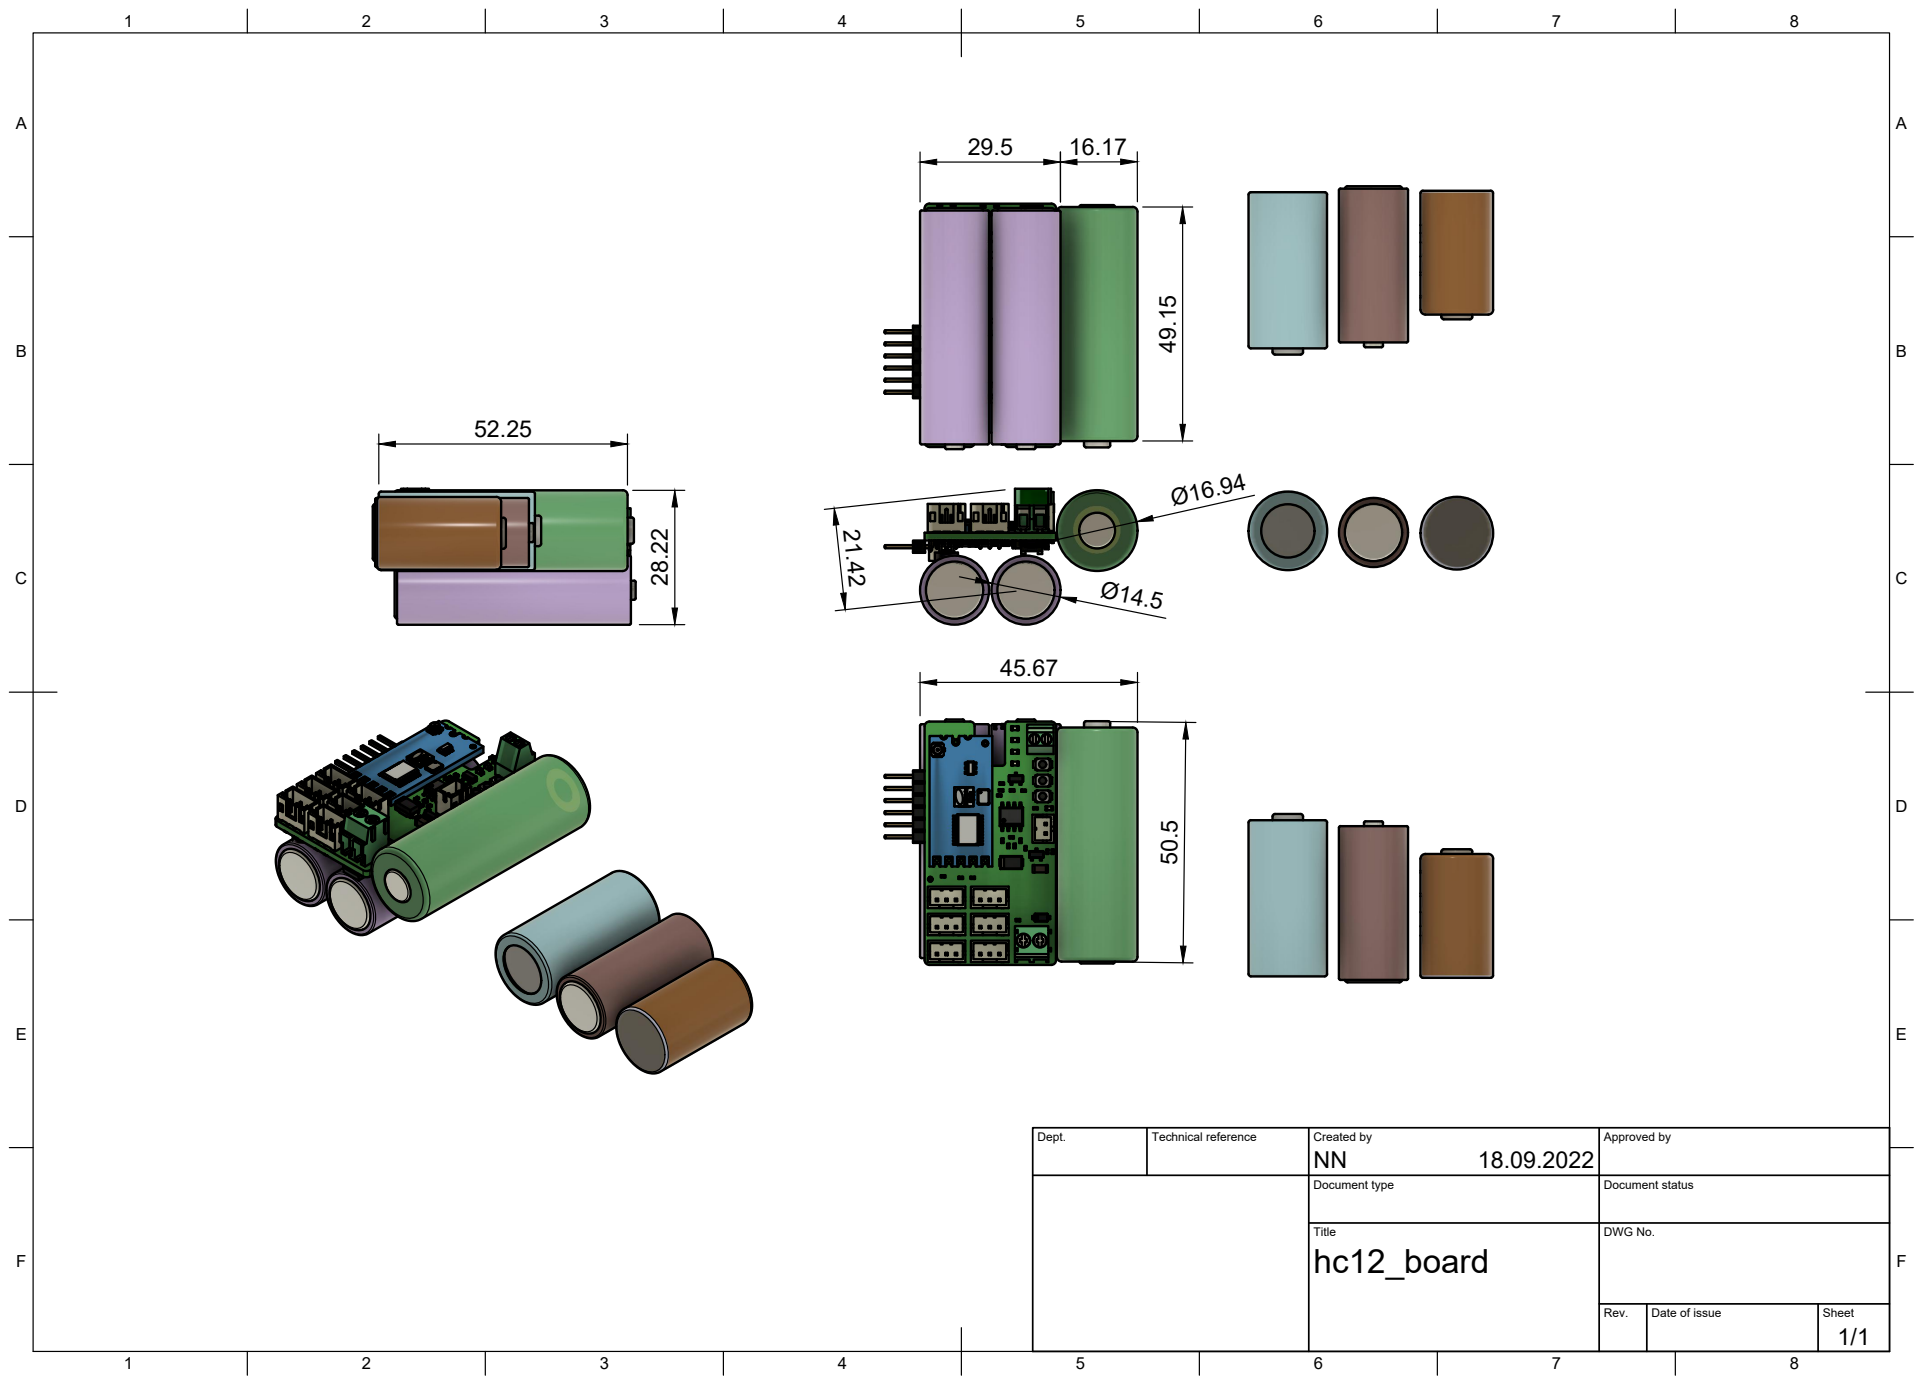
[picture p121: page 1]
Dept.; Technical reference; Created by; Approved by; Document type; Document status; Title; DWG No.; Rev.; Date of issue; Sheet
