Egoruch/HC12/(list of files, drawings)

Other design files:
files/Bluetooth_door+rfid_v2.lay
files/BMS_system_v4.lay
