Egoruch/HC12/kicad/RadioSens.kicad_pcb

## KiCad design kicad/RadioSens.kicad_pcb (2022-10-28)

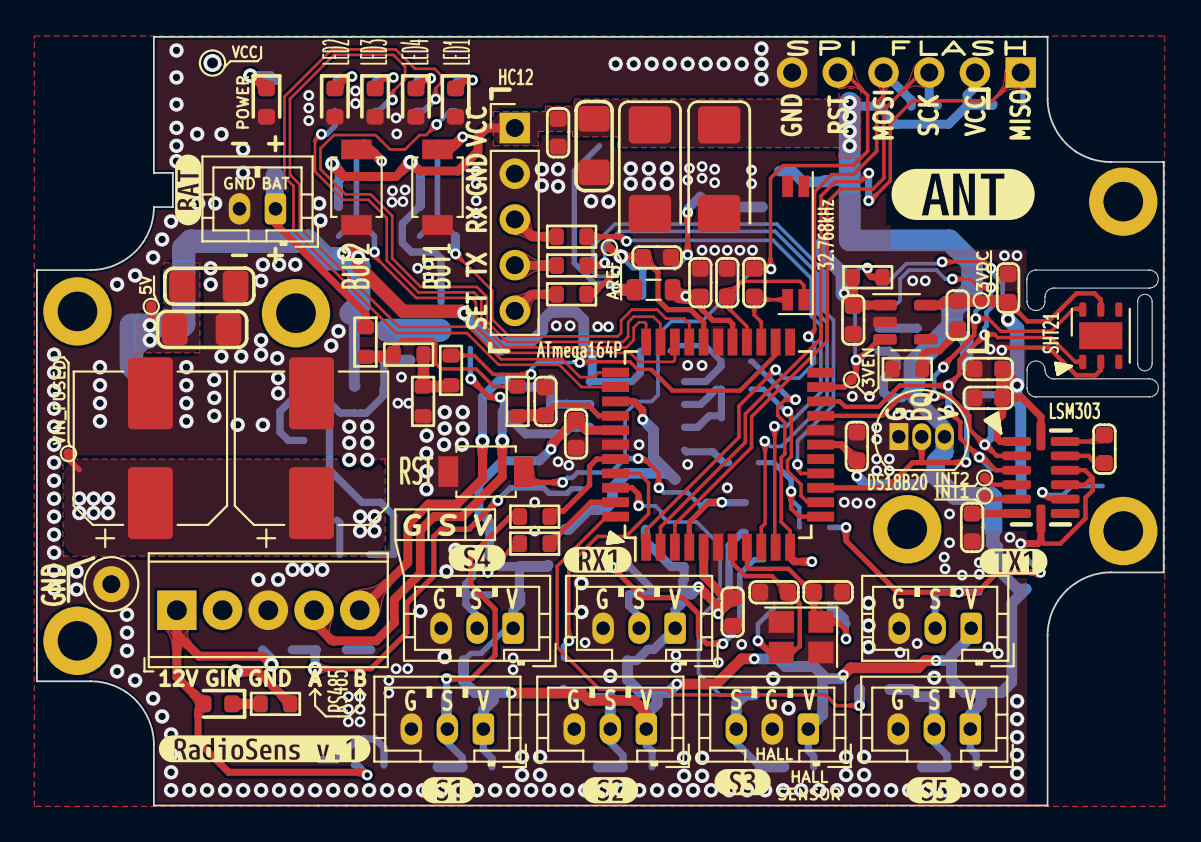
[picture p122: board RadioSens.kicad_pcb from above]

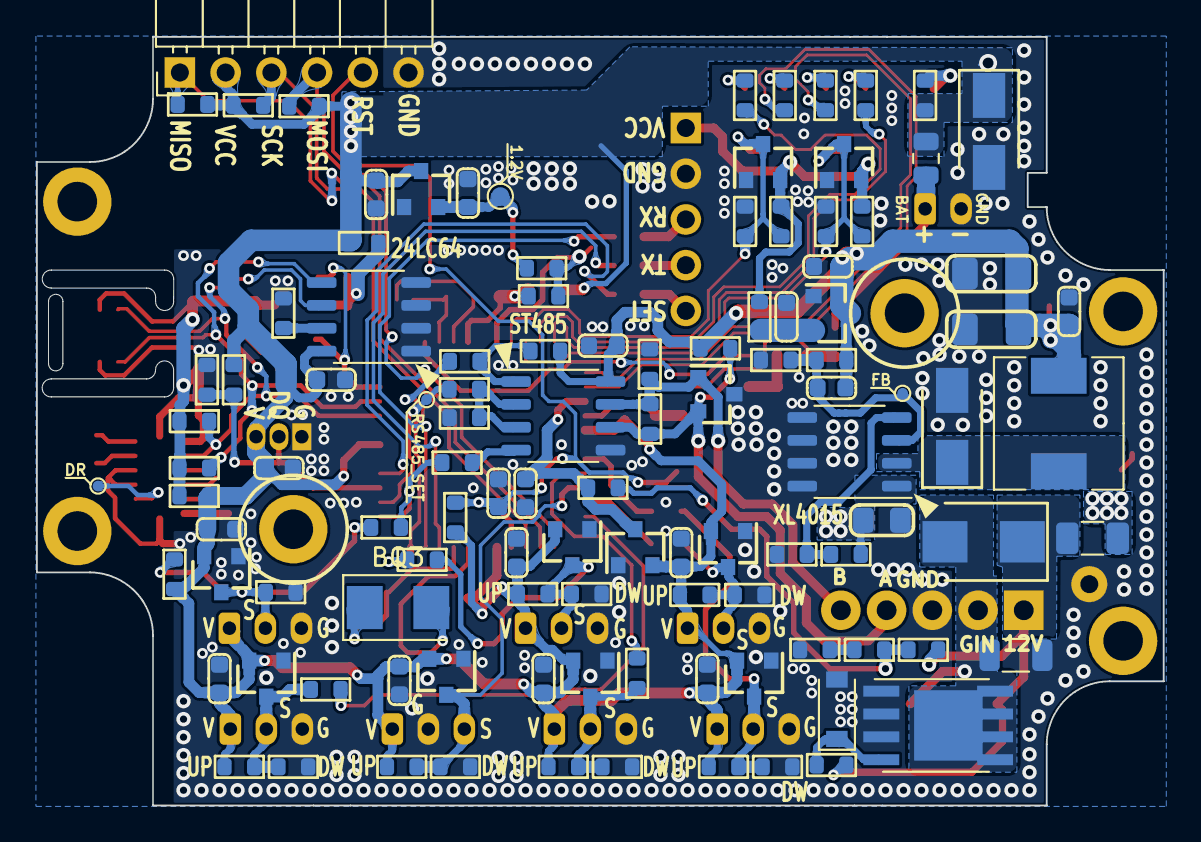
[picture p123: board RadioSens.kicad_pcb from below]

Board: 2 copper layers, 62.6 x 42.7 mm, 200 parts (110 on the bottom side), 81 nets.

Parts:
BQ1: KX–327L; Crystal_SMD_SeikoEpson_MC146-4Pin_6.7x1.5mm
BQ2: 3225 8MHz; Crystal_SMD_3225-4Pin_3.2x2.5mm
BQ3: 5032 8MHz; Crystal_SMD_5032-2Pin_5.0x3.2mm
C1, C7, C9, C30, C43, C45: 1u/25V; C_0603_1608Metric
C2, C6, C8, C10, C11, C12, C13, C15, C19, C22, C23, C24, C25, C36, C37, C40, C44: 0.1u/50V; C_0603_1608Metric
C3, C4: 100u/10V; CP_EIA-6032-28_Kemet-C
C5: 10u/16V; C_1206_3216Metric_Pad1.42x1.75mm_HandSolder
C14, C17: 7/50V; C_0603_1608Metric
C16, C18, C35, C41, C42: 10u/6.3V; C_0603_1608Metric
C20, C21: 22/50V; C_0603_1608Metric
C26, C27: 47u/50V; CP_Elec_8x6.5
C28: 1u/50V; C_0805_2012Metric_Pad1.15x1.40mm_HandSolder
C29: 3.3n/50V; C_0603_1608Metric
C31, C32, C33, C34: 100u/6.3V; C_1206_3216Metric_Pad1.42x1.75mm_HandSolder
C38: 4.7u/6.3V; C_0603_1608Metric
C39: 0.22u/50V; C_0603_1608Metric
C46: 2.2u/25V; C_0603_1608Metric
DA1: HC-12; HC12_PLS
DA2: XC6206P122MR-G; SOT-23
DA3: XL1509; SOP-8_3.9x4.9mm_P1.27mm
DA4: SHT21; DFN-6-1EP_3x3mm_P1mm_EP1.5x2.4mm
DA5: XC6206P332MR; SOT-23
DA6: LP2981-30DBVR; SOT-23-5
DD1: ATmega164PV-10AU; TQFP-44_10x10mm_P0.8mm
DD2: ST485; SOP-8_3.9x4.9mm_P1.27mm
DD3: DS18B20; TO-92_Inline
DD4: LSM303DLHC; LGA-14_3x5mm_P0.8mm_HandSoldering
DD5: 24LC64; SOP-8_3.9x4.9mm_P1.27mm
FU1: 0.3A; Fuse_0805_2012Metric
FU2: 1A; Fuse_1206_3216Metric
HL1, HL2, HL3, HL4, HL5, HL6: RED; LED_0603_1608Metric
J1, J2, J3, J4, J5, J6: Spacer M2; MountingHole_2.2mm_M2_DIN965_Pad
L1: 10u; L_0805_2012Metric
L2: 47uH/2A; L_Wuerth_HCM-7050
R1, R2, R3, R29, R30, R49, R50, R61, R66, R71: 0; R_0603_1608Metric
R4, R5, R6, R16, R17, R18: 22; R_0603_1608Metric
R7, R8, R9, R11, R68: 10k; R_0603_1608Metric
R10: 120; R_0603_1608Metric
R12, R19, R20, R21, R27, R47, R48, R51, R52, R53, R54, R59, R60, R62, R64, R69, R70: 4.7k; R_0603_1608Metric
R13, R14, R22, R23, R24, R25, R31, R33, R34, R36, R37, R38, R39, R41, R42, R44, R45, R67: 300k; R_0603_1608Metric
R15, R26, R28, R35, R40, R43, R46, R65: 100; R_0603_1608Metric
R32, R55, R56: 100k; R_0603_1608Metric
R57: 3.1k; R_0603_1608Metric
R58: 1k; R_0603_1608Metric
R63: 0; R_1206_3216Metric
R72: 1; R_0603_1608Metric
SB1, SB2, SB3: 3x4mm; SW_SPST_B3U-1000P
VD1: CDSOT23-SM712; SOT-23
VD2, VD3, VD4, VD6, VD7, VD8, VD9, VD10, VD14, VD15: BAT54S.215; SOT-23
VD5: SMAJ5.0A; D_SMA
VD11: MBRA340T3G; D_SMA
VD12: SMBJ28CA; D_SMB
VD13: BZT52-C9V1; D_SOD-123
VT1: SIR182DP; PowerPAK_SO-8_Single_HandSoldering
XB1, XB5, XB6, XB7, XB8, XB9, XB10, XB11, XB12: XB_TP_0.6MM; TestPoint_Pad_D0.6mm
XB2, XB3: XB_TP_1.0MM; TestPoint_Pad_D1.0mm
XB4: XB_TP_0.5MM; TestPoint_Pad_D0.5mm
XP9: Testpoint; TestPoint_Loop_D2.50mm_Drill1.0mm_LowProfile
XT1: DG308-2.54-05P-14-00A[H]; TerminalBlock_DG308-2.54-05P-14-00A(H)
XT2, XT3, XT5, XT6, XT7, XT8, XT10: NXW-03; JST_PH_B3B-PH-K_1x03_P2.00mm_Vertical
XT4: NXW-02; JST_PH_B2B-PH-K_1x02_P2.00mm_Vertical
XT9: PLS2.54-6; PinHeader_1x06_P2.54mm_Horizontal
kibuzzard-633978AE: G***; kibuzzard-633978AE
kibuzzard-633978C2: G***; kibuzzard-633978C2
kibuzzard-633978F6: G***; kibuzzard-633978F6
kibuzzard-633979A2: G***; kibuzzard-633979A2
kibuzzard-6339783C: G***; kibuzzard-6339783C
kibuzzard-6339785C: G***; kibuzzard-6339785C
kibuzzard-6339789C: G***; kibuzzard-6339789C
kibuzzard-63397779: G***; kibuzzard-63397779
kibuzzard-63397848: G***; kibuzzard-63397848
kibuzzard-63397852: G***; kibuzzard-63397852

Connections:
3V_EN: DA6.3 (ON/OFF), DD1.21 (PC2_PCINT18/TCK), R71.1, XB11.1
5V: C1.1, C29.1, C30.1, C31.1, C32.1, C33.1, C34.1, C41.1, DA5.3 (IN), DD2.8 (VCC), L2.2, R8.2, R9.2, R57.1, XB7.1
12V: FU2.1, HL6.2 (C), R62.1, R67.1, VD12.1 (C), XT1.1
/3VDC: C35.1, C36.1, C37.1, C46.2, DA4.5 (VDD), DA6.5 (VOUT), DD4.1 (VDDIO), DD4.14 (VDD), R3.2, R59.1, R60.1, XB12.1
/Battery/BAT_UNFUSED: FU1.2, R31.1, XT4.1
/DC-DC XL1509/EN: DA3.4 (EN), R55.2, R56.1
/DC-DC XL1509/FB: C29.2, DA3.3 (FB), R57.2, R58.1, XB6.1
/DC-DC XL1509/OUT: DA3.2 (OUT), L2.1, VD11.1 (C)
/DC-DC XL1509/VIN_FUSED: C26.1 (+), C27.1 (+), C28.1, DA3.1 (VIN), FU2.2, R55.1, XB5.1
/GND_RAW: R63.2, R64.1, VD12.2 (A), VT1.5 (D), VT1.6 (D), VT1.7 (D), VT1.8 (D), XT1.2
/IIC Connector/C1: C38.1, DD4.6 (C1)
/IIC Connector/INT1: DD4.5 (INT1), XB9.1
/IIC Connector/INT2: DD4.4 (INT2), XB8.1
/IIC Connector/SETC: C39.1, DD4.13 (SETC)
/IIC Connector/SETP: C39.2, DD4.12 (SETP)
/RS485/A_RS485: DD2.6 (A), R9.1, R10.2, VD1.2 (C2), XT1.4
/RS485/B_RS485: DD2.7 (B), R10.1, R11.2, VD1.1 (C1), XT1.5
/RS485/DE: DD2.2 (RE), DD2.3 (DE), R5.2, R7.2
/Sensor 1/SIGNAL: R13.2, R14.1, R15.2, VD2.3 (CA), XT2.2
/Sensor 2/SIGNAL: R38.2, R39.1, R40.2, VD8.3 (CA), XT6.2
/Sensor 4/SIGNAL: R41.2, R42.1, R43.2, VD9.3 (CA), XT7.2
/Sensor 5/SIGNAL: R44.2, R45.1, R46.2, VD10.3 (CA), XT8.2
/Sensor 6/SIGNAL: R24.2, R25.1, R26.2, VD4.3 (CA), XT3.2
/Sensor 7/SIGNAL: R33.2, R34.1, R35.2, VD6.3 (CA), XT5.2
/Voltage Regulator 3.3V/VOUT: C42.1, DA5.2 (OUT), R1.2
/Voltage Regulator 3V/VIN: C45.1, DA6.1 (VIN), R2.2, R71.2
ADC_BAT_VOL: C9.1, DD1.37 (PA0_ADC0/PCINT0), R28.1
ADC_EXTERN_VOL: C43.1, DD1.36 (PA1_ADC1/PCINT1), R65.1, VD14.3 (CA)
AREF: C19.2, DD1.29 (AREF), R49.2, R50.2, XB4.1
AVCC: C15.2, DD1.27 (AVCC), L1.2, R49.1
BAT_DIV_EN: DD1.24 (PC5_TDI/PCINT21), R29.1
BUT_1: DD1.30 (PA7_ADC7/PCINT7), R36.2, R37.1, SB2.1, VD7.3 (CA)
BUT_2: DD1.31 (PA6_ADC6/PCINT6), R22.2, R23.1, SB1.1, VD3.3 (CA)
DS18B20_DQ: DD1.14 (PD5_PCINT29/OC1A), DD3.2 (DQ), R19.2, R20.1
GND: BQ2.2 (GND), BQ2.4 (GND), C1.2, C2.2, C3.2 (-), C4.2 (-), C5.2, C6.2, C7.2, C8.2, C9.2, C10.2, C11.2, C12.2, C13.2, C14.2, C15.1, C16.2, C17.2, C18.2, C19.1, C20.2, C21.2, C22.2, C23.2, C24.1, C25.2, C26.2 (-), C27.2 (-), C28.2, C30.2, C31.2, C32.2, C33.2, C34.2, C35.2, C36.2, C37.2, C38.2, C40.2, C41.2, C42.2, C43.2, C44.2, C45.2, DA1.2 (GND), DA2.1 (GND), DA3.5 (GND), DA3.6 (GND), DA3.7 (GND), DA3.8 (GND), DA4.2 (VSS), DA5.1 (GND), DA6.2 (GND), DD1.6 (GND), DD1.18 (GND), DD1.28 (GND), DD1.39 (GND), DD2.5 (GND), DD3.1 (GND), DD4.7 (GND), DD4.10 (GND), DD4.11 (GND), DD5.1 (A0), DD5.2 (A1), DD5.3 (A2), DD5.4 (VSS), HL1.2 (C), HL2.2 (C), HL3.2 (C), HL4.2 (C), HL5.2 (C), R7.1, R11.1, R14.2, R20.2, R23.2, R25.2, R30.1, R34.2, R37.2, R39.2, R42.2, R45.2, R56.2, R58.2, R61.2, R63.1, R66.1, R70.2, R72.1, SB1.2, SB2.2, SB3.1, VD1.3 (DC), VD2.1 (A), VD3.1 (A), VD4.1 (A), VD5.2 (A), VD6.1 (A), VD7.1 (A), VD8.1 (A), VD9.1 (A), VD10.1 (A), VD11.2 (A), VD13.2 (A), VD14.1 (A), VD15.1 (A), VT1.1 (S), VT1.2 (S), VT1.3 (S), XP9.1, XT1.3, XT2.3, XT3.3, XT4.2, XT5.3, XT6.3, XT7.3, XT8.3, XT9.6, XT10.2
HC12_SET: DD1.15 (PD6_PCINT30/OC2B/ICP), R18.2
IIC_SCL: DA4.6 (SCL), DD1.19 (PC0_PCINT16/SCL), DD4.2 (SCL), DD5.6 (SCL), R60.2
IIC_SDA: DA4.1 (SDA), DD1.20 (PC1_PCINT17/SDA), DD4.3 (SDA), DD5.5 (SDA), R59.2
LED_1: DD1.32 (PA5_ADC5/PCINT5), R21.1
LED_2: DD1.33 (PA4_ADC4/PCINT4), R12.1
LED_3: DD1.34 (PA3_ADC3/PCINT3), R47.1
LED_4: DD1.35 (PA2_ADC2/PCINT2), R48.1
MISO: DD1.2 (PB6_PCINT14/OC3A/MISO), R53.2, XT9.1
MOSI: DD1.1 (PB5_PCINT13/ICP3/MOSI), R51.2, XT9.4
unnamed: C18.1, DA2.2 (OUT), R50.1, XB3.1
unnamed: C46.1, R72.2
unnamed: DA1.3 (RXD), R16.1
unnamed: DA1.4 (TXD), R17.1
unnamed: DA1.5 (SET), R18.1
unnamed: DD2.1 (RO), R4.2, R8.1
unnamed: DD2.4 (DI), R6.2
unnamed: DD4.9 (DRDY), XB10.1
unnamed: DD5.7 (WP), R61.1
unnamed: HL1.1 (A), R12.2
unnamed: HL2.1 (A), R21.2
unnamed: HL3.1 (A), R27.2
unnamed: HL4.1 (A), R47.2
unnamed: HL5.1 (A), R48.2
unnamed: HL6.1 (A), R64.2
unnamed: R28.2, R31.2, R32.1
unnamed: R29.2, R30.2, R32.2
unnamed: R62.2, VD13.1 (C), VT1.4 (G)
unnamed: R65.2, R67.2, R68.1
unnamed: R66.2, R68.2
RESET: C25.1, DD1.4 (~RESET), R54.2, SB3.2, XT9.5
RS485_SET: DD1.13 (PD4_PCINT28/XCK1/OC1B), R5.1, XB1.1
RXD0: DD1.9 (PD0_PCINT24/RXD0/T3*), R17.2
RXD1: DD1.11 (PD2_PCINT26/RXD1/INT0), R4.1, R26.1
SCK: DD1.3 (PB7_PCINT15/OC3B/SCK), R52.2, XT9.3
SENS_1: DD1.40 (PB0_XCK0/T0/PCINT8), R15.1
SENS_2: DD1.41 (PB1_T1/CLKO/PCINT9), R40.1
SENS_3: DD1.42 (PB2_AIN0/INT2/PCINT10), R69.2, R70.1, VD15.3 (CA), XT10.3
SENS_4: DD1.43 (PB3_AIN1/OC0A/PCINT11), R43.1
SENS_5: DD1.44 (PB4_SS/OC0B/PCINT12), R46.1
TOSC1: BQ1.4, C14.1, DD1.25 (PC6_TOSC1/PCINT22)
TOSC2: BQ1.1, C17.1, DD1.26 (PC7_TOSC2/PCINT23)
TXD0: DD1.10 (PD1_PCINT25/TXD0), R16.2
TXD1: DD1.12 (PD3_PCINT27/TXD1/INT1), R6.1, R35.1
VCC: C2.1, C3.1 (+), C4.1 (+), C5.1, C6.1, C7.1, C8.1, C10.1, C11.1, C12.1, C13.1, C16.1, C22.1, C23.1, C24.2, C40.1, C44.1, DA1.1 (VCC), DA2.3 (IN), DD1.5 (VCC), DD1.17 (VCC), DD1.38 (VCC), DD3.3 (VDD), DD5.8 (VCC), FU1.1, L1.1, R1.1, R2.1, R3.1, R13.1, R19.1, R22.1, R24.1, R27.1, R33.1, R36.1, R38.1, R41.1, R44.1, R51.1, R52.1, R53.1, R54.1, R69.1, VD2.2 (C), VD3.2 (C), VD4.2 (C), VD5.1 (C), VD6.2 (C), VD7.2 (C), VD8.2 (C), VD9.2 (C), VD10.2 (C), VD14.2 (C), VD15.2 (C), XB2.1, XT2.1, XT3.1, XT5.1, XT6.1, XT7.1, XT8.1, XT9.2, XT10.1
XTAL1: BQ2.1 (IN), BQ3.1, C20.1, DD1.8 (XTAL1)
XTAL2: BQ2.3 (OUT), BQ3.2, C21.1, DD1.7 (XTAL2)
