Egoruch/HC12/(commit log)

2022-10-04 Upload latest version; Rouring done, gerber out done
    [Z96_2000_CUTOUT.dxf, battery.kicad_sch, button.kicad_sch, dc-dc_mp2307.kicad_sch, dc_connector.kicad_sch, ds18b20.kicad_sch, hall_sensor.kicad_sch, hc12.kicad_sch]
2022-10-04 Reannotate schematic; Fix 5032 crystal footprint field; Update PCB with 5032 crystal
    [HC-12 Work time.xlsx, RadioSens_BOM.xlsx, battery.kicad_sch, button.kicad_sch, dc-dc_mp2307.kicad_sch, dc_connector.kicad_sch, ds18b20.kicad_sch, hall_sensor.kicad_sch]
2022-10-06 Add voltage value to caps, update BOM, SCH, ASM
    [HC-12 Work time.xlsx, RadioSens-BOM-R01.xlsx, RadioSens.kicad_pcb, RadioSens.kicad_sch, RadioSens_BOM.xlsx, battery.kicad_sch, button.kicad_sch, dc-dc_mp2307.kicad_sch]
2022-10-06 Generate Gerber files with Paste layers
    [HC-12 Work time.xlsx, RadioSens Working Hours.xlsx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]
2022-10-06 Update work hours and last report
    [RadioSens Working Hours.xlsx]
2022-10-28 Add docs; Update values of components according to PCB
    [RadioSens Working Hours (STAGE 1).xlsx, RadioSens Working Hours (STAGE 2).xlsx, RadioSens Working Hours.xlsx, RadioSens-BOM-R01.xlsx, RadioSens-MEC-R01.xlsx, RadioSens.kicad_pcb, RadioSens.kicad_sch, dc-dc_mp2307.kicad_sch]
2022-10-30 Add Vin.MIN=5.5V to schematic DC-DC note
    [RadioSens Working Hours (STAGE 2).xlsx, dc-dc_mp2307.kicad_sch]
2022-11-27 Add wiring diagram; Add work ours (stage 2); refactor folders
    [RadioSens Working Hours (STAGE 2).xlsx, RadioSens.kicad_sch, Z96_2000_CUTOUT.dxf, battery.kicad_sch, button.kicad_sch, dc-dc_mp2307.kicad_sch, dc_connector.kicad_sch, ds18b20.kicad_sch]
2023-05-08 add: more latest files
    [RadioSens_Wiring_Diagram.kicad_sch, Z96_2000_CUTOUT.dxf, radiosens_wiring_1.kicad_sch, Учет трат RadioSens.xlsx]
2023-09-27 remove: temporary kicad file
2023-09-27 update: to 7.0 ver and add fiducials
    [RadioSens.kicad_sch, battery.kicad_sch, button.kicad_sch, dc-dc_mp2307.kicad_sch, dc_connector.kicad_sch, ds18b20.kicad_sch, fiducials.kicad_sch, hall_sensor.kicad_sch]
2023-09-27 add: another one fiducial
    [fiducials.kicad_sch]
2023-10-04 update: gerber and add bom notes
    [RadioSens-B_Cu.gbr, RadioSens-B_Mask.gbr, RadioSens-B_Paste.gbr, RadioSens-B_Silkscreen.gbr, RadioSens-Edge_Cuts.gbr, RadioSens-F_Cu.gbr, RadioSens-F_Mask.gbr, RadioSens-F_Paste.gbr]
2023-11-16 add: bom notes and asm files
    [RadioSens-BOM-ORDER-R01.xlsx, RadioSens-BOM-R01.csv, RadioSens-MEC-ORDER-R01.xlsx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]
2023-11-19 add: separated BOMs and modified common
    [RadioSens-BOM-BASE.csv, RadioSens-BOM-R01.csv, RadioSens-BOM-SENS.csv]
